TheGiraffe/BBB-Schematics-Resources/Other Formats/beaglebone-black-master/BBB_BOM.csv

QTY | REFERENCE | DESCRIPTION | MANU | PART NUMBER | REV PROD_C
1 |  | 3' USB Cable, 5pin AB to Type A | CableWholesale | 10UM-02103BK | Assembly marked as RevC
 |  |  | LingLongDa | 321010005
 |  |  | Molex | 887328602
1 |  | ESD Bag | 3M | 10035 | 3/24/13
1 |  | BOX
1 |  | BeagleBoneBlack PCB Assy Rev C
1 |  | 3.5" x 2.15" 6 Layer PCB, REV B6 | Various
24 | C1,C2,C4,C7,C8,C9,C10,C11,C12,C13,C14,C15,C39,C40,C55,C62,C77,C95,C96,C118,C122,C126,C133,C153 | CAP CER 10UF 10V Y5V 0805 | TDK | C2012Y5V1A106Z | Soon to be obsoleted.
 |  |  | Murata | GRM21BR71A106KE51L
 |  |  | YAGEO | CC0805ZKY5V6BB106
6 | C89,C90,C91,C104,C106,C134 | CAP CER 1UF 6.3V 10% X5R 0402 | Tayo Yuden | JMK105BJ105KV-F
 |  |  | TDK | C1005X5R0J105K
 |  |  | NIC | NMC0402X5R105K6.3TRPF
 |  |  | Murata | GRM155R60J105KE19D
 |  |  | YAGEO | CC0402KRX5R6BB105
9 | C16,C17,C18,C125,C144,C146,C148,C151,C24 | CAP CER 2.2UF 6.3V 10% X5R 0402 | TDK | C1005X5R0J225K | Soon to be obsoleted.
 |  |  | TDK | C1005X5R0J225K050BC
 |  |  | YAGEO | CC0402MRX5R5BB225
 |  |  | AVX | 04026D225KAT2A
 |  |  | YAGEO | CC0402MRX5R5BB225
2 | C19,C136 | CAP CER 470PF 50V 10% X7R 0402 | Yageo | CC0402KRX7R9BB471
 |  |  | Murata | GRM155R71H471KA01D
99 | C3,C20,C27,C28,C29,C30,C31,C33,C35,C36,C37,C38,C41,C42,C43,C44,C45,C46,C47,C48,C49,C50,C51,C52,C53,C54,C56,C57,C58,C59,C60,C61,C63,C64,C65,C66,C67,C68,C69,C70,C71,C72,C73,C74,C75,C76,C78,C79,C80,C81,C82,C83,C84,C85,C86,C87,C88,C92,C93,C94,C97,C98,C99,C100,C101,C102,C103,C105,C106,C107,C108,C109,C110,C111,C112,C113,C114,C115,C116,C117,C119,C120,C121,C124,C127,C128,C129,C130,C131,C132,C135,C145,C147,C149,C150,C152,C154,C155,C158,C159 | CAP CER 0.1UF 6.3V 10% X5R 0402 | TDK | C1005X5R0J104K | Soon to be obsoleted.
 |  |  | Murata | GRM155R60J104KA01D
 |  |  | NIC | NMC0402X5R104K6.3TRPF
 |  |  | Kemet | C0402C104K9PACTU
 |  |  | TDK | C1005X5R0J104K050BA
 |  |  | YAGEO | CC0402KRX7R7BB104
4 | C21,C22,C25,C26 | CAP CER 18PF 50V C0G 5% 0402 | TDK | C1005C0G1H180J
 |  |  | Murata | GRM1555C1H180JZ01D | Soon to be obsoleted.
 |  |  | NIC | NMC0402NPO180J50TRPF
 |  |  | Murata | GRM1555C1H180JA01D
 |  |  | YAGEO | CC0402JRNPO9BN180
2 | C32,C123 | CAP_CER_0.001UF_16V_X7R_0402 | Yageo | CC0402KRX7R7BB102
1 | C34 | Aluminum Electrolytic Capacitors - SMD 100uF 6.3V 85C | Cornell Dublier | AVE107M06D16T-F
 |  |  | ST | CS1A101M-CRE54
1 | C141 | CAP CER 0.022UF 10V 10% X7R 0402 | Tayo Yuden | LMK105B7223KV-F
 |  |  | YAGEO | CC0402KRX7R9BB223
2 | C142,C143 | CAP CER 30PF 50V 5% NP0 0402 | TDK | C1005C0G1H300J
 |  |  | Murata | GRM1555C1H300JA01D
 |  |  | YAGEO | CC0402JRNPO9BN330
16 | C156,C157,C160,C161,C162,C163,C164,C165,C166,C167,C168,C169,C170,C171,C172,C173 | CAP CER 47PF 50V 5% NPO 0402 | Yaego | CC0402JRNPO9BN470
 |  |  | Tayo Yuden | UMK105CG470JV-F
5 | D1,D2,D3,D4,D5 | LED BLUE CLEAR THIN 0603 SMD | Lite-On | LTST-C191TBKT
 |  |  | Everlight | 19-217/BHC-ZL1M2RY/3T
2 | D6,D7 | DIODE ESD PROT HDMI TSSOP-10 | NXP | IP4283CZ10-TT,118 | Soon to be obsoleted.
 |  |  | TI | TPD4S009DGSR
1 | D8 | DIODE SCHOTTKY 40V 120MA SOD-323 | NXP | RB751V40,115
6 | FB1,FB2,FB3,FB4,FB5,FB7 | Ferrite Bead 150 Ohm 800mA | Laird-Signal Integrity | LI0805H151R-10
3 | S1,S2,S3 | SWITCH TACTILE SPST-NO 0.05A 32V | C&K | KMR231GLFS
2 | Q1,Q2 | TRANS NPN/NPN W/RES 50V SMINI6 | Panasonic | DMC564040R
 |  |  | Diodes, Inc | DDC114YU-7-F
1 | RT1 | POLYSWITCH RXE SERIES 0.10A HOLD | TE Connectivity | RXEF010
3 | L1,L2,L3 | INDUCTOR 2.2UH 20% 1300MA 1008 | Murata | LQM2HPN2R2MG0L
1 | J1 | CONN HEADER 6POS, VERTICAL, .100 STR TIN | FCI | 68000-406HLF
 |  |  | YUXI å® ç | P125-1106A1BS116A1
2 | P8,P9 | NN HEADER FMAL 46PS.1" DL GOLD | MLE | SSHS-123-D-02-GT-LFÙ Ù Ù Ù
 |  |  | SINOTOP æ æ å± | FF-1236
 |  |  | Sullins | PPPC232LFBN-RC
1 | P1 | CONN POWER JACK 2.1MM | CUI | PJ-002A
 |  |  | CUI | PJ-002AH
 |  |  | MTCONN | DC630-20D01
1 | P4 | CONN RCPT USB MINI B R/A SMD | Hirose | UX60SC-MB-5ST(80)
1 | P5 | RJ-45 10/100 W/Magnetics | Link PP | LPJ0011BBNL
1 | P3 | CONN RCPT USB TYPE A R/A PCB | FCI | 87520-0010BLF
 |  |  | Foxconn | UB11123-4H9-4F
1 | P10 | Connector SD/MMC | ALPS | SCHA5B0200 | Soon to be obsoleted, no replacement found. Continues to fill orders.
1 | P6 | HDMI / Displayport / DVI Connectors MICRO HDMI RCPT SMT DIP+ SMT LEG TYPE D | FCI | 10118241-001RLF
6 | R23,R24,R25,R26,R163,R164 | RES 4.75K OHM 1/16W 1% 0402 SMD | Stackpole | RMCF0402FT4K75
 |  |  | KOA | RK73H1ETTP4751F
 |  |  | Vishay | CRCW04024K75FKED
 |  |  | NIC | NRC04F4751TRF
 |  |  | YAGEO | RC0402JR-074K7L
4 | R71,R72,R73,R74 | RES 2.2K-5%-1/16W;0402 SMD | YAGEO | RC0402JR-072K2L
1 | R144 | RES 12.1K OHM 1/16W 1% 0402 SMD | Yageo | RC0402FR-0712K1L
2 | R136,FB8 | RES .10 OHM 1/8W 5% 0805 | CTS | 73L3R10J
 |  |  | YAGEO | RL0805JR-070R1L
9 | R3,R4,R97,R112,R113,R114,R119,R146,R147 | RES 1.50K OHM 1/16W 1% 0402 SMD | Yageo | RC0402FR-071K5L
 |  |  | NIC | NRC04F1501TRF
3 | R12,R130,R132 | RES 470 OHM 1/10W 5% 0402 SMD | Panasonic | ERJ-2GEJ471X
 |  |  | YAGEO | RC0402JR-07470RL
22 | R1,R56,R65,R66,R67,R68, R76,R77,R78,R79,R80,R82,R83,R84,R85,R86, R87,R88, R89, R94,R95,R165 | Resistor 100Kohm 1/16W 1% 0402 | Stackpole | RMCF0402FT100K
 |  |  | Vishay | CRCW0402100KFKED
 |  |  | Yageo | RC0402FR-07100KL
 |  |  | NIC | NRC04F1003TRF
11 | R75,R125,R126,R127,R128,R129,R131,R133,R134,R138,R139 | RES 100 OHM 1/16W 5% 0402 SMD | Yageo | RC0402JR-07100RL
 |  |  | KOA | RK73B1ETTP101J
 |  |  | ROHM | MCR01MZPF1000
 |  |  | STACKPOLE | RMCF0402JT100R
 |  |  | NIC | NRC04J101TRF
1 | R143 | RES 10.0 OHM 1/16W 1% 0402 SMD | Yageo | RC0402FR-0710RL
 |  |  | KOA | RK73H1ETTP10R0F
 |  |  | STACKPOLE | RMCF0402FT10R0
 |  |  | NIC | NRC04F10R0TRF
22 | R5,R6,R7,R8,R19,R20,R27,R29,R30,R49,R50,R51,R137,R142,R149,R159,R160,R161,R162,R46,R47,R48.C127 | Resistor Zero ohm Jumper 0402 | Yageo | RC0402JR-070RL
 |  |  | VISHAY TECHNOLOGY | CRCW04020000Z0ED
 |  |  | STACKPOLE | RMCF0402ZT0R00
 |  |  | ROHM | MCR01MZPJ000
 |  |  | KOA | RK73Z1ETTP
 |  |  | NIC | NRC040TRF
1 | R45 | Resistor 22ohm 1/16W 1% 0402 | Yageo | RC0402FR-0722RL
 |  |  | KOA | RK73B1ETTP220J
 |  |  | Stackpole | RMCF0402JT33R0
 |  |  | Vishay | CRCW040222R0JNED
 |  |  | NIC | NRC04J220TRF
34 | R14,R52,R53,R54,R96,R98,R100,R101,R102,R103,R104,R105,R106,R107,R108,R109,R110,R111,R115,R116,R117,R118,R135,R145,R148,R150,R151,R152,R153,R154,R155,R156,R157,R158 | Resistor 10Kohm 1/16W 5% 0402 | Rohm | MCR01MZPJ103
 |  |  | KOA | RK73B1ETTP103J
 |  |  | ROHM | MCR01MRTJ103
 |  |  | Stackpole | RMCF0402JT10K0
 |  |  | Vishay | CRCW040210K0JNED
 |  |  | YAGEO | RC0402FR-0710KL
1 | R17 | Resistor 1Mohm 1/16W 1% 0402 | Stackpole | RMCF0402FT1M00
 |  |  | Vishay | CRCW04021M00FKED
 |  |  | Yageo | RC0402FR-071ML
 |  |  | NIC | NRC04F1004TRF
5 | R22,R120,R121,R122,R123 | RES 49.9 OHM 1/16W 1% 0402 SMD | Yageo | RC0402FR-0749R9L
 |  |  | KOA | RK73H1ETTP49R9F
 |  |  | NIC | NRC04F49R9TRF
1 | R11 | RES TF 1/16W 280K OHM 1% 0402 | Stackpole | RMCF0402FT280K
 |  |  | Vishay | CRCW0402280KFKED
 |  |  | NIC | NRC04F2803TRF
 |  |  | YAGEO | RC0402FR-07280KL
1 | R99 | RES 240 OHM 1/16W 1% 0402 SMD | Yageo | RC0402FR-07240RL
 |  |  | Stackpole | RMCF0402FT240R
 |  |  | ROHM | MCR01MZPF2400
 |  |  | Vishay | CRCW0402240RFKED
 |  |  | NIC | NRC04F2400TRF
1 | R10 | RES 470K OHM 1/16W 1% 0402 SMD | Yageo | RC0402FR-07470KL
 |  |  | Stackpole | RMCF0402FT470K
 |  |  | Vishay | CRCW0402470KFKED
 |  |  | NIC | NRC04F4703TRF
1 | R166 | RES 27K OHM 1/16W 1% 0402 SMD | Yageo | RC0402FR-0727KL
 |  |  | NIC | NRC04F2702TRF
4 | R18,R21,R28,R167 | RES 33 OHM 1/16W 5% 0402 SMD | Yageo | RC0402JR-0733RL
 |  |  | KOA | RK73B1ETTP330J
 |  |  | Stackpole | RMCF0402JT33R0
 |  |  | Vishay | CRCW040233R0JNED
 |  |  | NIC | NRC04J330TRF
1 | U2 | Integrated Power Management Unit | TI | TPS65217CRSLR
1 | U5 | AM3358B, SubArctic Cortex A8 Processor 15x15,1GHz, 2.1 | TI | AM3358BZCZ100
2 | U9,U10 | IC 4CH ESD SOLUTION W/CLAMP 6SON | TI | TPD4S012DRYR
1 | U4 | IC LDO VOLT REG 500MA 8-SOIC | TI | TL5209DR
1 | U8 | IC 1.5A PWR DIST SWITCH 8-SOIC | TI | TPS2051BDGNR
1 | U6 | IC SGL POS EDG TRIG D F-F SM8 | TI | SN74LVC1G74DCTR
1 | U15 | IC BUFF/DVR TRI-ST DL 8VSSOP | TI | SN74LVC2G241DCUR
1 | U3 | IC INVERTER SINGLE 1INPUT SC705 | TI | SN74LVC1G06DCKR
1 | U12 | DDR3 Memory 4Gb,256Mx16 | Micron | MT41K256M16HA-125:E
 |  |  | Micron | MT41K256M16TW-107:P
 |  |  | Kingston | D2516EC4BXGGB
 |  |  | Kingston | D2516EC4BXGGB-U
1 | U13 | IC MEMORY, 4GB eMMC | Micron | MTFC4GLDEA 0M WT
 |  |  | Micron | MTFC4GMCDM-1M WT
 |  |  | Micron | MTFC4GACAJCN-1M WT
 |  |  | Kingston | EMMC04G-S100-A08U
 |  |  | Kingston | KE4CN2H5A-A58
 |  |  | Kingston | EMMC04G-M627-X02U
1 | U7 | IC EEPROM 32KBIT 400KHZ SOT23-5 | MicroChip | 24LC32AT-I/OT
1 | U14 | ETHERNET PHY | SMSC | LAN8710A-EZC-TR
 |  |  | Microchip | LAN8710A-EZC-TR
1 | U11 | IC HDMI INTERFACE HVQFN64 | NXP | TDA19988BHN/C1,557
1 | U16 | IC BUFF/DVR NON-INVERT SC705 | TI | SN74LVC1G07DCKR
1 | Y1 | CRYSTAL 32.768KHZ 12.5PF SMD | Citizen | CM200C-32.768KAZF-UT
 |  |  | Abracon | ABS25-32.768KHZ-T
1 | Y3 | CRYSTAL 25.000 MHZ 18PF SMD | TXC | 7A-25.000MAAJ-T
 |  |  | TXC | 7A25000007
 |  |  | CTS | 445C33D25M00000
 |  |  | ILS | ILCX03-25.000000M-TBA
 |  |  | INTERQUIP | 5XBB25000202TF40Q3
1 | Y2 | CRYSTAL 24.000 MHZ 18PF SMD | TXC | 7A-24.000MAAJ-T
 |  |  | TXC | 7A24000014
 |  |  | CTS | 445C33D24M00000
 |  |  | ILS | ILCX03-24.000000M-TBA
 |  |  | INTERQUIP | 5XBB24000202TF50Q3
1 | Y4 | Oscillator, 24.576MHZ, 3.3V | Abracom | ASDMB-24.576MHZ-LC-T
 |  |  | ECS | ECS-2033-24.576-B
 |  |  | ILSI | ISM95-3161BH-24.576
 |  |  | TXC | 8W24500007
 |  |  | INTERQUIP | 1651-24575-BTBQYA
 | DO NOT INSTALL COMPONENTS BELOW.
 | C137,C138,C139,C140,P2,R55,R57,R58,R59,R60,R61,R62,R63,R64,R69,R70,R81,R90,R91,R92,R93,R124,R140,R141,R9
 | THESE REFERENCE DESIGNATORS ARE NOT USED: P7,FB6
