TheGiraffe/BBB-Schematics-Resources/Other Formats/beaglebone-black-master/MFG/BeagleBone_Black_RevB6_ASSY_XY.xlsx

Sheet: symbol origins
UUNITS = MILS
U16 | 1250 | 338 | 180 |  | DCK5_2P15X1P4
R12 | 150 | 650 | 0 | m | 402
R71 | 250 | 1750 | 180 |  | 402
R72 | 250 | 1862.5 | 180 |  | 402
R73 | 250 | 1825 | 180 |  | 402
R74 | 250 | 1787.5 | 180 |  | 402
R45 | 1975 | 1730 | 90 |  | 402
R46 | 2025 | 1730 | 90 |  | 402
R47 | 2025 | 1590 | 90 |  | 402
R48 | 1975 | 1590 | 90 |  | 402
FB8 | 2520 | 440 | 180 | m | SM-7351-IND-0805
P3 | 2887.5 | 525 | 90 |  | USB_A_SH
P5 | 575 | 1350 | 270 |  | RJ45-7499010211A
P6 | 3332.68 | 990 | 90 | m | CONN19_HDMI
R119 | 1200 | 1325 | 180 |  | 402
R146 | 3025 | 1062.5 | 180 | m | 402
R3 | 1025 | 862.5 | 270 |  | 402
R4 | 1062.5 | 862.5 | 270 |  | 402
R147 | 3025 | 1112.5 | 180 | m | 402
R75 | 2900 | 1850 | 270 |  | 402
R99 | 2700 | 864.75 | 0 | m | SM-7351-RES-0402
U5 | 1800 | 1150 | 180 |  | AM33XX_15X15
TP9 | 920 | 865 | 0 |  | TP60C33D
TP5 | 580 | 420 | 0 |  | TP60C33D
TP6 | 580 | 320 | 0 |  | TP60C33D
TP7 | 680 | 420 | 0 |  | TP60C33D
TP8 | 680 | 320 | 0 |  | TP60C33D
P4 | 240 | 1737.5 | 180 | m | USB5MINI_4SHIELDED_SMD-5
R167 | 1612.5 | 1650 | 90 | m | 402
R18 | 1650 | 450 | 90 | m | 402
R21 | 1900 | 450 | 90 | m | 402
R28 | 1350 | 1095 | 180 |  | 402
C156 | 2175 | 1730 | 90 |  | 402
C157 | 2125 | 1590 | 90 |  | 402
C160 | 2175 | 1590 | 270 |  | 402
C161 | 2025 | 1590 | 270 | m | 402
C162 | 2075 | 1590 | 270 | m | 402
C163 | 2225 | 1590 | 90 |  | 402
C164 | 1975 | 1590 | 270 | m | 402
C165 | 2175 | 1850 | 270 |  | 402
C166 | 2075 | 1590 | 90 |  | 402
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
R149 | 2625 | 1725 | 90 | m | 402
R19 | 1637.5 | 775 | 90 | m | 402
R20 | 1675 | 775 | 270 | m | 402
R27 | 1756.25 | 762.5 | 180 |  | 402
TP4 | 150 | 750 | 0 |  | TP1-8040
TP1 | 2325 | 425 | 0 |  | TP1-8040
U9 | 3123.9 | 725 | 270 | m | U_6_DRY
U10 | 512.5 | 1650 | 270 |  | U_6_DRY

Sheet: body centers
UUNITS = MILS
U16 | 1250 | 338 | 180 |  | DCK5_2P15X1P4
R12 | 150 | 650 | 0 | m | 402
R71 | 250 | 1750 | 180 |  | 402
R72 | 250 | 1862.5 | 180 |  | 402
R73 | 250 | 1825 | 180 |  | 402
R74 | 250 | 1787.5 | 180 |  | 402
R45 | 1975 | 1730 | 90 |  | 402
R46 | 2025 | 1730 | 90 |  | 402
R47 | 2025 | 1590 | 90 |  | 402
R48 | 1975 | 1590 | 90 |  | 402
FB8 | 2520 | 440 | 180 | m | SM-7351-IND-0805
P3 | 3123.2 | 662.1 | 90 |  | USB_A_SH
P5 | 322.5 | 1175 | 270 |  | RJ45-7499010211A
P6 | 3273.62 | 990 | 90 | m | CONN19_HDMI
R119 | 1200 | 1325 | 180 |  | 402
R146 | 3025 | 1062.5 | 180 | m | 402
R3 | 1025 | 862.5 | 270 |  | 402
R4 | 1062.5 | 862.5 | 270 |  | 402
R147 | 3025 | 1112.5 | 180 | m | 402
R75 | 2900 | 1850 | 270 |  | 402
R99 | 2700 | 864.75 | 0 | m | SM-7351-RES-0402
U5 | 1800 | 1150 | 180 |  | AM33XX_15X15
TP9 | 920 | 865 | 0 |  | TP60C33D
TP5 | 580 | 420 | 0 |  | TP60C33D
TP6 | 580 | 320 | 0 |  | TP60C33D
TP7 | 680 | 420 | 0 |  | TP60C33D
TP8 | 680 | 320 | 0 |  | TP60C33D
P4 | 121.89 | 1737.5 | 180 | m | USB5MINI_4SHIELDED_SMD-5
R167 | 1612.5 | 1650 | 90 | m | 402
R18 | 1650 | 450 | 90 | m | 402
R21 | 1900 | 450 | 90 | m | 402
R28 | 1350 | 1095 | 180 |  | 402
C156 | 2175 | 1730 | 90 |  | 402
C157 | 2125 | 1590 | 90 |  | 402
C160 | 2175 | 1590 | 270 |  | 402
C161 | 2025 | 1590 | 270 | m | 402
C162 | 2075 | 1590 | 270 | m | 402
C163 | 2225 | 1590 | 90 |  | 402
C164 | 1975 | 1590 | 270 | m | 402
C165 | 2175 | 1850 | 270 |  | 402
C166 | 2075 | 1590 | 90 |  | 402
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
R149 | 2625 | 1725 | 90 | m | 402
R19 | 1637.5 | 775 | 90 | m | 402
R20 | 1675 | 775 | 270 | m | 402
R27 | 1756.25 | 762.5 | 180 |  | 402
TP4 | 150 | 750 | 0 |  | TP1-8040
TP1 | 2325 | 425 | 0 |  | TP1-8040
U9 | 3123.9 | 725 | 270 | m | U_6_DRY
U10 | 512.5 | 1650 | 270 |  | U_6_DRY

Sheet: pin 1
UUNITS = MILS
U16 | 1275.59 | 381.31 | 180 |  | DCK5_2P15X1P4
R12 | 170 | 650 | 0 | m | 402
R71 | 270 | 1750 | 180 |  | 402
R72 | 270 | 1862.5 | 180 |  | 402
R73 | 270 | 1825 | 180 |  | 402
R74 | 270 | 1787.5 | 180 |  | 402
R45 | 1975 | 1710 | 90 |  | 402
R46 | 2025 | 1710 | 90 |  | 402
R47 | 2025 | 1570 | 90 |  | 402
R48 | 1975 | 1570 | 90 |  | 402
FB8 | 2482.6 | 440 | 180 | m | SM-7351-IND-0805
P3 | 2887.5 | 525 | 90 |  | USB_A_SH
P5 | 575 | 1350 | 270 |  | RJ45-7499010211A
P6 | 3145.08 | 919.13 | 90 | m | CONN19_HDMI
R119 | 1220 | 1325 | 180 |  | 402
R146 | 3005 | 1062.5 | 180 | m | 402
R3 | 1025 | 882.5 | 270 |  | 402
R4 | 1062.5 | 882.5 | 270 |  | 402
R147 | 3005 | 1112.5 | 180 | m | 402
R75 | 2900 | 1870 | 270 |  | 402
R99 | 2720 | 864.75 | 0 | m | SM-7351-RES-0402
U5 | 1800 | 1150 | 180 |  | AM33XX_15X15
TP9 | 920 | 865 | 0 |  | TP60C33D
TP5 | 580 | 420 | 0 |  | TP60C33D
TP6 | 580 | 320 | 0 |  | TP60C33D
TP7 | 680 | 420 | 0 |  | TP60C33D
TP8 | 680 | 320 | 0 |  | TP60C33D
P4 | 240 | 1674.51 | 180 | m | USB5MINI_4SHIELDED_SMD-5
R167 | 1612.5 | 1670 | 90 | m | 402
R18 | 1650 | 470 | 90 | m | 402
R21 | 1900 | 470 | 90 | m | 402
R28 | 1370 | 1095 | 180 |  | 402
C156 | 2175 | 1710 | 90 |  | 402
C157 | 2125 | 1570 | 90 |  | 402
C160 | 2175 | 1610 | 270 |  | 402
C161 | 2025 | 1570 | 270 | m | 402
C162 | 2075 | 1570 | 270 | m | 402
C163 | 2225 | 1570 | 90 |  | 402
C164 | 1975 | 1570 | 270 | m | 402
C165 | 2175 | 1870 | 270 |  | 402
C166 | 2075 | 1570 | 90 |  | 402
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
R149 | 2625 | 1745 | 90 | m | 402
R19 | 1637.5 | 795 | 90 | m | 402
R20 | 1675 | 755 | 270 | m | 402
R27 | 1776.25 | 762.5 | 180 |  | 402
TP4 | 150 | 750 | 0 |  | TP1-8040
TP1 | 2325 | 425 | 0 |  | TP1-8040
U9 | 3106.62 | 705.32 | 270 | m | U_6_DRY
U10 | 495.22 | 1669.68 | 270 |  | U_6_DRY
