TheGiraffe/BBB-Schematics-Resources/Other Formats/BeagleBoneBlack/BeagleBoneBlack (Schematic).pdf

cable is not plugged in.

## 8. Added Modification to add 100K ohm resistor to ground to prvent crosstalk when serial

connector. Required to pass FCC/CE testing due to noise emissions on that pin.

## 6. Added Ferrite beads in series with LED power and 5V power rail of the USB host

system.

## 7. Added power button to enable sleep, wakeup, power down and power up features on the

5. Added access point for the battery function of the TPS65217C. | 2/28/2013 | GC
4. Changed a few footprints after PCB update for above changes.

A5A

3. Changed schematic revision to A5A.
2. Added 47pf capacitors C156-C173 to LCD data lines to ground.
1. Deleted R29-R44 from the LCD lines.

GC 1/2/2013
Parts while marked AM3359 were actually AM3352. This revision uses the correct parts.
A5 | On the initial production release the processors were incorrect as supplied by TI.
A4A | Initial production Release. | 11/19/2012 | GC
REV | Description | DATE | BY

NOTE: PCB Revision for this board is Rev B4.

11 | EXP CONN, uSD

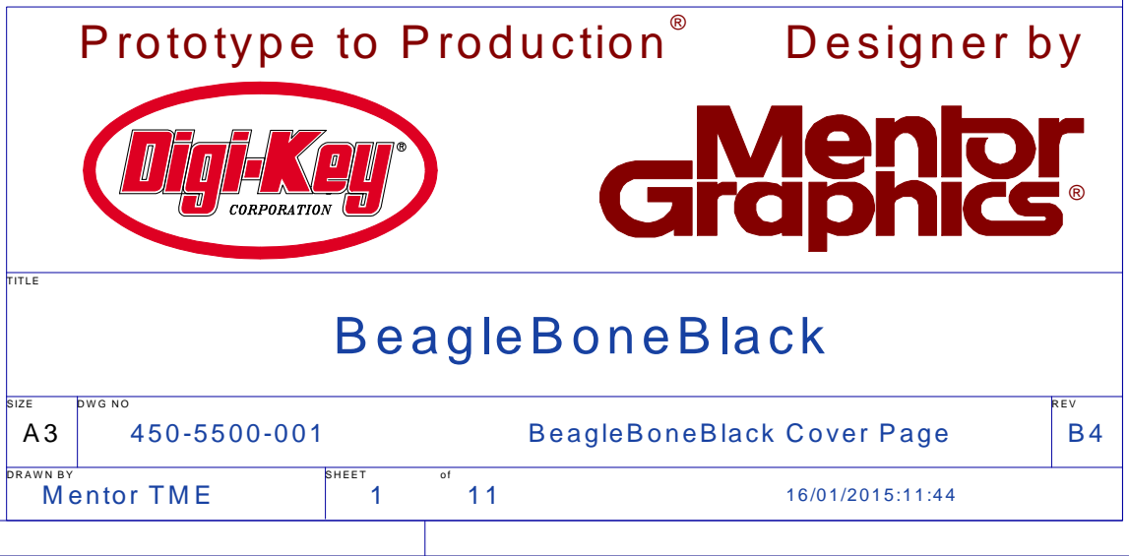
[picture p15: figure]
REV; TITLE; SIZE; DWG NO; SHEET; DRAWN BY; Designer by; CORPORATION; Prototype to Production; Cover Page; BeagleBoneBlack; Mentor TME

NECESSARY SERVICING, REPAIR OR CORRECTION.

# THE DESIGN PROVE DEFECTIVE, YOU ASSUME THE COST OF ALL

# QUALITY AND PERFORMANCE OF THE DESIGN IS WITH YOU. SHOULD

# FOR A PARTICULAR PURPOSE. THE ENTIRE RISK AS TO THE

# TO, THE IMPLIED WARRANTIES OF MERCHANTABILITY AND FITNESS

# EITHER EXPRESSED OR IMPLIED, INCLUDING, BUT NOT LIMITED

PROVIDE THE DESIGN “AS IS” WITHOUT WARRANTY OF ANY KIND,

# IN WRITING THE COPYRIGHT HOLDERS AND/OR OTHER PARTIES

# PERMITTED BY APPLICABLE LAW. EXCEPT WHEN OTHERWISE STATED

# THERE IS NO WARRANTY FOR THIS DESIGN , TO THE EXTENT

via resources at BeagleBoard.org/discuss.

# a reference design. Only “community” support is allowed

# This schematic is *NOT SUPPORTED* and DOES NOT constitute

6

# COVER PAGE

5

# POWER MANAGEMENT

4

# PROCESSOR 1 OF 3, JTAG HEADER

# PROCESSOR 3 OF 3

PAGE NO. | SCHEMATIC PAGE

# LED, CONFIGURATION AND BUTTON

7

# PROCESSOR 2 OF 3, UAB PORTS

# DDR3 MEMORY

10

# 10/100 ETHERNET

# HDMI FRAMER

2

3

9

# eMMC FLASH

1

8

1) Updated the PCB to incorporate the modification that was being done on Rev A5A. There is NO DIFFERENCE AT ALL in functionality between REV A5A and REV A5B.

A5B

2) Made the LEDs dimmer for those that could not sleep due to the brightness of the LEDs.

A5C

## Production had some fallout of boards when running the HDMI tests in the previous

production run. Resistor values were tweaked to improve the test results.

No changes in features or operation of the board.
1) Changed R46,R47,R48 to a 0 ohm.
2) Changed R45 to a 22 Ohm.

## 3) Converted to DxDesigner/PADS 9.5

5/21/2013

7/11/2013

GC

GL

be populated.

# cape or wires. Pins will not

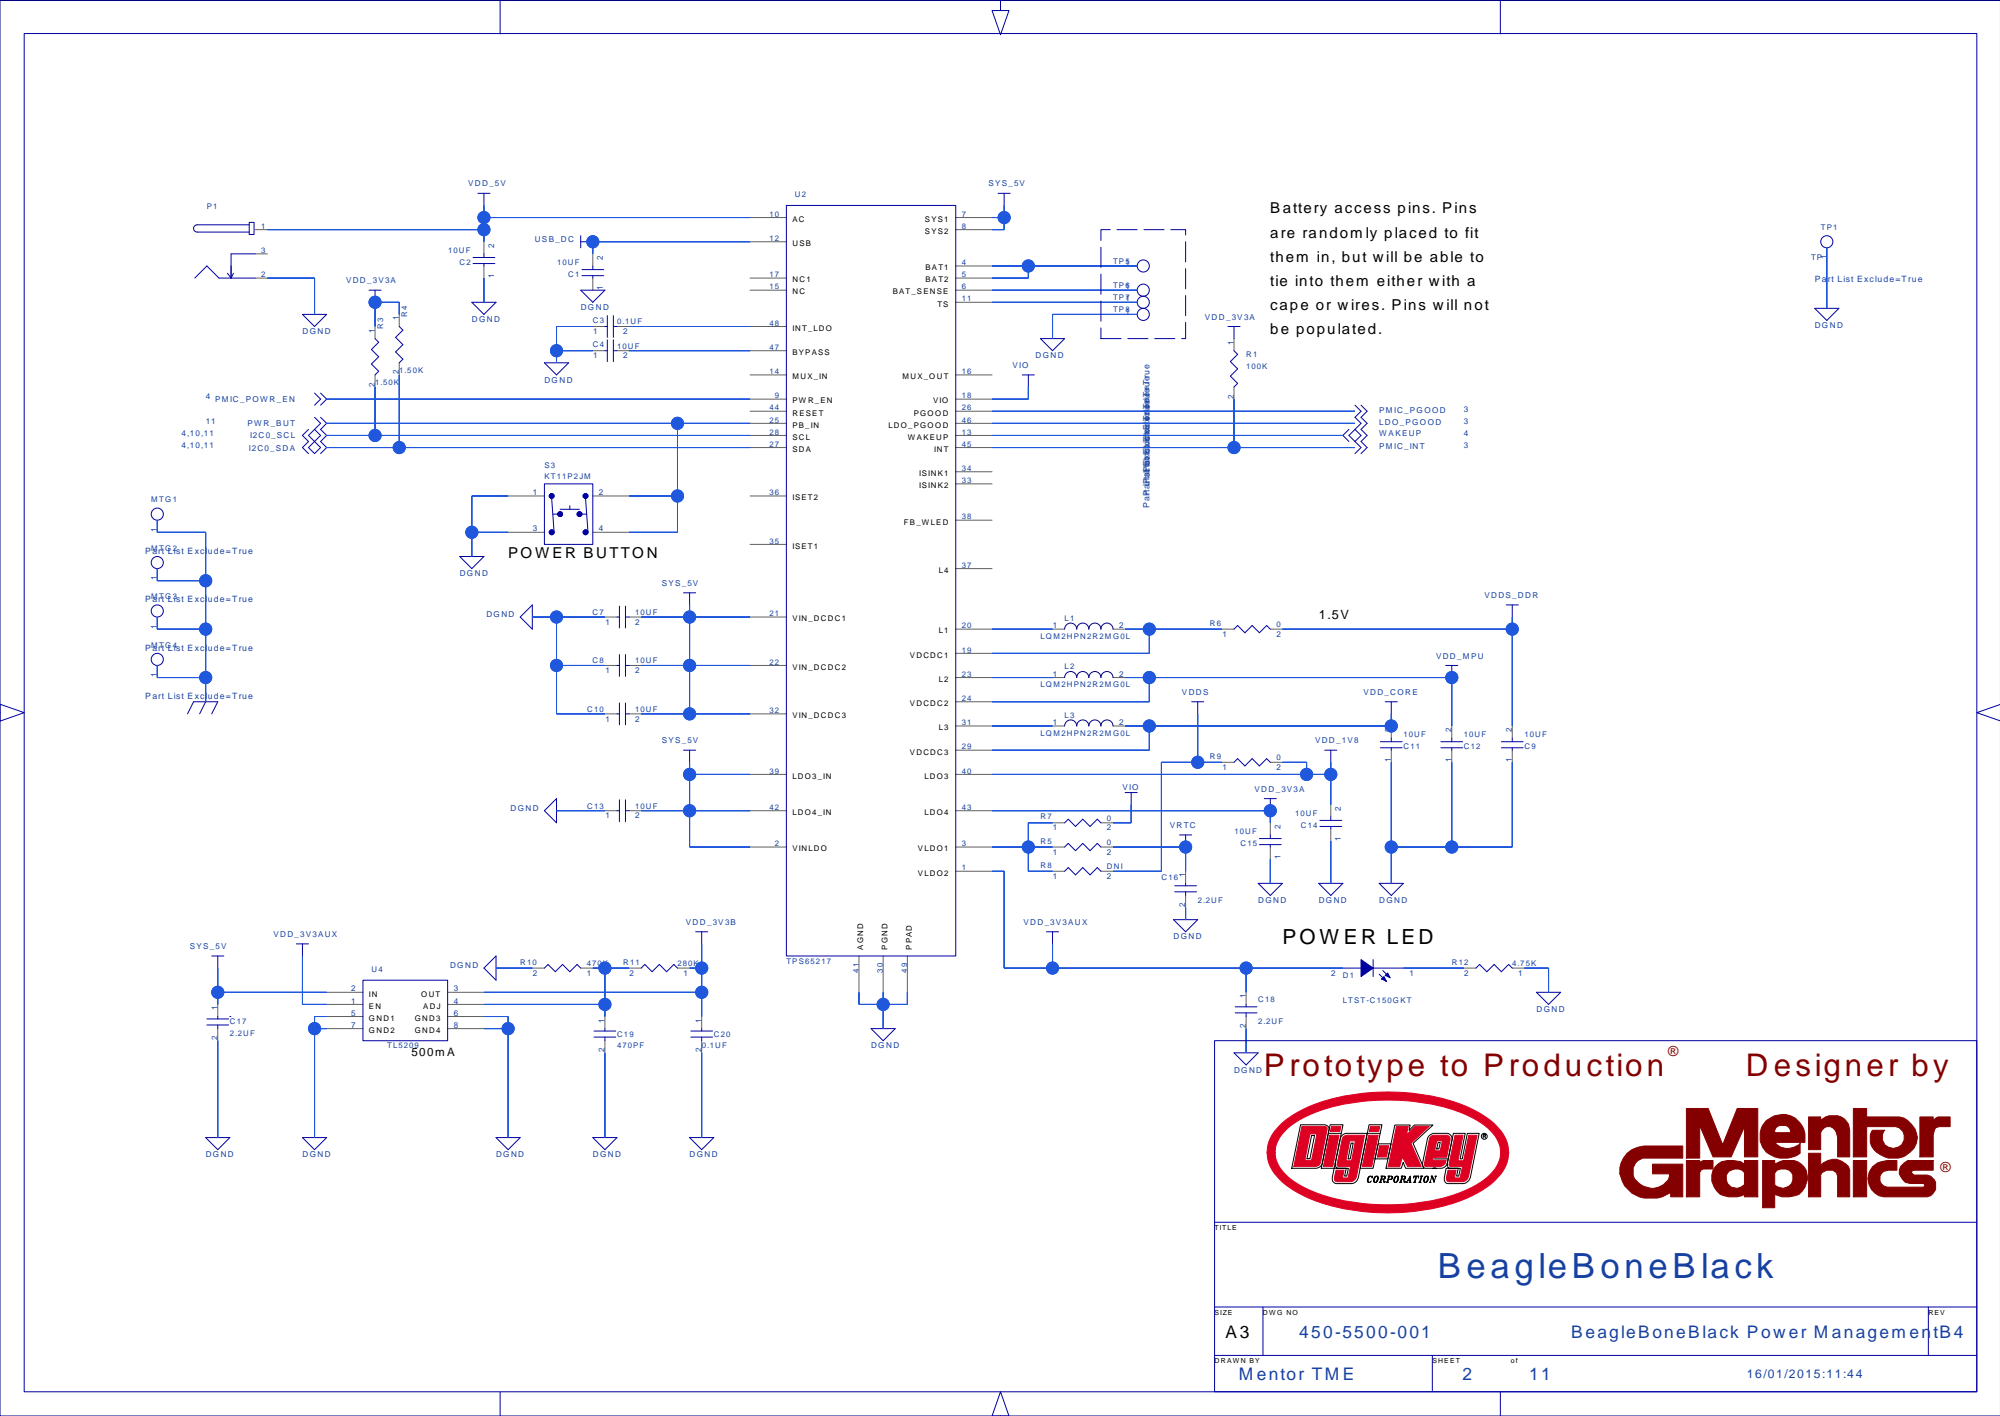
[picture p16: page 2]

Battery access pins. Pins
are randomly placed to fit
them in, but will be able to
tie into them either with a

Part List Exclude=True

# SubArctic AM335x

3.3V

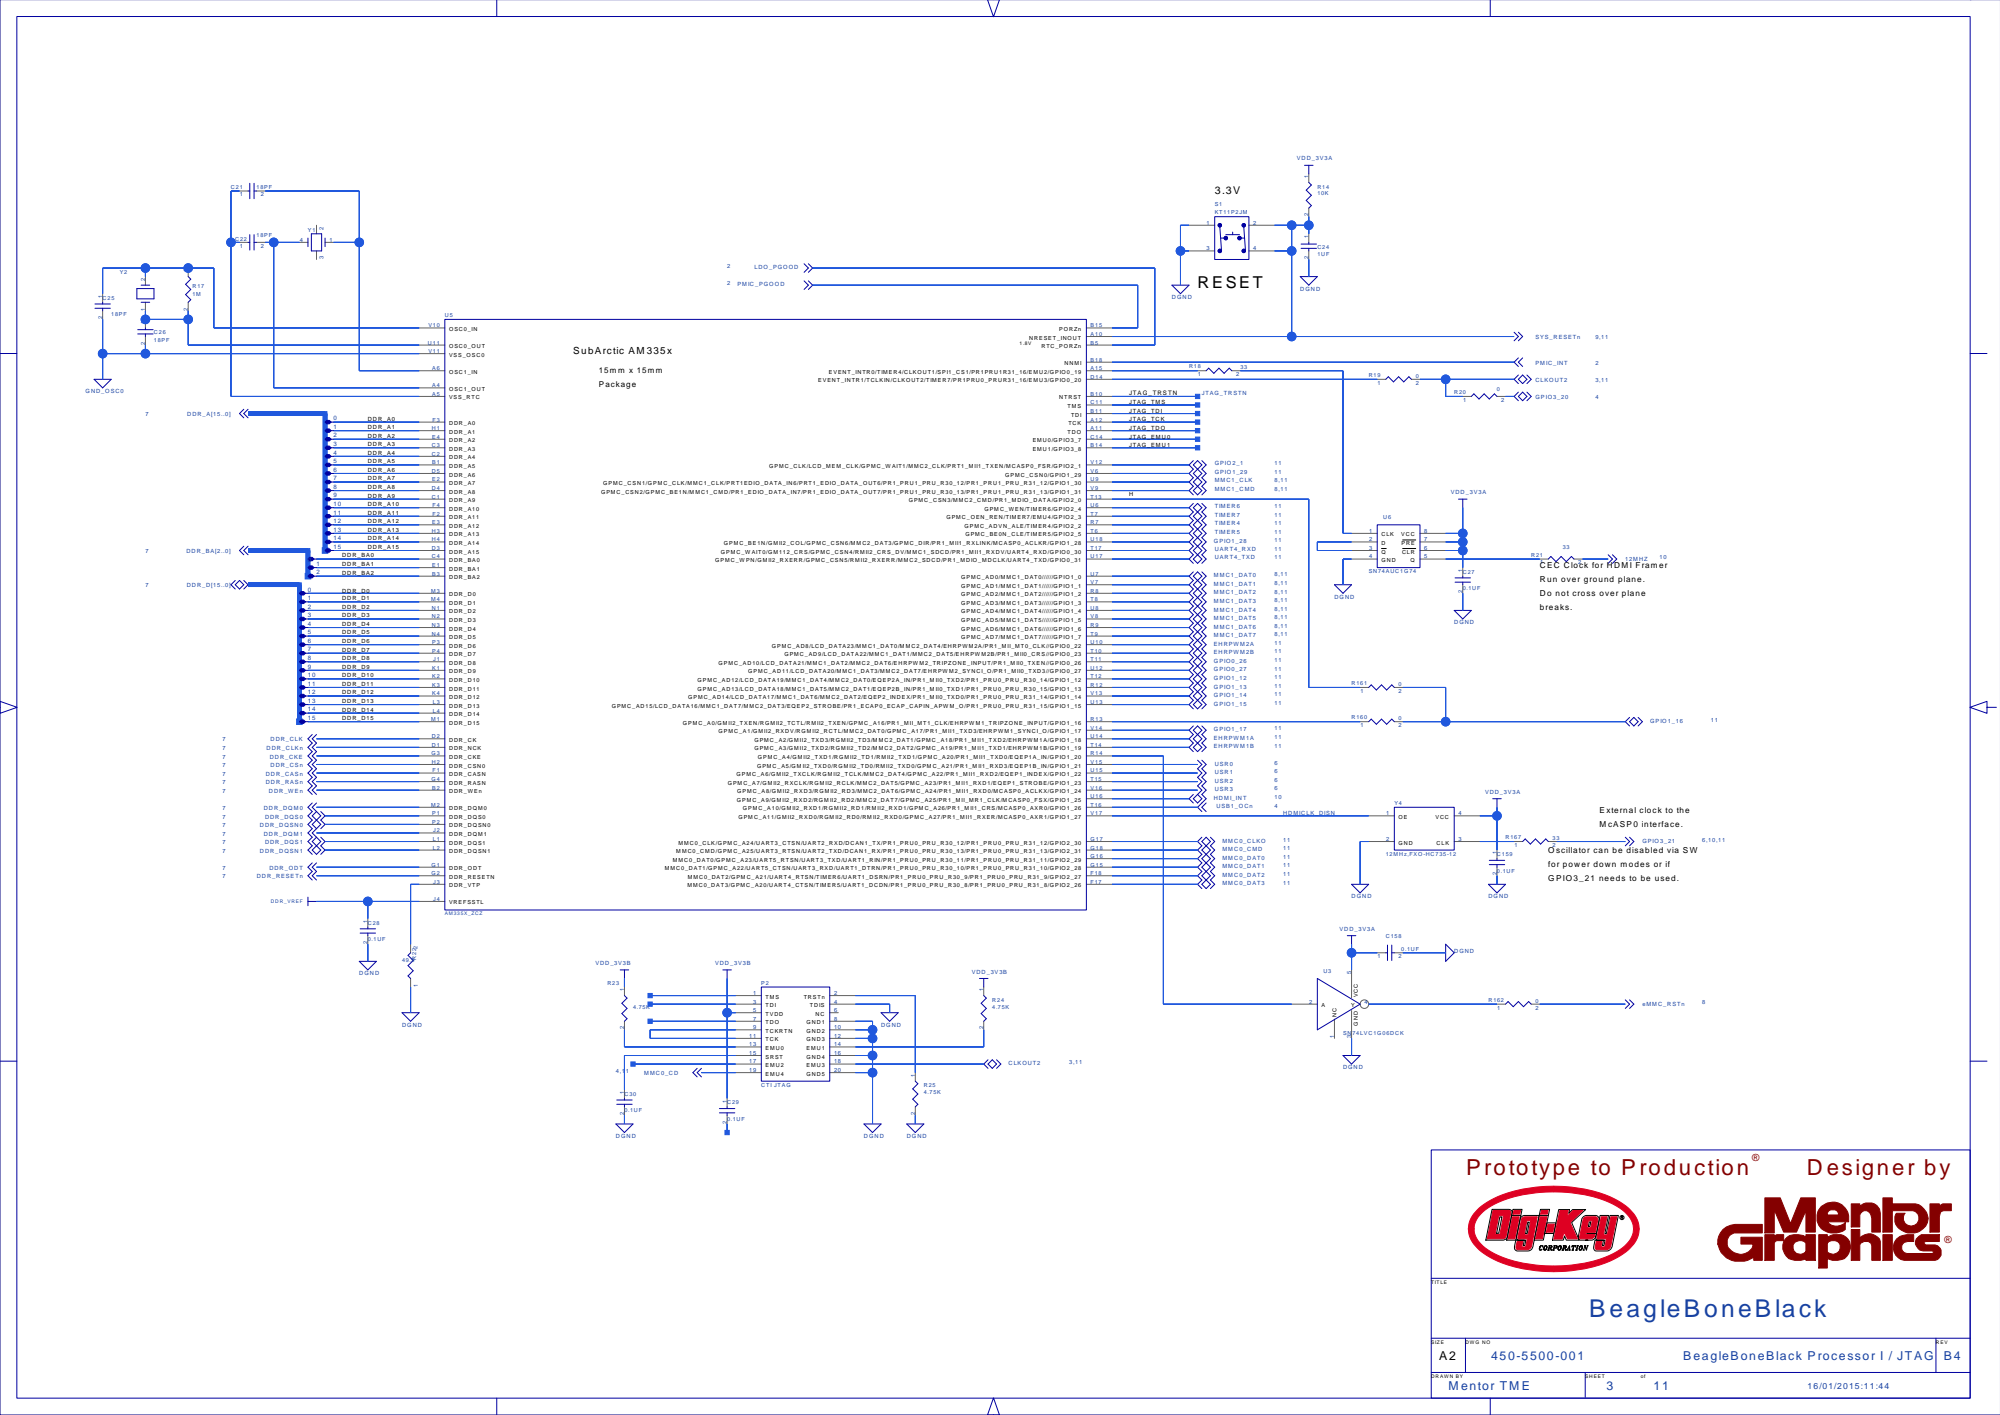
[picture p17: page 3]

CEC Clock for HDMI Framer
Run over ground plane.
Do not cross over plane
breaks.

External clock to the
McASP0 interface.

Oscillator can be disabled via SW
for power down modes or if
GPIO3_21 needs to be used.

# SubArctic AM335X

## 15mm x 15mm

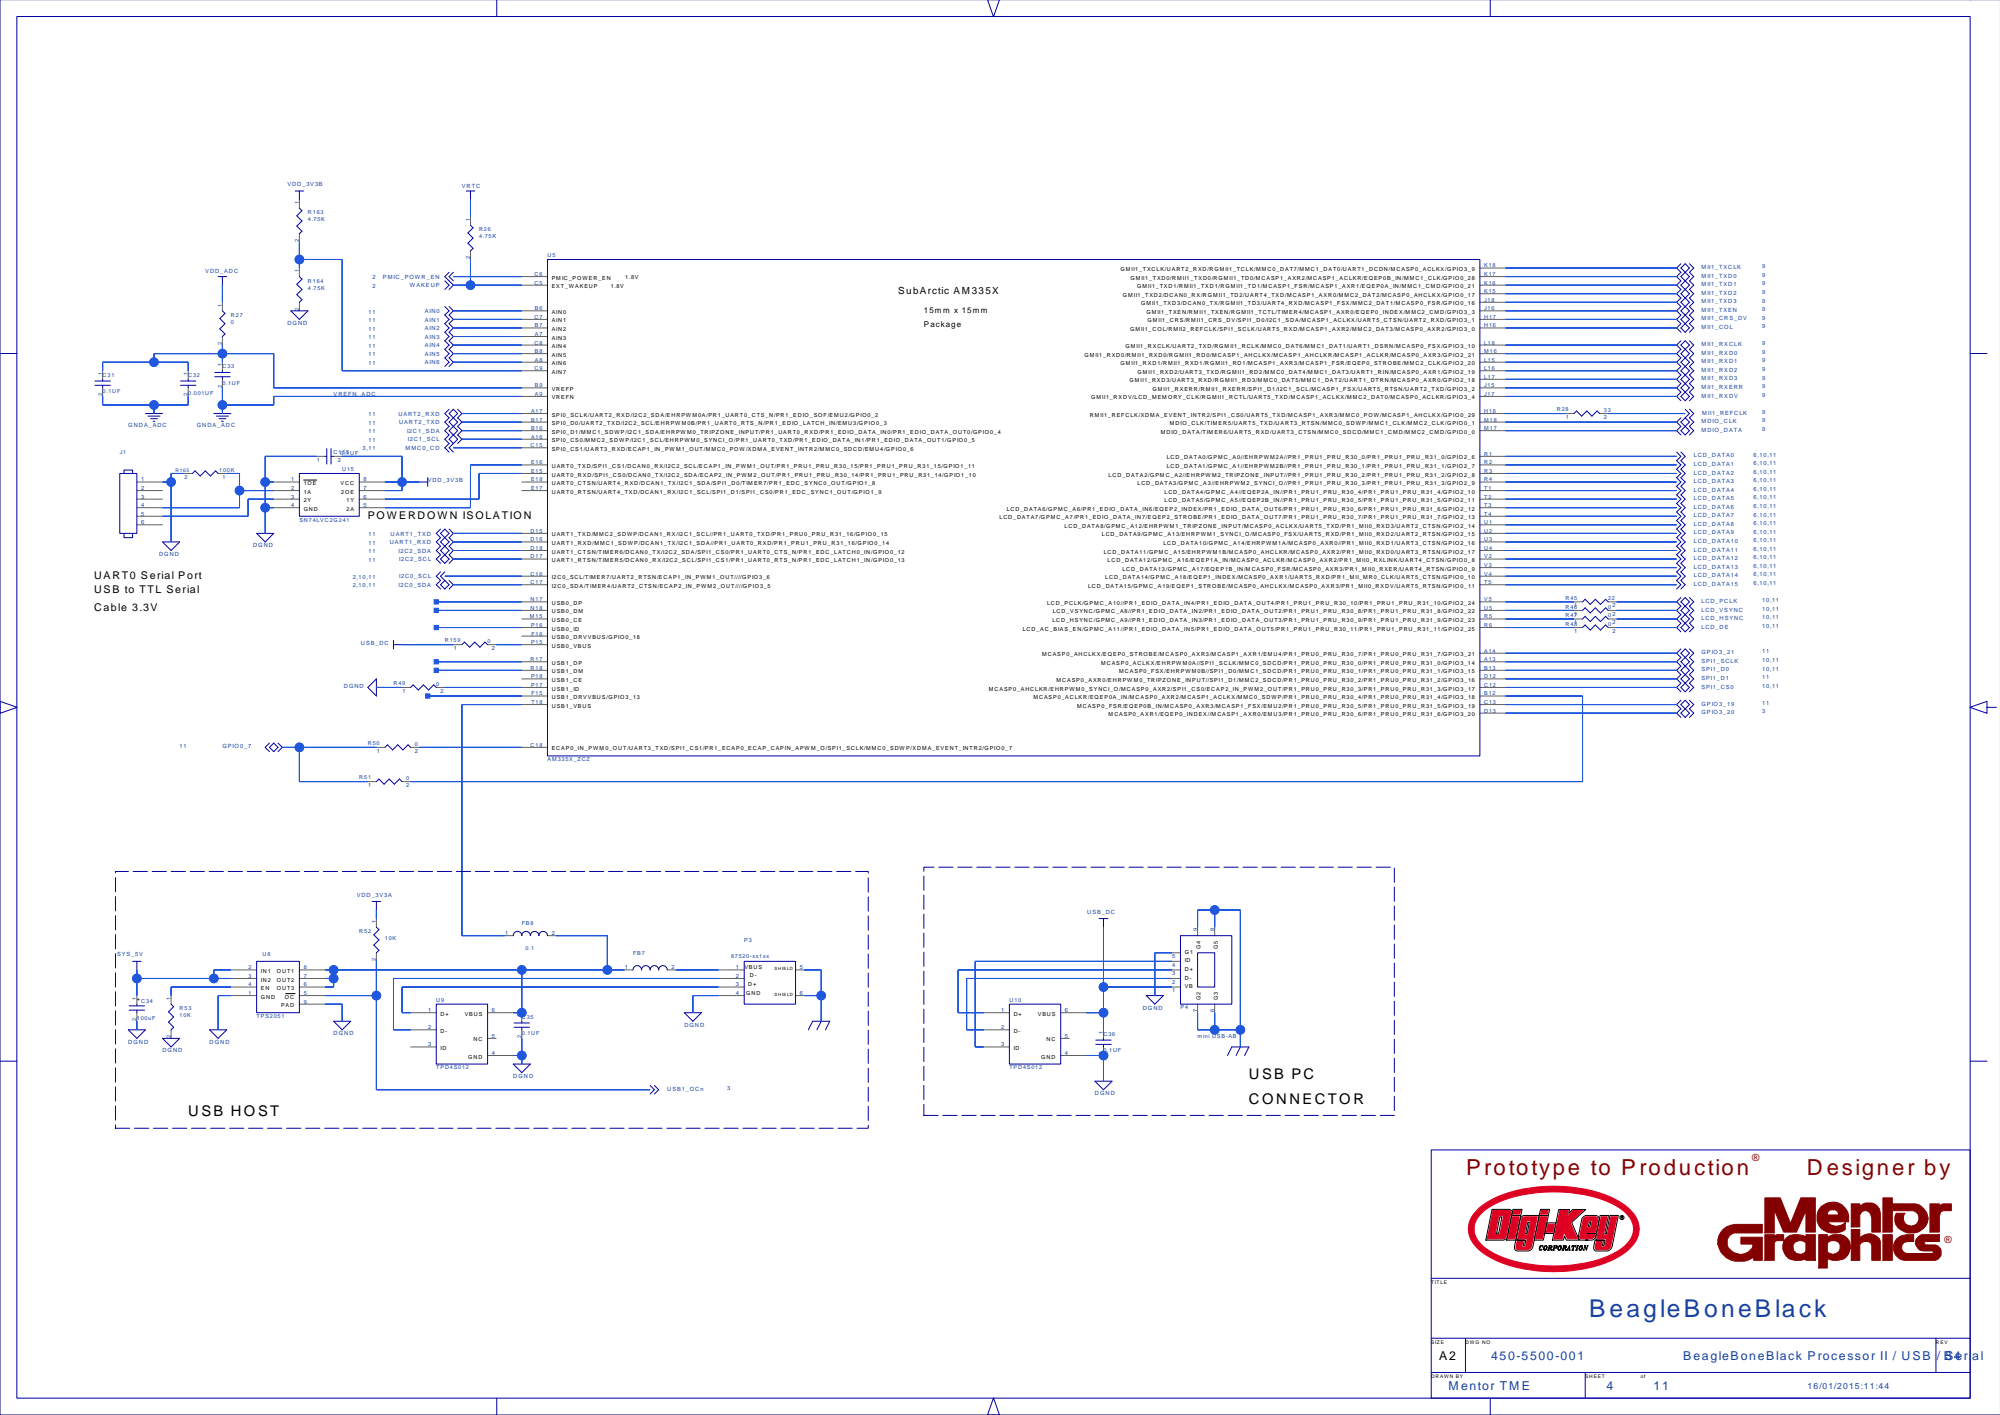
[picture p18: page 4]

UART0 Serial Port
USB to TTL Serial
Cable 3.3V

Processor II / USB / Serial

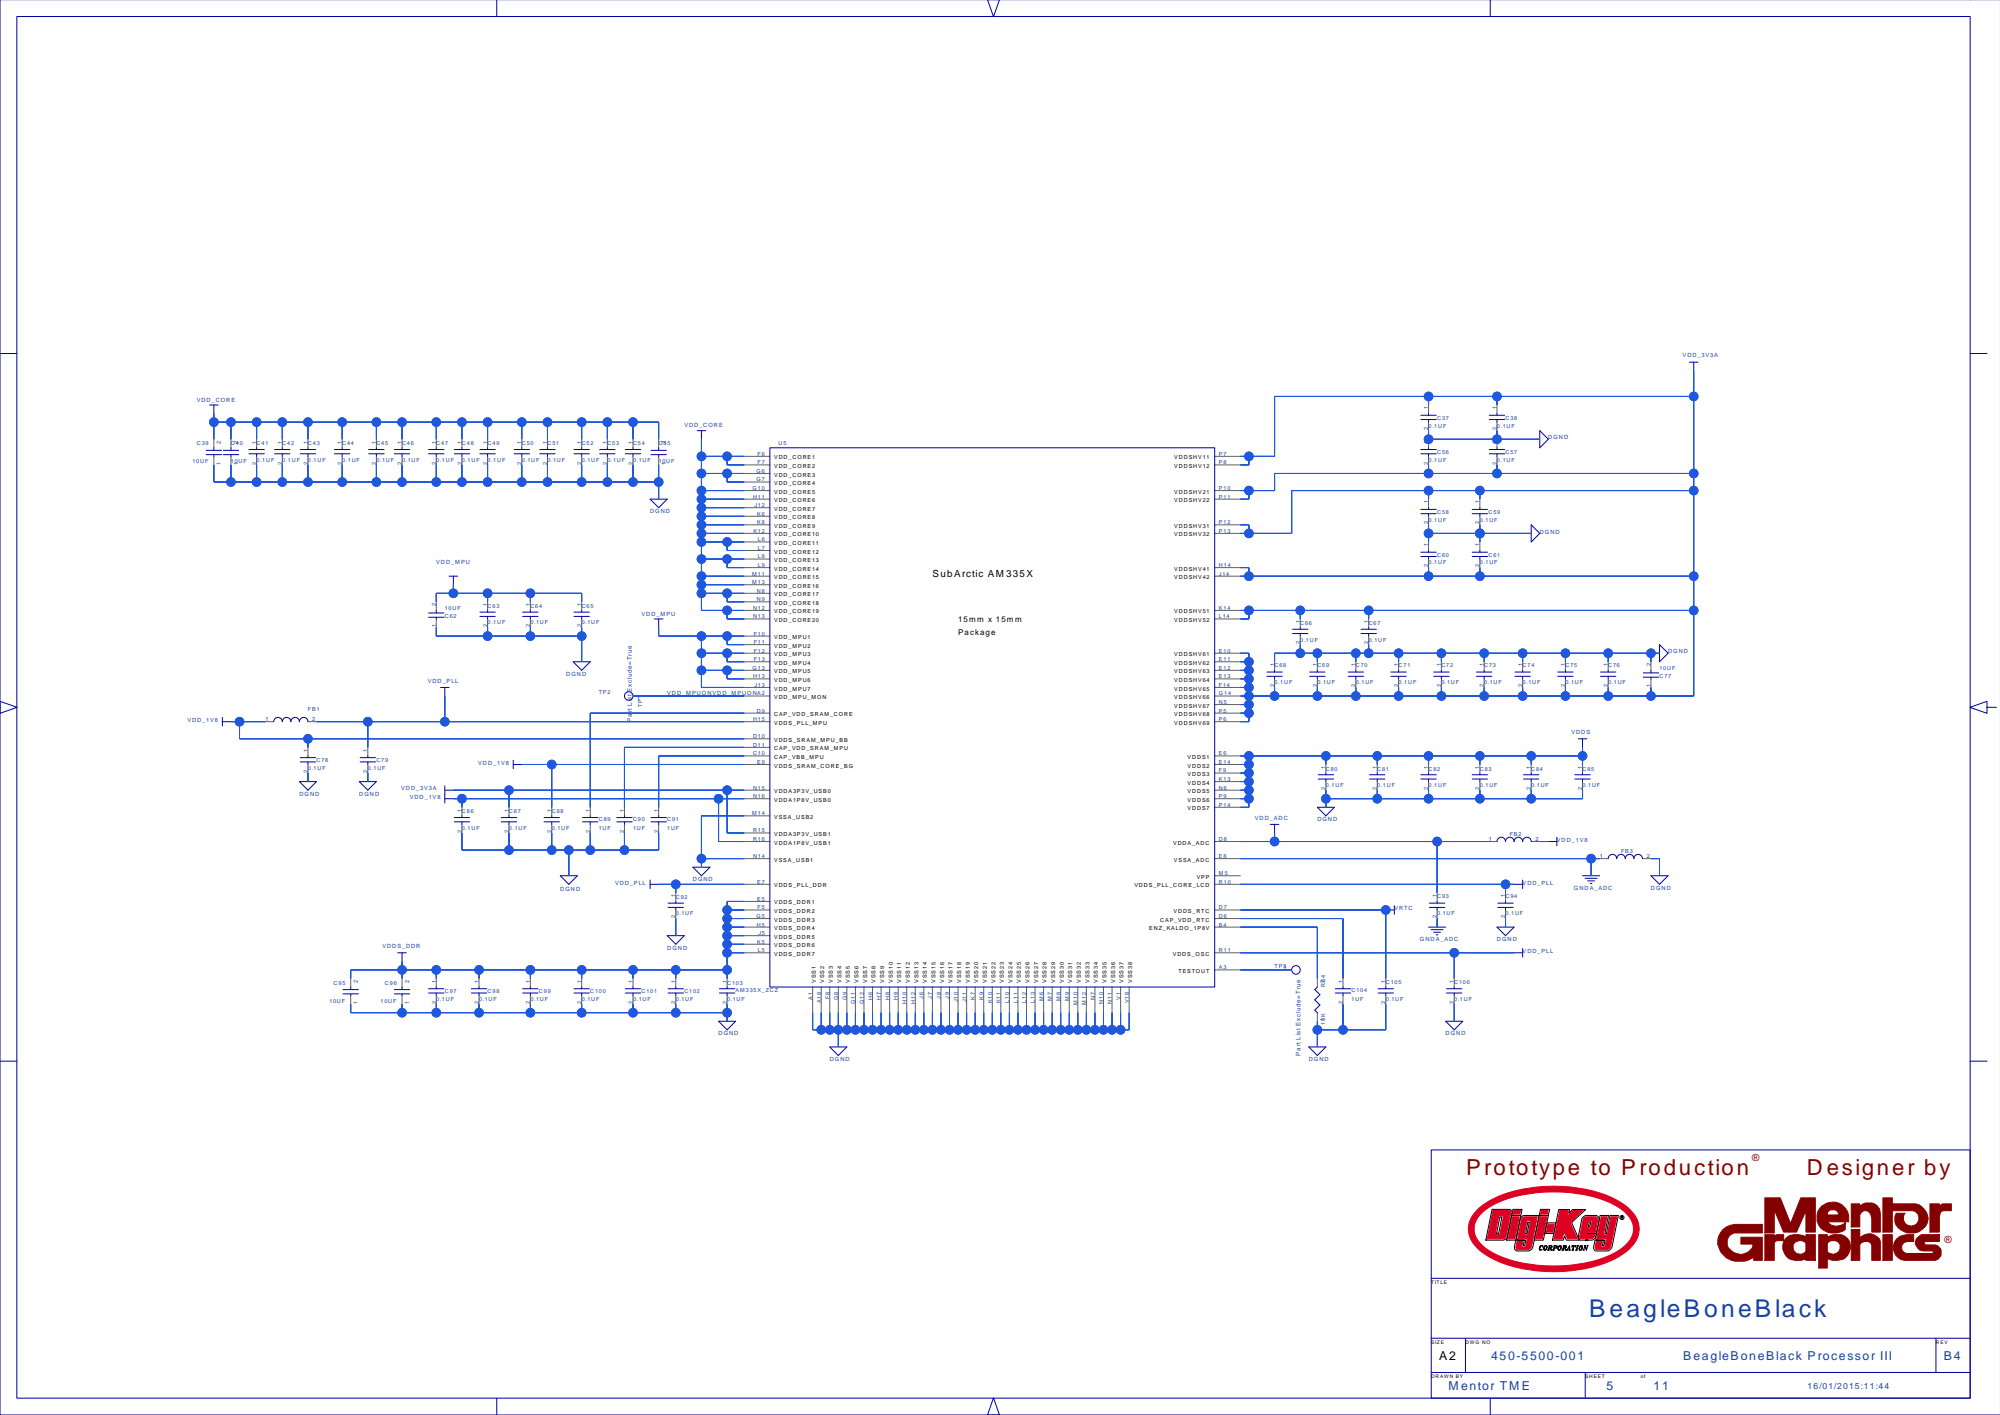
[picture p19: page 5]

Part List Exclude=True

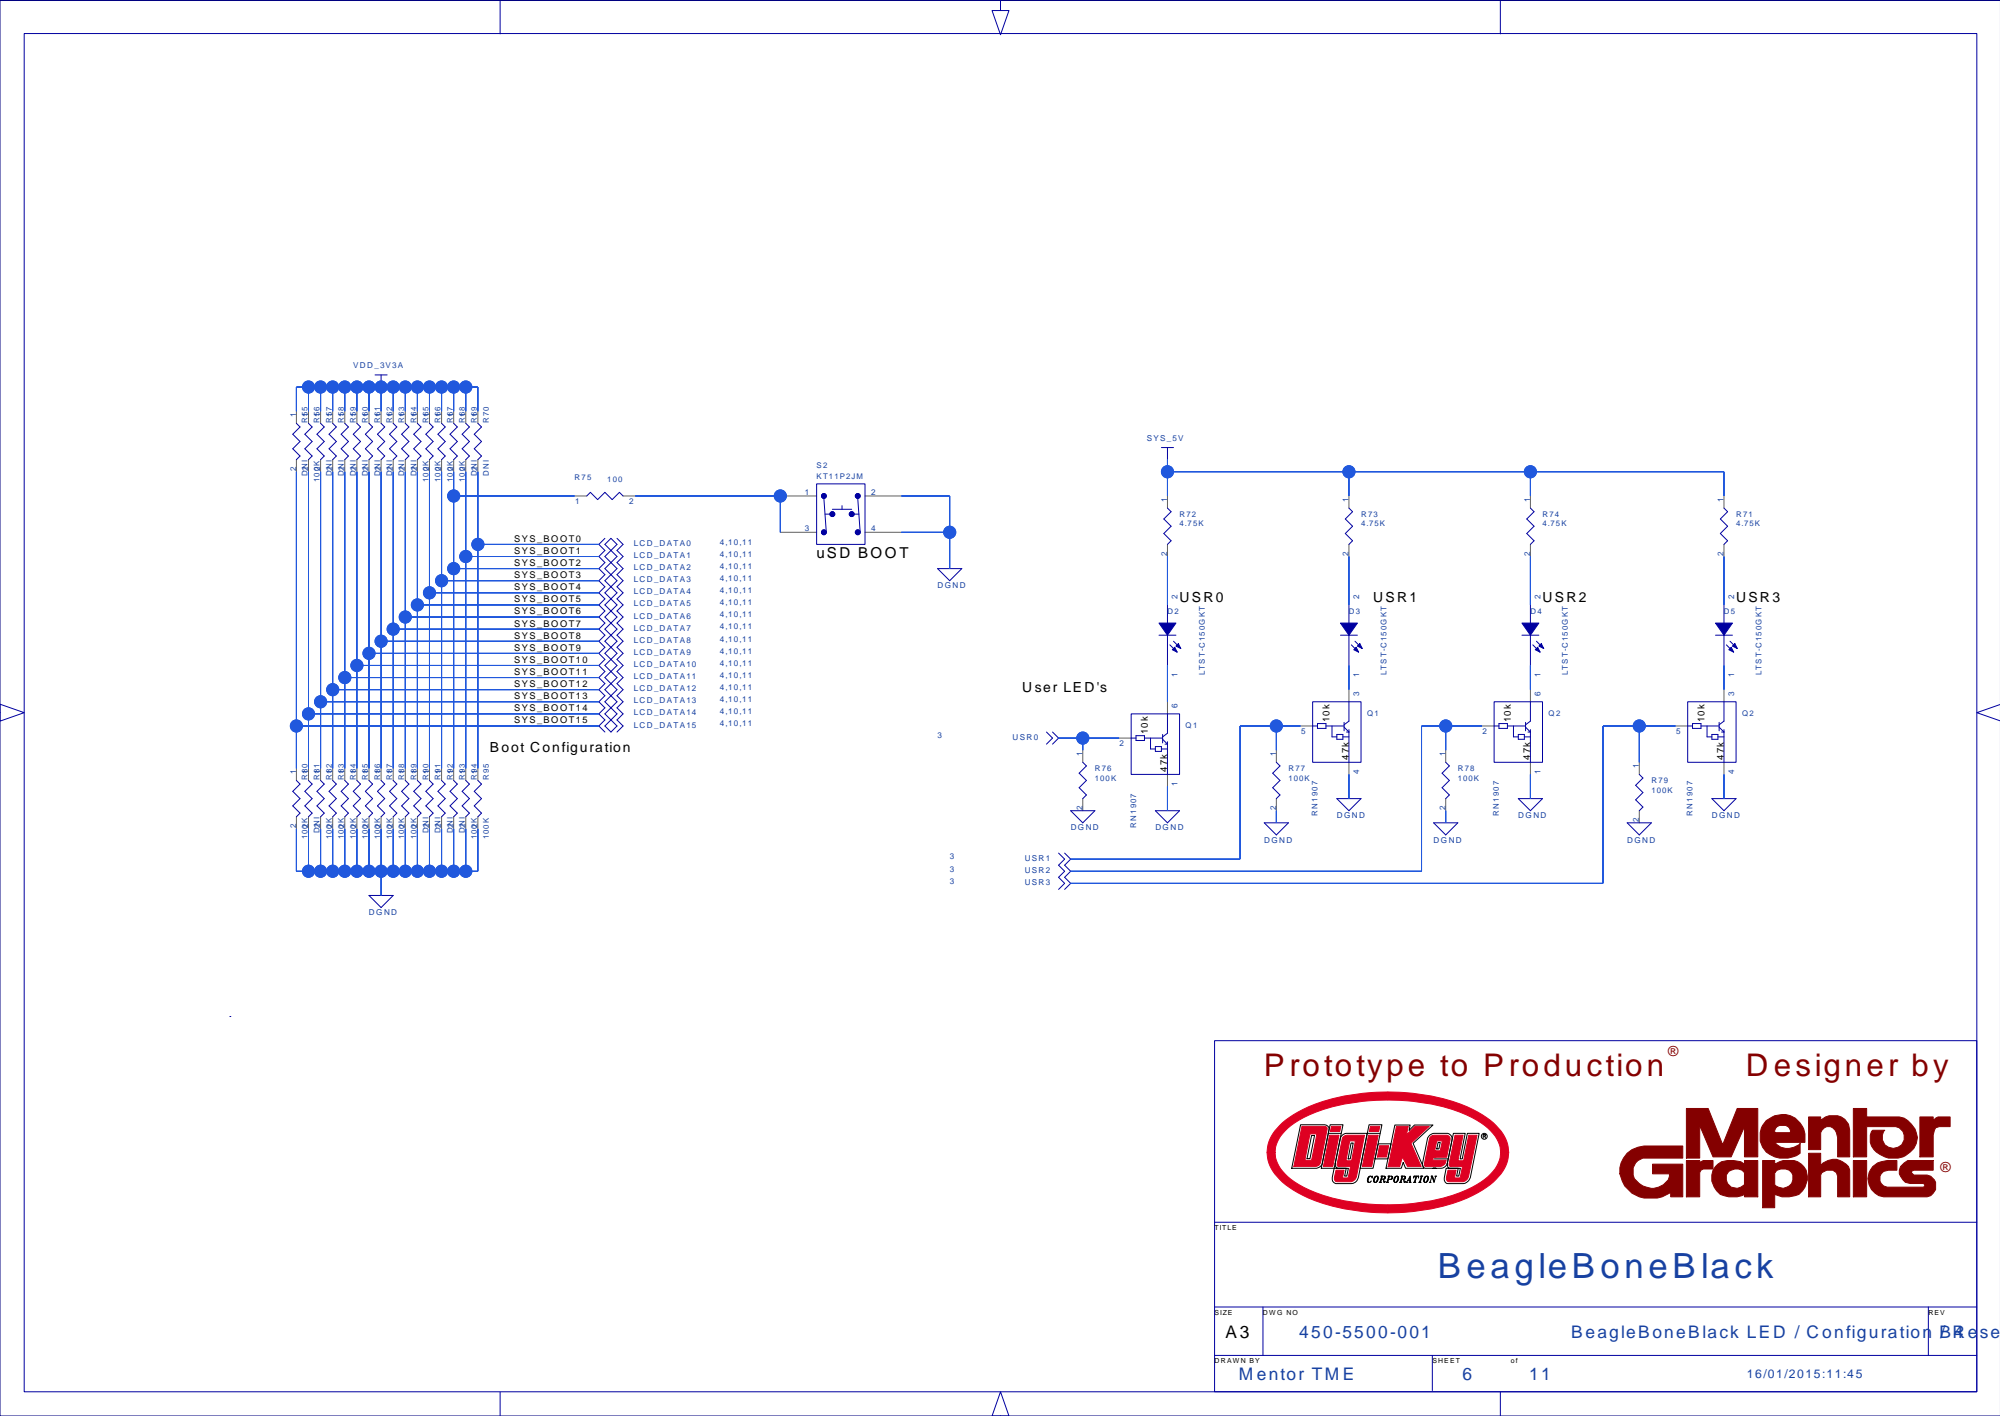
[picture p20: page 6]

# DDR3L SDRAM

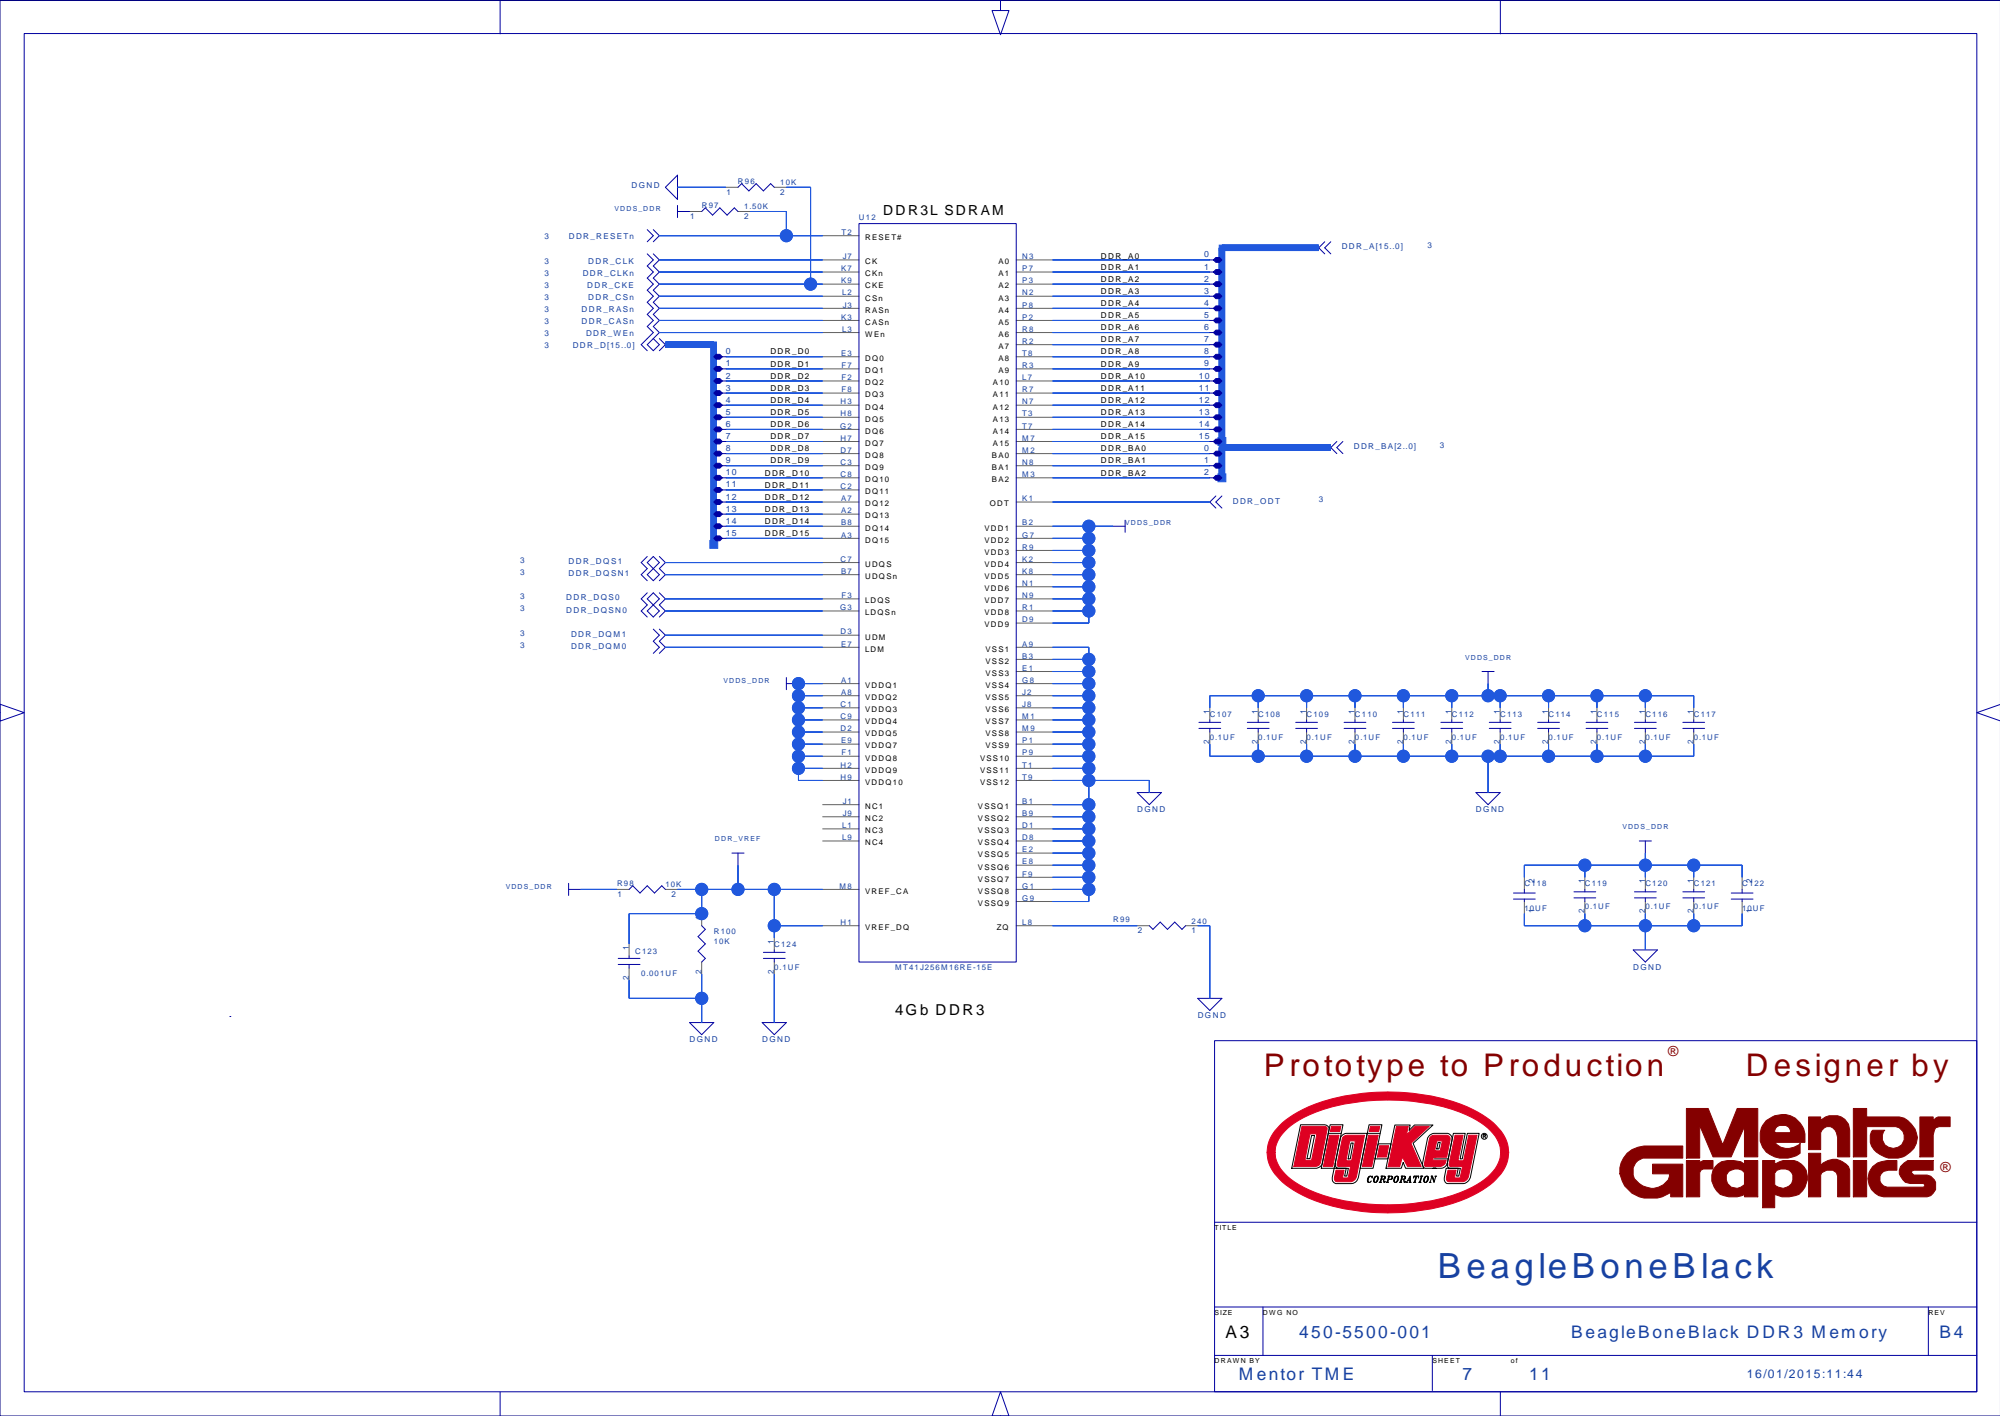
[picture p21: page 7]

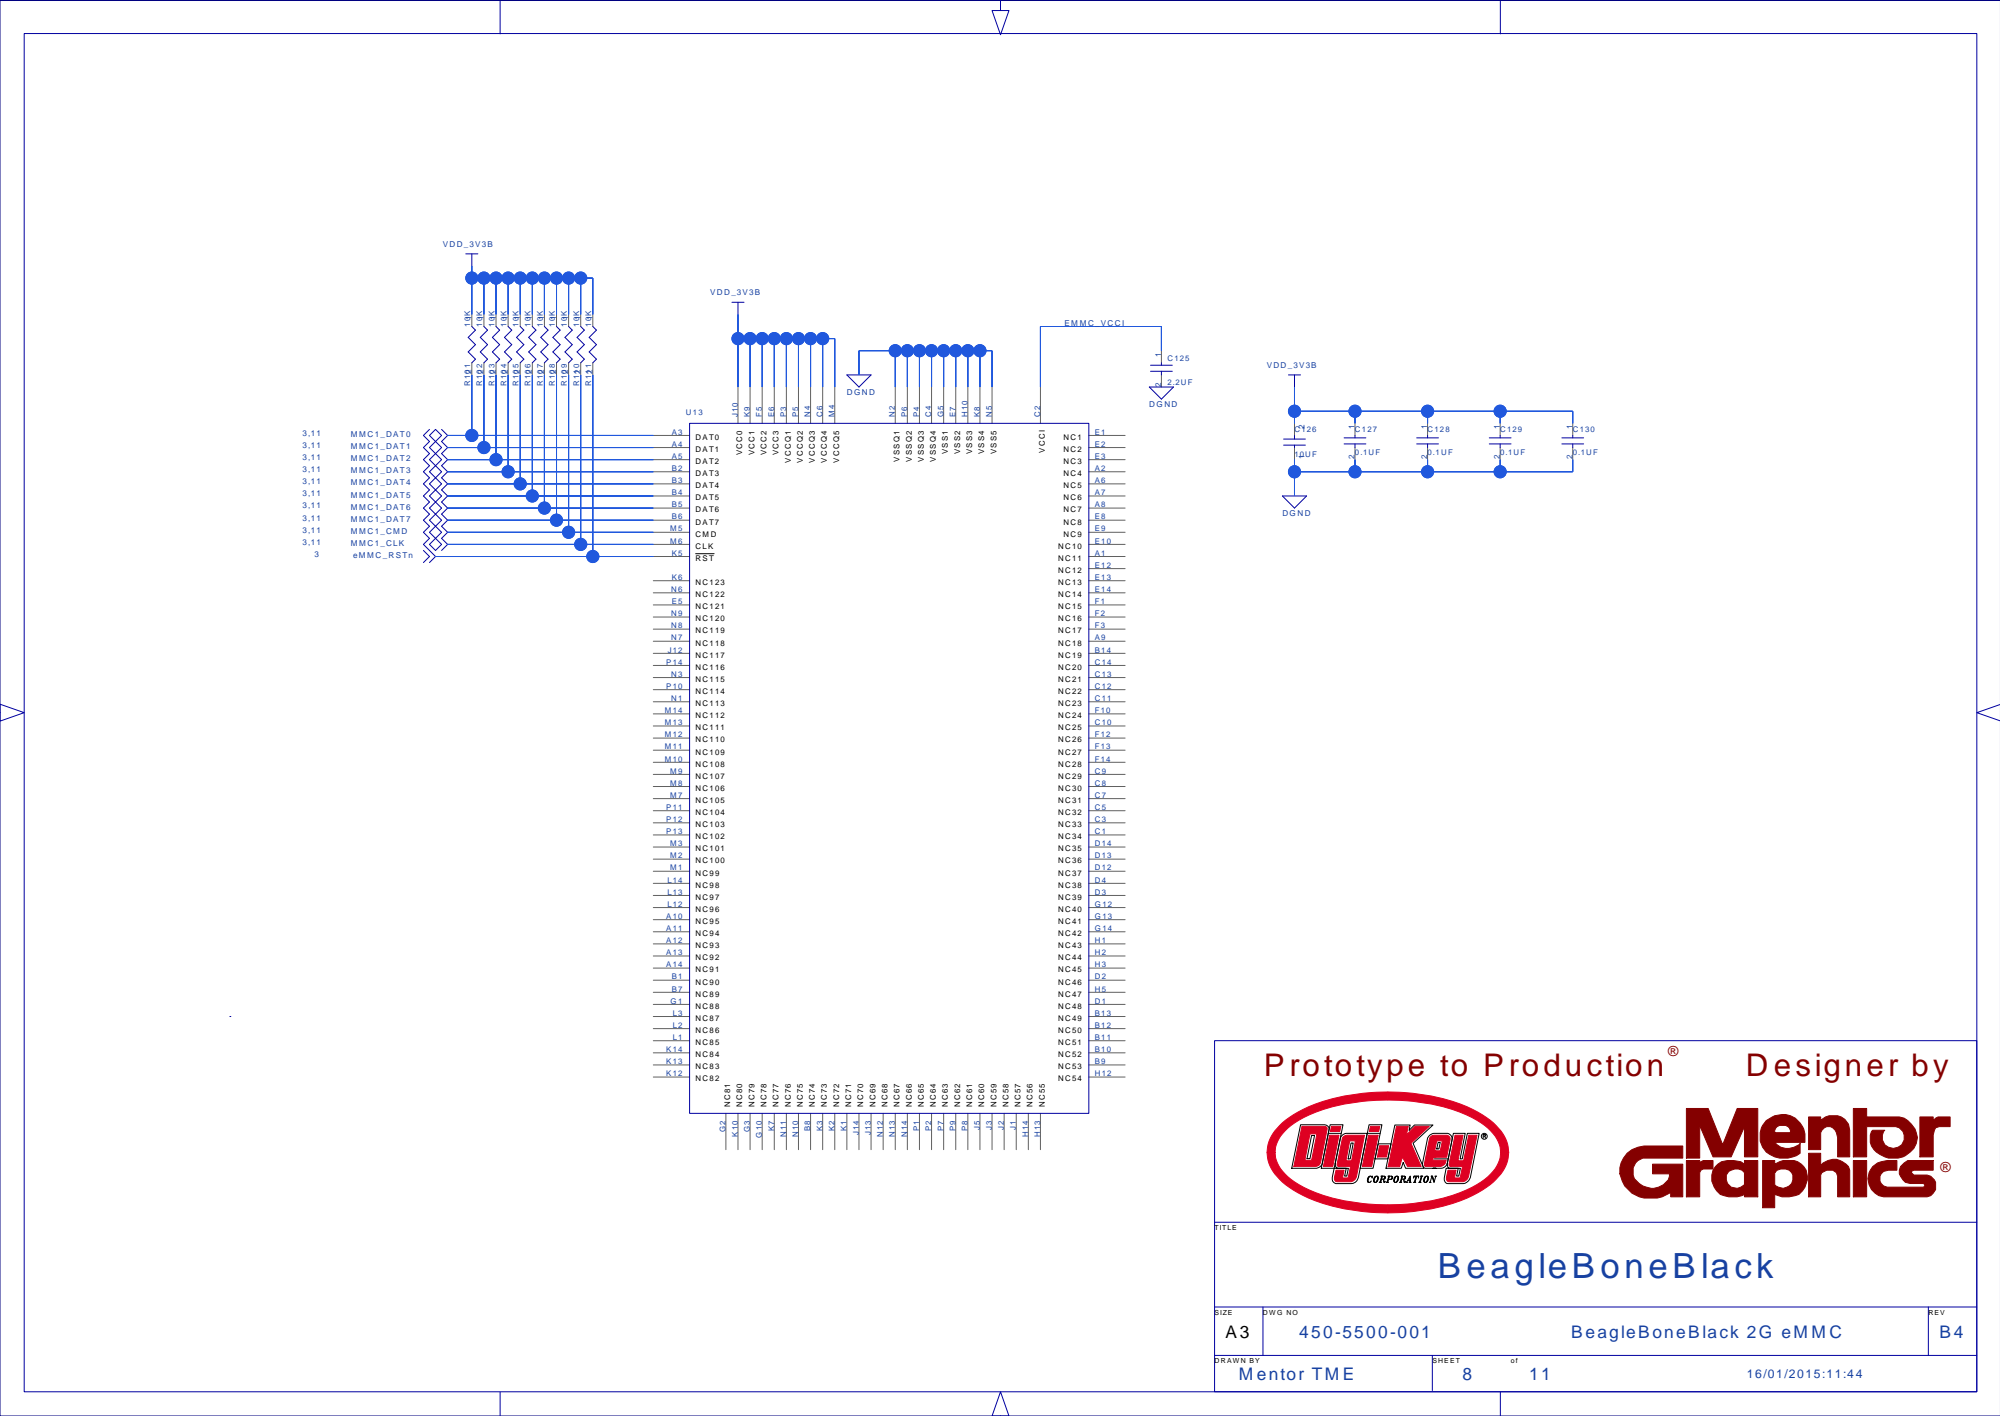
[picture p22: page 8]

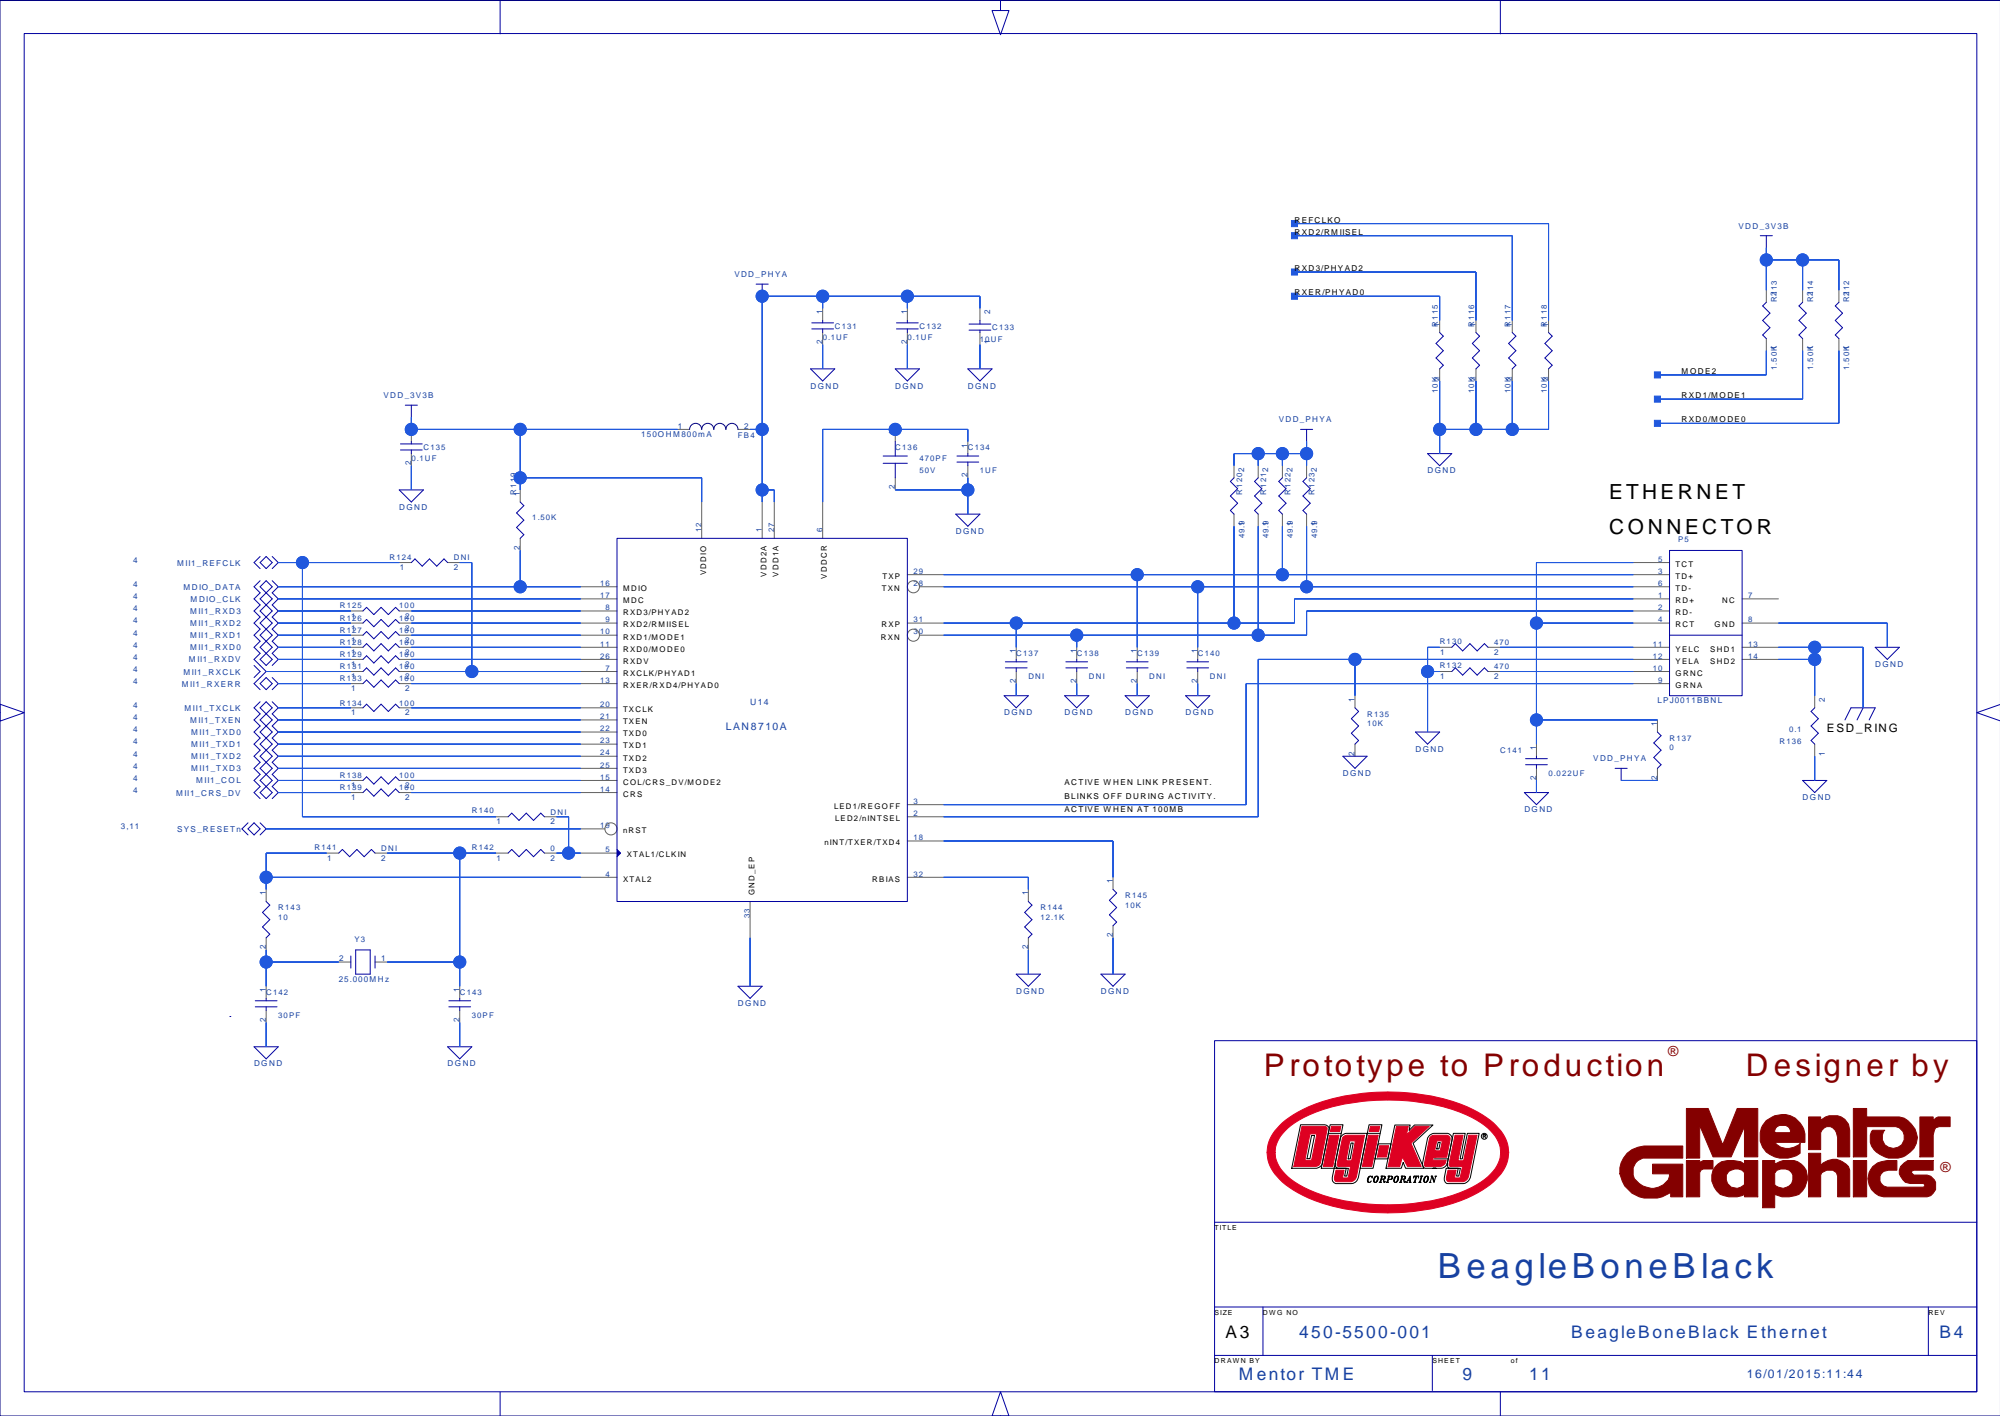
[picture p23: page 9]

ACTIVE WHEN LINK PRESENT.
BLINKS OFF DURING ACTIVITY.
ACTIVE WHEN AT 100MB

t

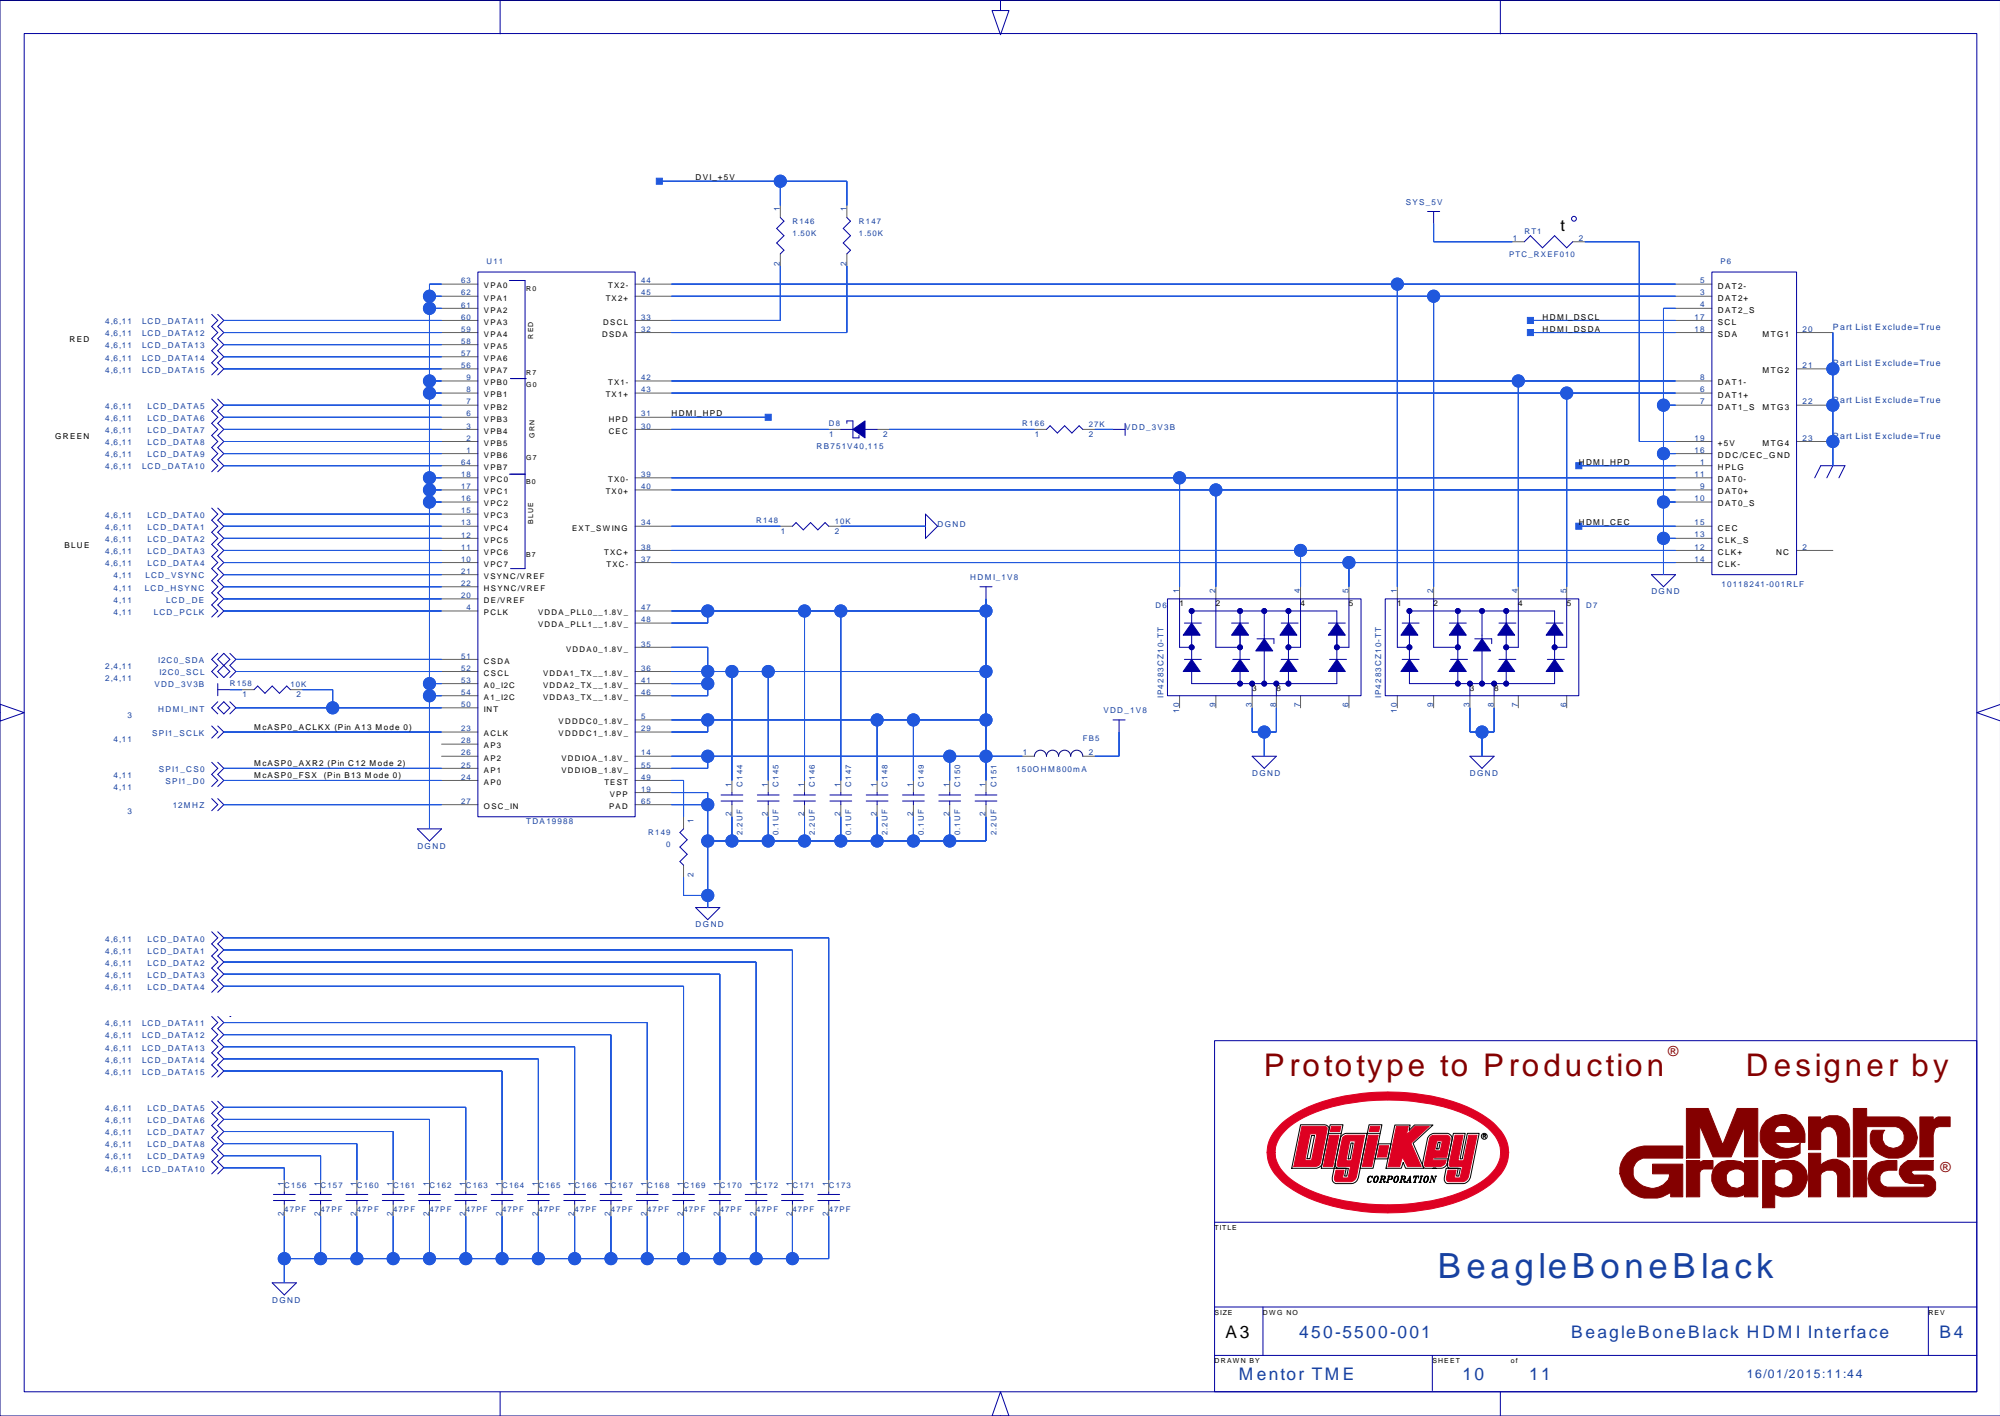
[picture p24: page 10]

Part List Exclude=True

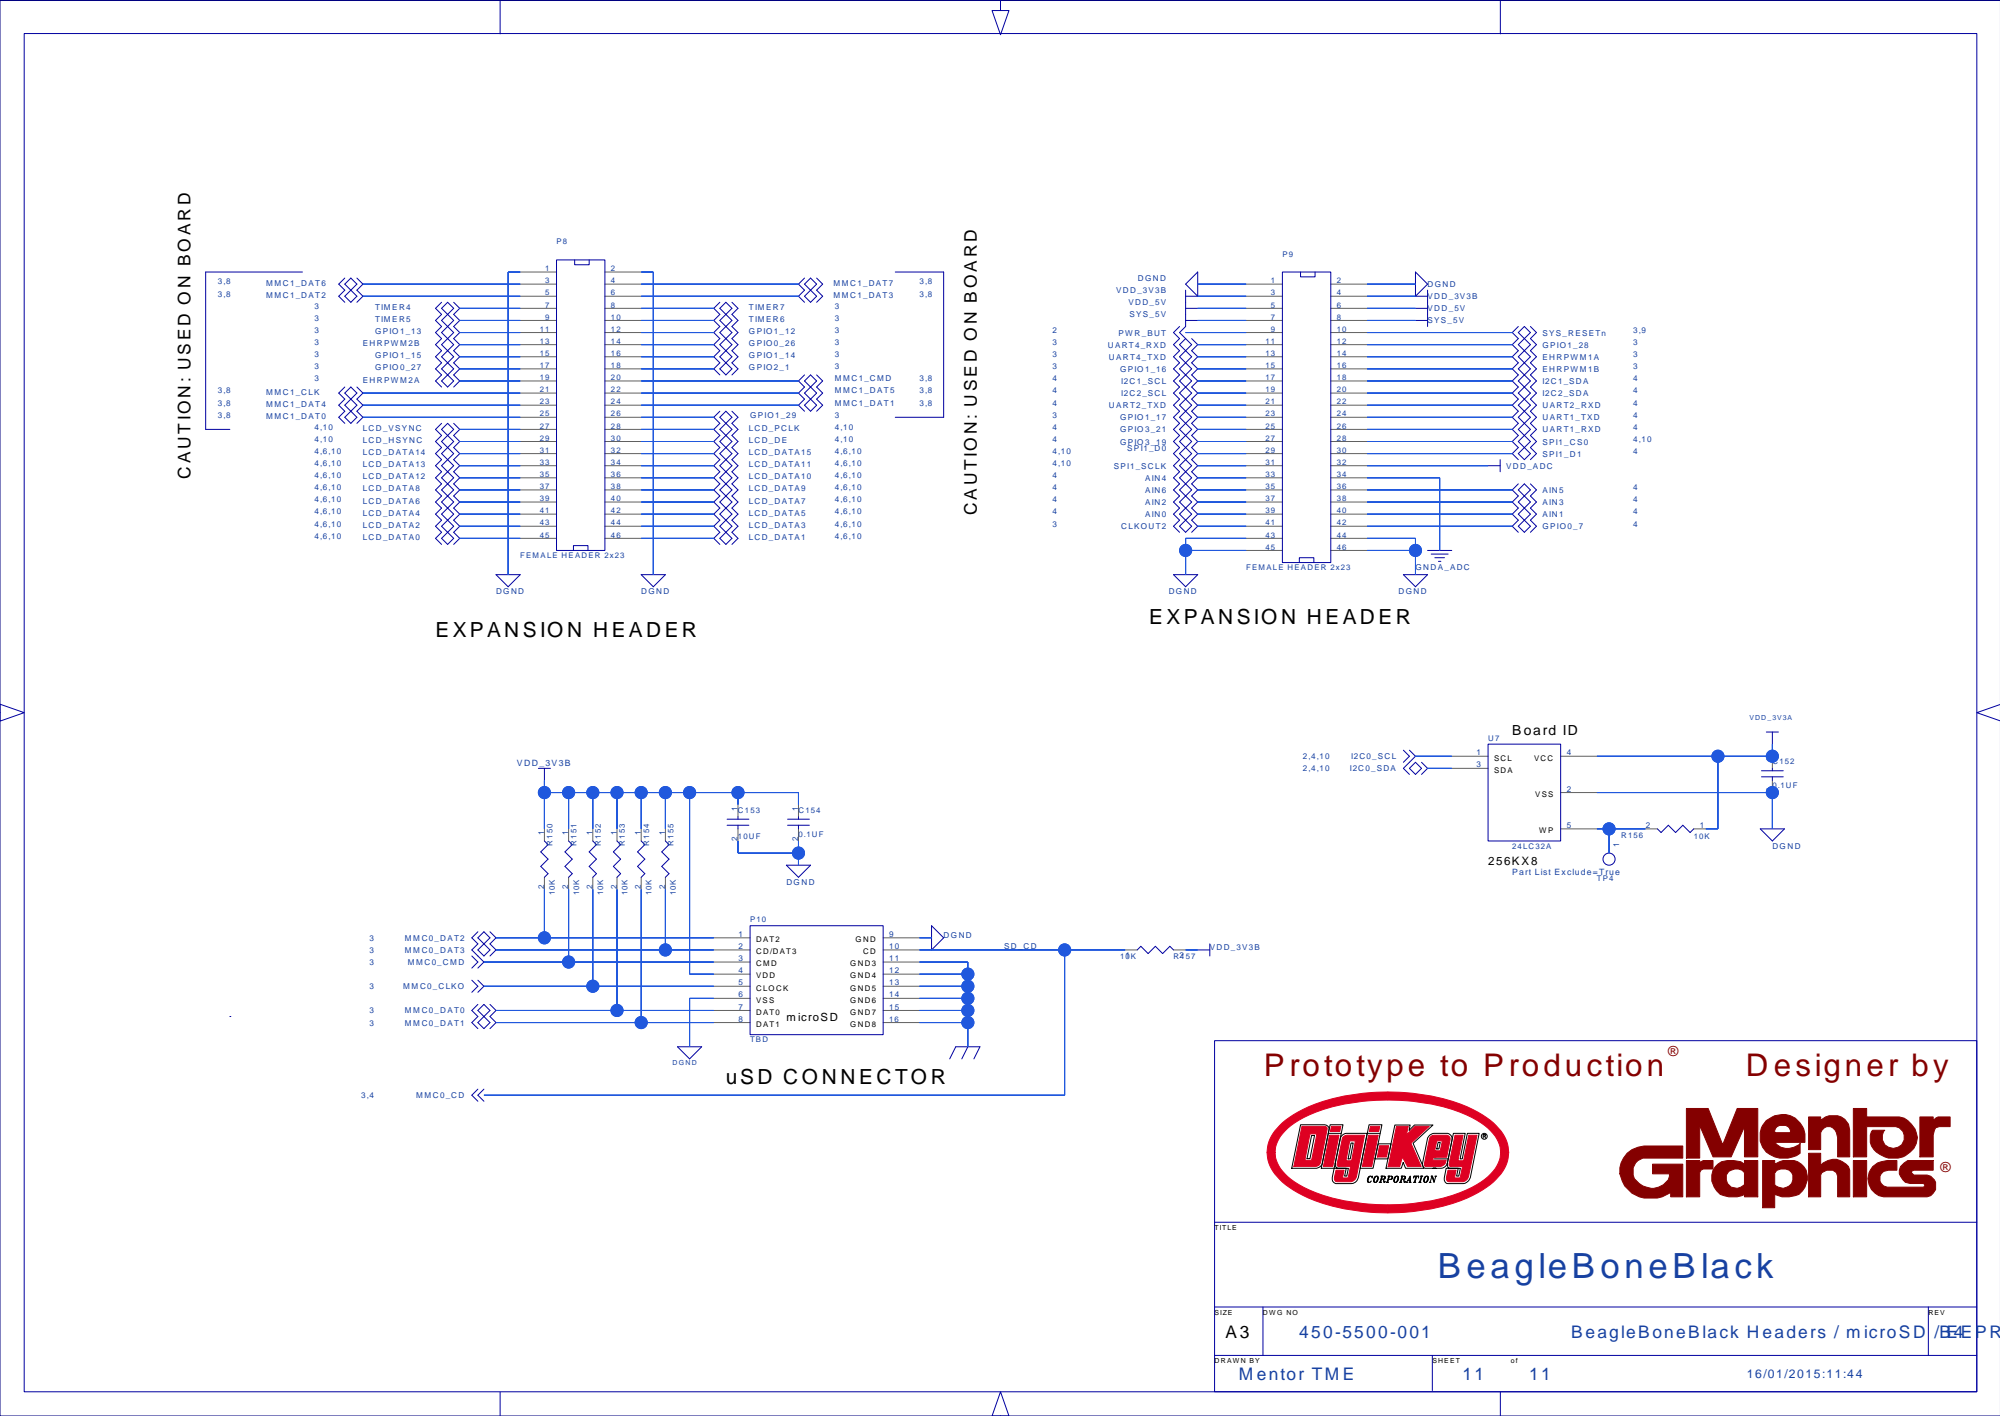
[picture p25: page 11]

CAUTION: USED ON BOARD
