TheGiraffe/BBB-Schematics-Resources/BBB_SCH.pdf

5

4

3

2

1

D | D
C | C
B | B
A | A

8

1

# eMMC FLASH

9

3

2

# HDMI FRAMER

# 10/100 ETHERNET

10

# DDR3 MEMORY

# PROCESSOR 2 OF 3, UAB PORTS

7

# LED, CONFIGURATION AND BUTTON

PAGE NO. | SCHEMATIC PAGE

# PROCESSOR 3 OF 3

# PROCESSOR 1 OF 3, JTAG HEADER

4

# POWER MANAGEMENT

5

# COVER PAGE

6

# This schematic is *NOT SUPPORTED* and DOES NOT constitute a reference design. Only “community” support is allowed

via resources at BeagleBoard.org/discuss.

# THERE IS NO WARRANTY FOR THIS DESIGN , TO THE EXTENT PERMITTED BY APPLICABLE LAW. EXCEPT WHEN OTHERWISE STATED IN WRITING THE COPYRIGHT HOLDERS AND/OR OTHER PARTIES

PROVIDE THE DESIGN “AS IS” WITHOUT WARRANTY OF ANY KIND,

# EITHER EXPRESSED OR IMPLIED, INCLUDING, BUT NOT LIMITED TO, THE IMPLIED WARRANTIES OF MERCHANTABILITY AND FITNESS FOR A PARTICULAR PURPOSE. THE ENTIRE RISK AS TO THE QUALITY AND PERFORMANCE OF THE DESIGN IS WITH YOU. SHOULD THE DESIGN PROVE DEFECTIVE, YOU ASSUME THE COST OF ALL

NECESSARY SERVICING, REPAIR OR CORRECTION.

11 | EXP CONN, uSD

# NOTE: PCB Revision for this board is Rev B6

REV | Description | DATE | BY
A4A | Initial production Release. | 11/19/2012 | GC
A5 | On the initial production release the processors were to be found incorrect as supplied by TI. Parts while marked AM3359 were actually AM3352. This revision uses the correct parts. | 1/2/2013 | GC
1. Deleted R29-R44 from the LCD lines.
2. Added 47pf capacitors C156-C173 to LCD data lines to ground.
3. Changed schematic revision to A5A.

A5A

4. Changed a few footprints after PCB update for above changes.
5. Added access point for the battery function of the TPS65217C. | 2/8/2013 | GC

# 7. Added power button to enable sleep, wakeup, power down and power up features on the

system.

# 6. Added Ferrite beads in series with LED power and 5V power rail of the USB host

connector. Required to pass FCC/CE testing due to noise emissions on that pin.

A5B 1. Added 100K pulldown on J1 pin 4 to prevent crosstalk when serial cable is not connected into PCB layout.

2. Changed the LED resistors to 4.75K to lower the brightness.

5/21/2013

# 8. Added Modification to add 100K ohm resistor to ground to prvent crosstalk when serial

cable is not plugged in.

GC

A5C
6/12/2013 GC
1. Changed R46, R47,R48 to 0 ohms.
2. Changed R45 to 22 Ohms.
Change was made due to production failures on some boards due to differences in impedances.

A6

# 1. Moved the enable for the VDD_3V3B regulator to VDD_3V3A rail. Change was made to

reduce the delay between the ramp up of the 3.3V rails.
7/25/2013 GC 2. Added a AND gate to the SYS_RESETn circuitry. There is a small chance that on power up the nRESETOUT signal on the processor may go high, causing the SYS_RESETn signal to go

HI before it should. This change reenforces the reset with the PORZn reset signal.
3. Added optional zero ohm resistor to tie GND_OSC0 to system ground.

A6A

12/13/2013 GC

1. Added optional zero ohm resistor to tie GND_OSC1 to system ground.
2. Changed C106 to a 1uF capacitor.
3. Changed C24 to a 2.2uF capacitor.
B | 1.Changed the processor to the AM3358BZCZ100. | 1/20/2014 | GC
4. Made R8 installed and R9 not installed.
C | 1.Increased the eMMC from 2GB to 4GB. | 3/21/2014 | GC

# Title

Size Size Size B B B | Document Number Document Number Document Number 450-5500-001 450-5500-001 450-5500-001 | Rev Rev Rev C C C
Date: Date: Date: Friday, March 21, 2014 Friday, March 21, 2014 Friday, March 21, 2014 | Sheet Sheet Sheet 1 1 1 of of of 11 11 11

# BeagleBone Black Cover Page

# Title

# BeagleBone Black Cover Page

# Title

# BeagleBone Black Cover Page

# Battery access pins. Pins are randomly placed to fit

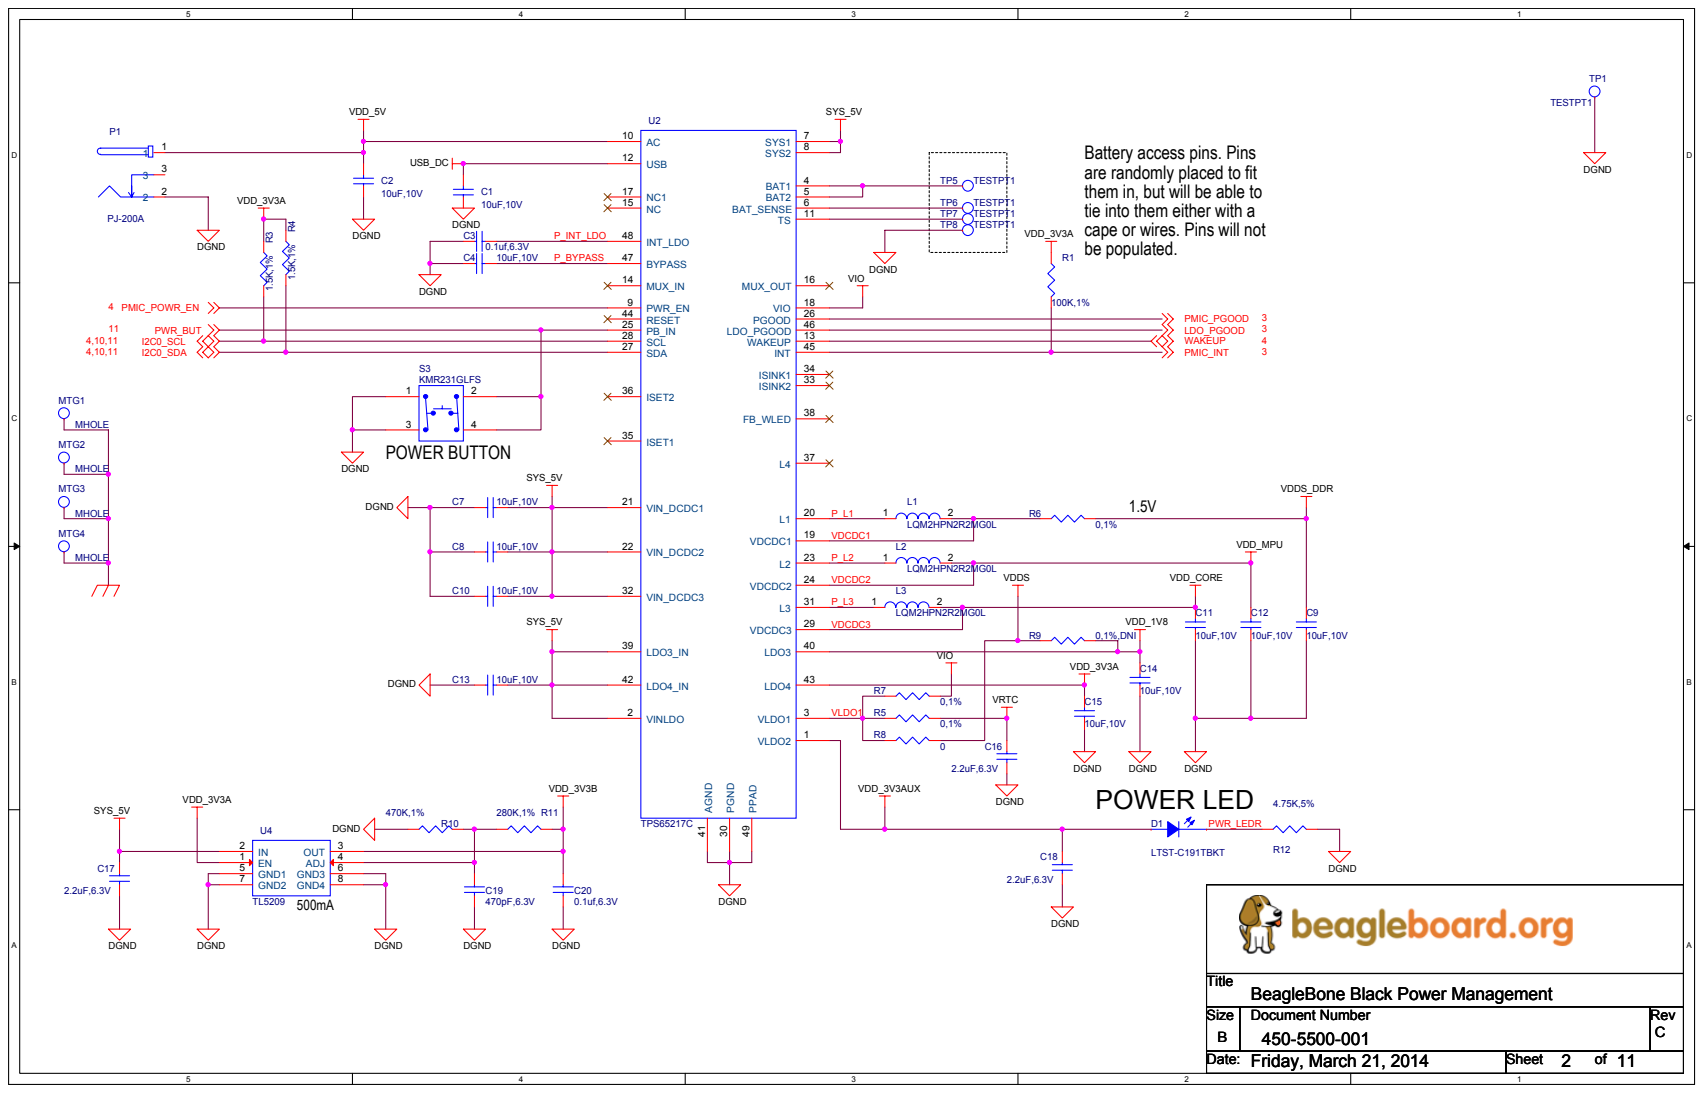
[picture p26: page 2]

them in, but will be able to
tie into them either with a
cape or wires. Pins will not
be populated.

Title
BeagleBone Black Power Management

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

Date: Date: Date: Friday, March 21, 2014 Friday, March 21, 2014 Friday, March 21, 2014 | Sheet Sheet Sheet 2 2 2 of of of 11 11 11

# RESET

3.3V

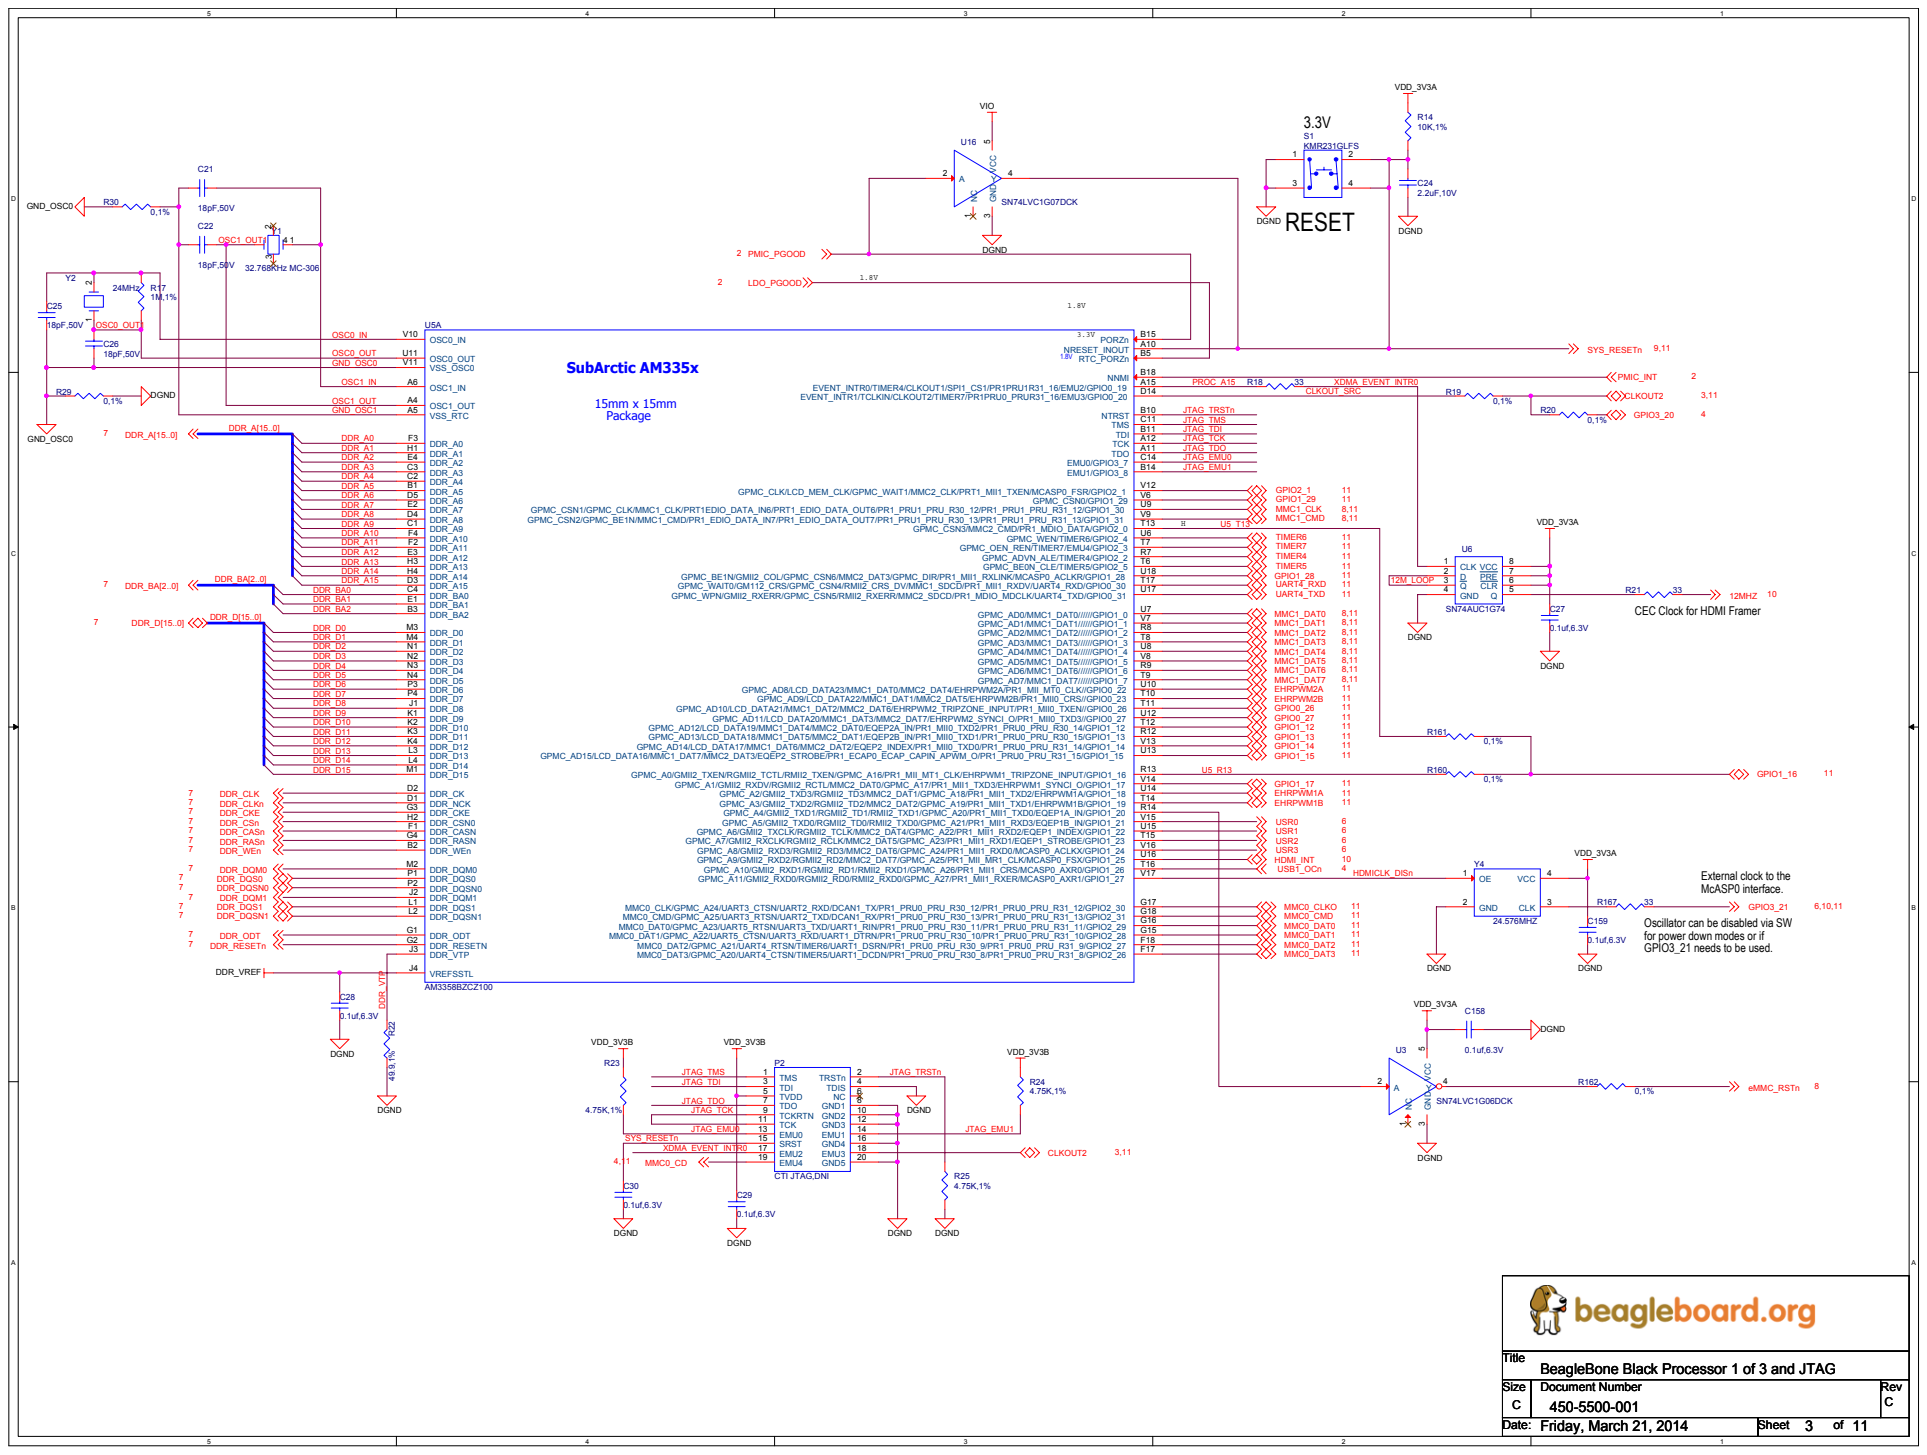
[picture p27: page 3]

CEC Clock for HDMI Framer

External clock to the
McASP0 interface.

Oscillator can be disabled via SW
for power down modes or if
GPIO3_21 needs to be used.

Title
BeagleBone Black Processor 1 of 3 and JTAG

Size Size Size C C C | Document Number Document Number Document Number 450-5500-001 450-5500-001 450-5500-001 | Rev Rev Rev C C C

Date: Date: Date: Friday, March 21, 2014 Friday, March 21, 2014 Friday, March 21, 2014 | Sheet Sheet Sheet 3 3 3 of of of 11 11 11

# SubArctic AM335X

## 15mm x 15mm

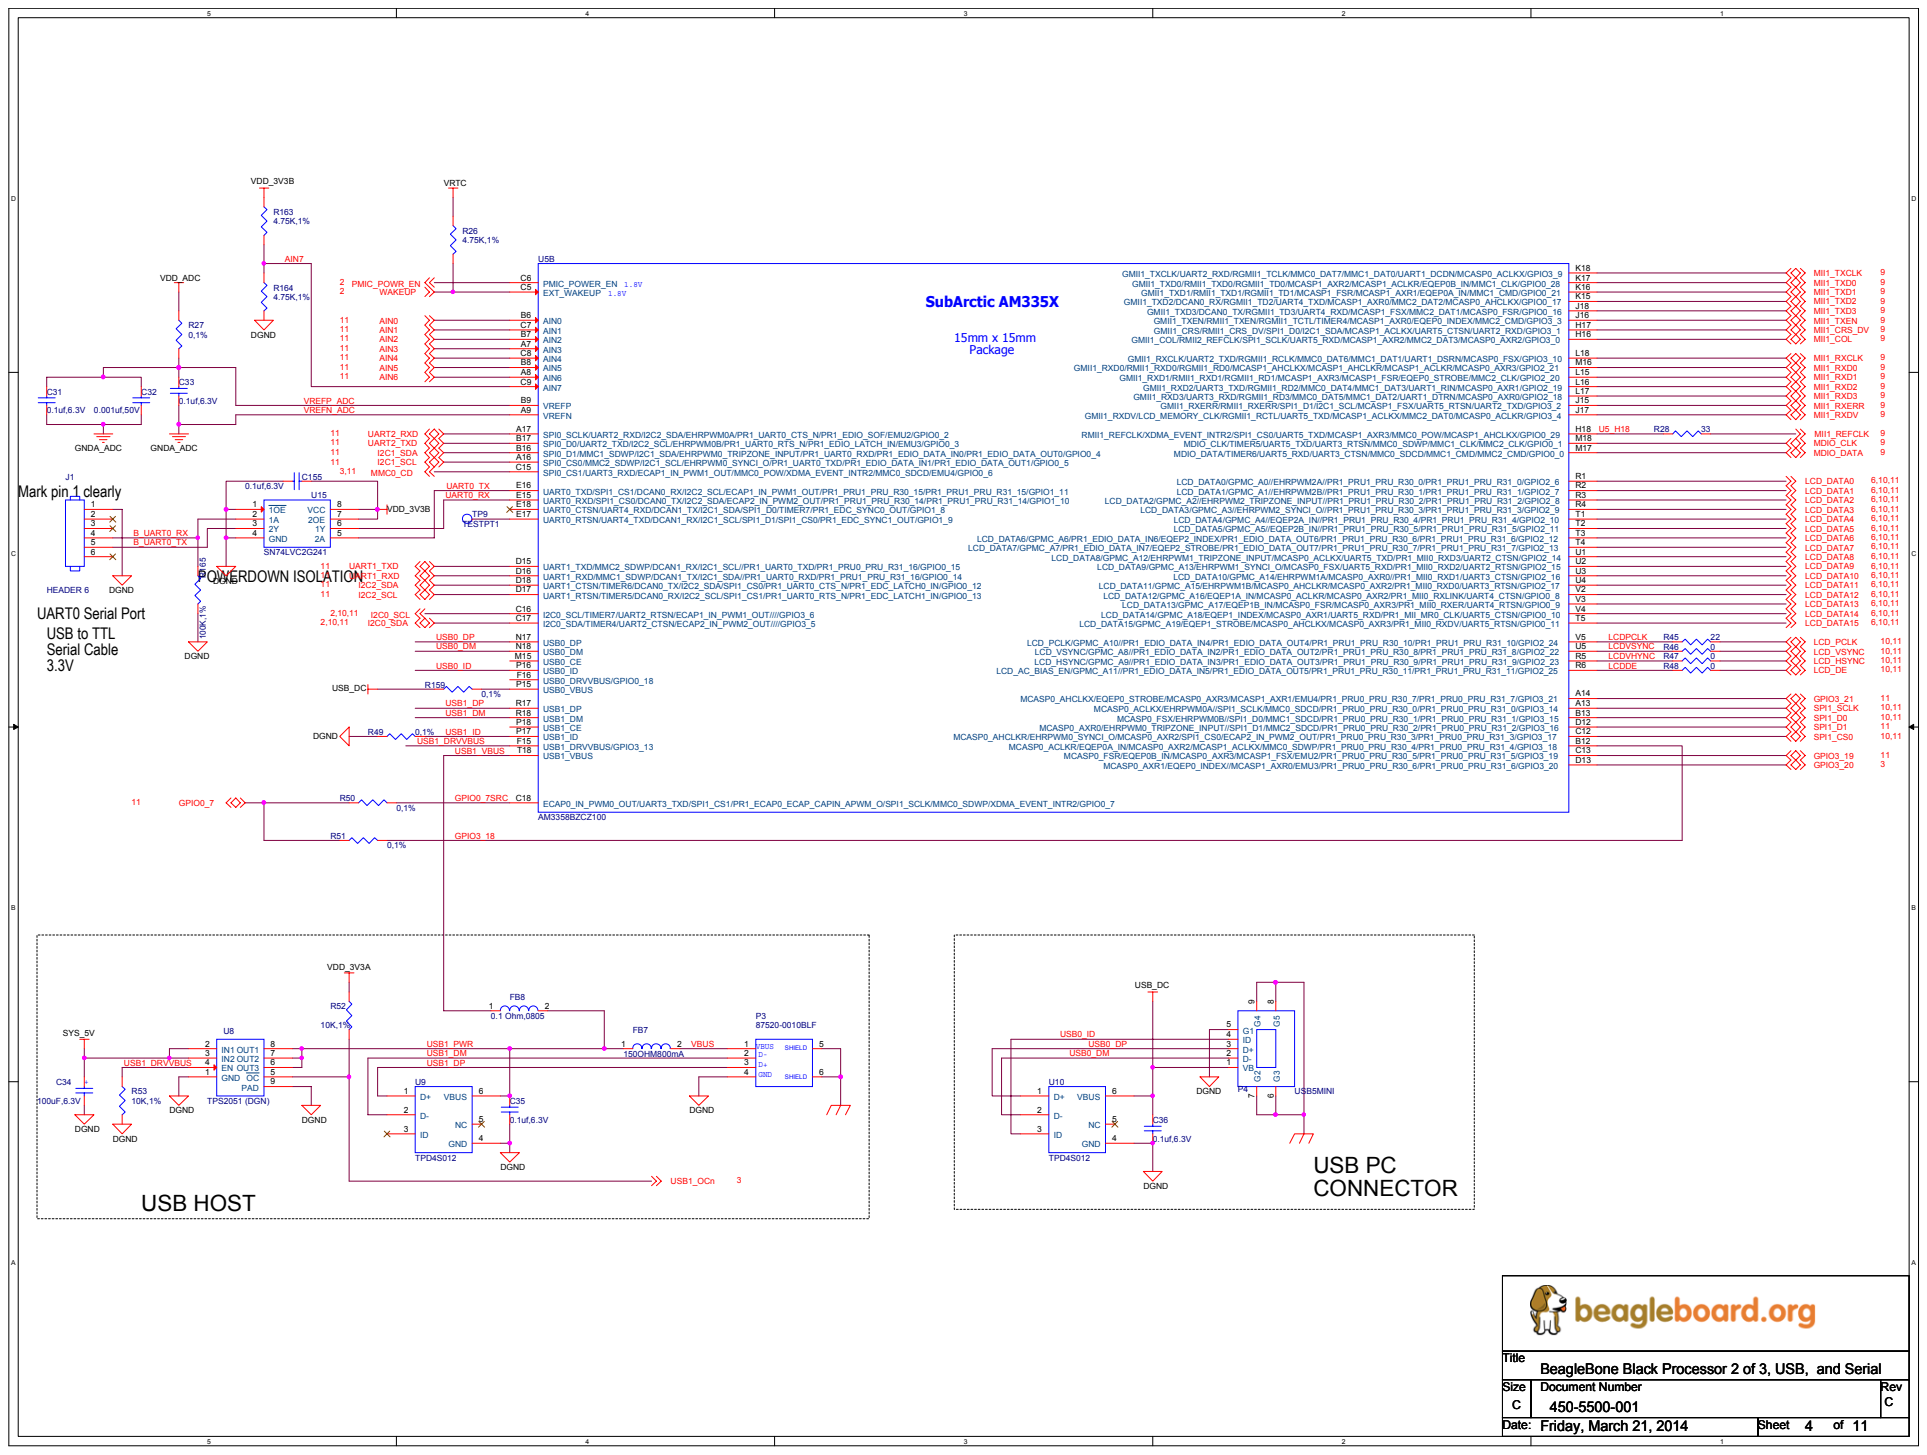
[picture p28: page 4]

Title
BeagleBone Black Processor 2 of 3, USB, and Serial

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

Date: Date: Date: Friday, March 21, 2014 Friday, March 21, 2014 Friday, March 21, 2014 | Sheet Sheet Sheet 4 4 4 of of of 11 11 11

# SubArctic AM335X

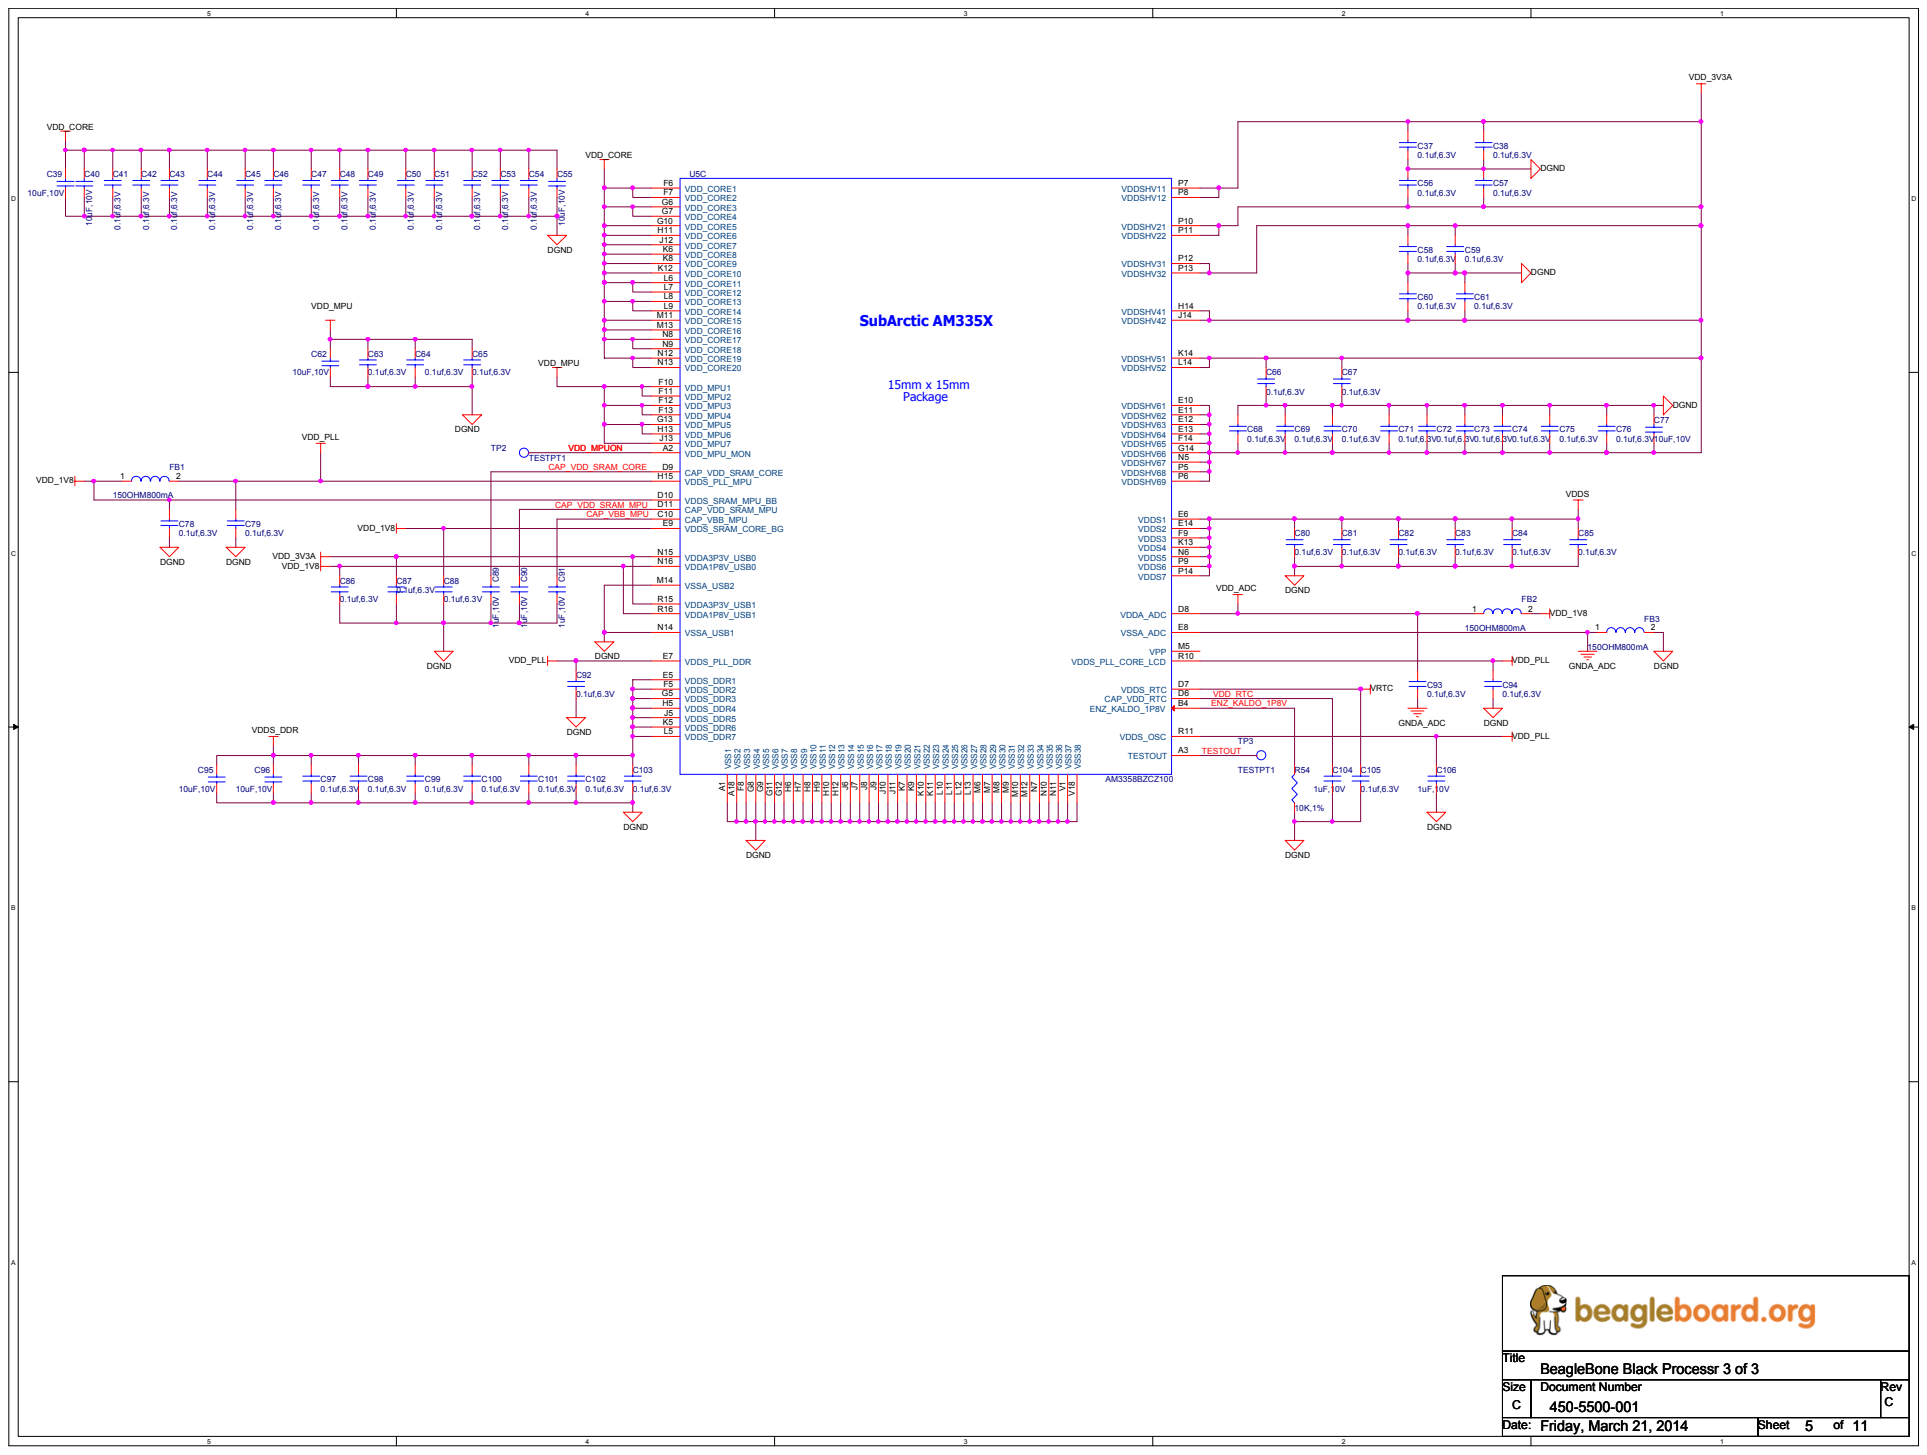
[picture p29: page 5]

Title
BeagleBone Black Processr 3 of 3

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

Date: Date: Date: Friday, March 21, 2014 Friday, March 21, 2014 Friday, March 21, 2014 | Sheet Sheet Sheet 5 5 5 of of of 11 11 11

## SYS_BOOT8 SYS_BOOT9 SYS_BOOT10 SYS_BOOT11 SYS_BOOT12 SYS_BOOT13 SYS_BOOT14 SYS_BOOT15

## SYS_BOOT4

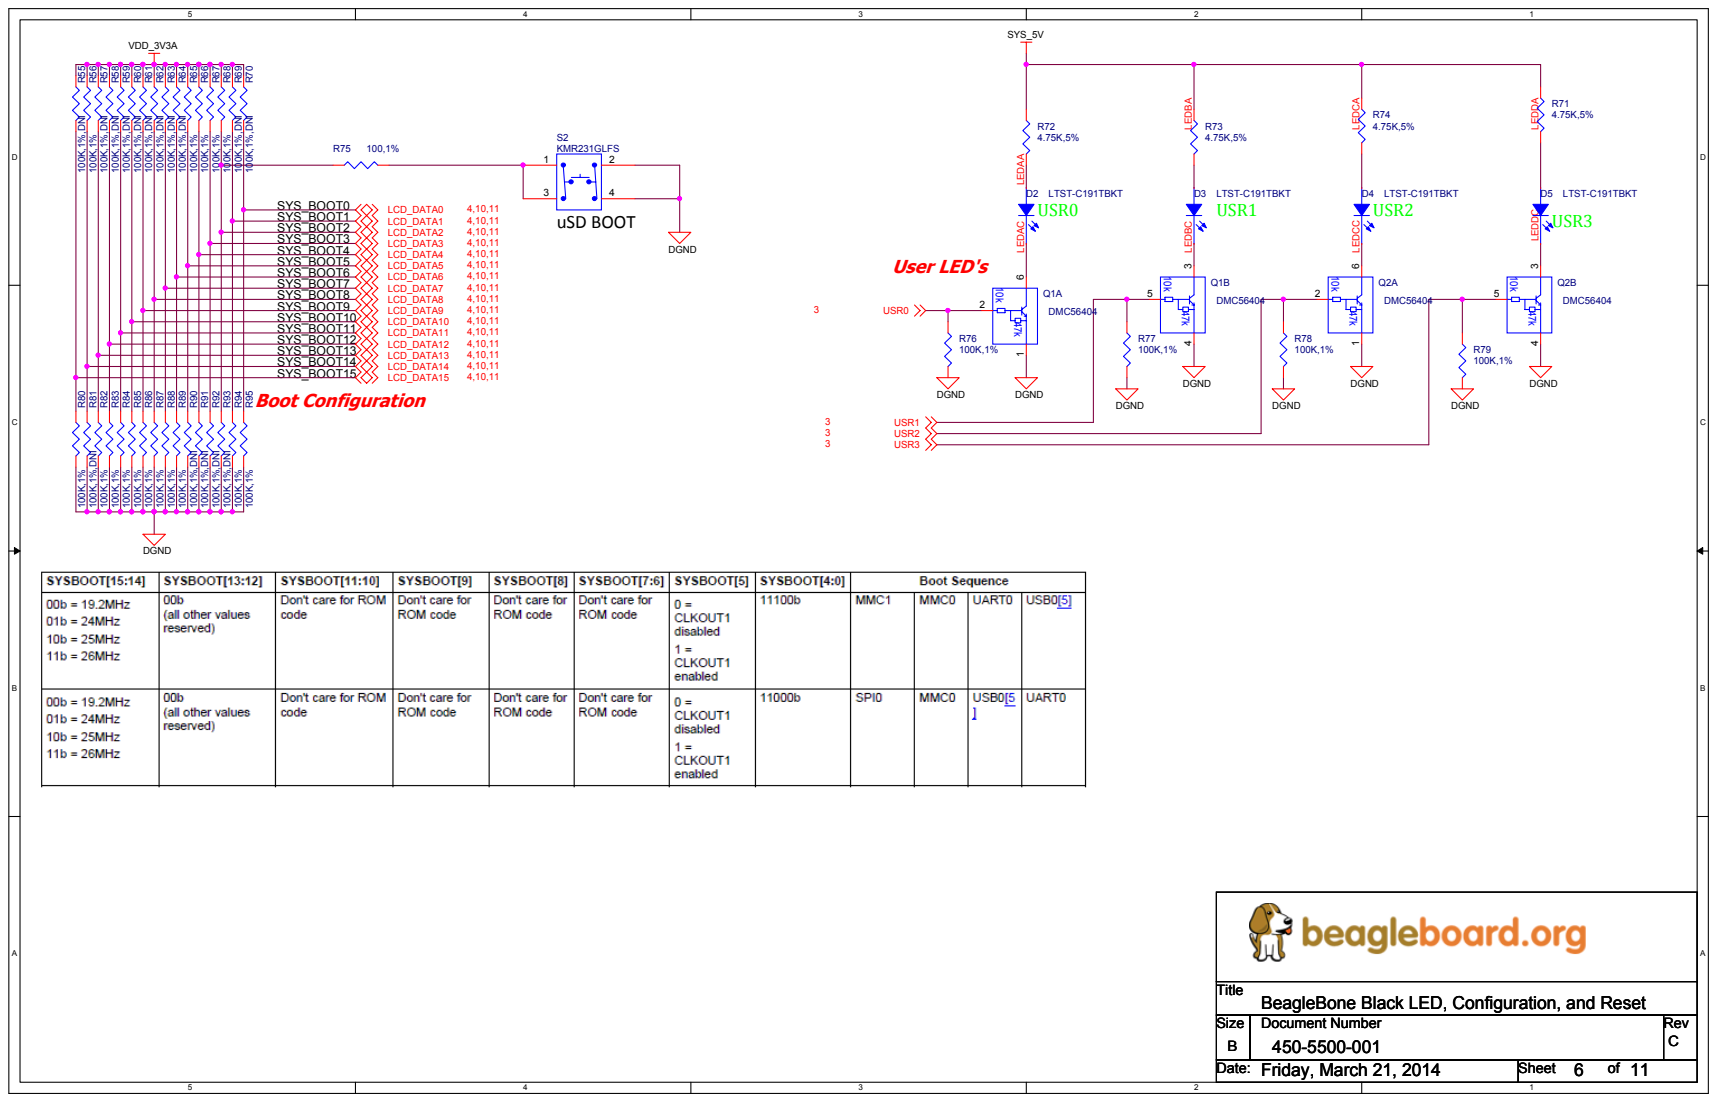
[picture p30: page 6]

Title
BeagleBone Black LED, Configuration, and Reset

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

Date: Date: Date: Friday, March 21, 2014 Friday, March 21, 2014 Friday, March 21, 2014 | Sheet Sheet Sheet 6 6 6 of of of 11 11 11

# DDR3L SDRAM

### DDR_D11

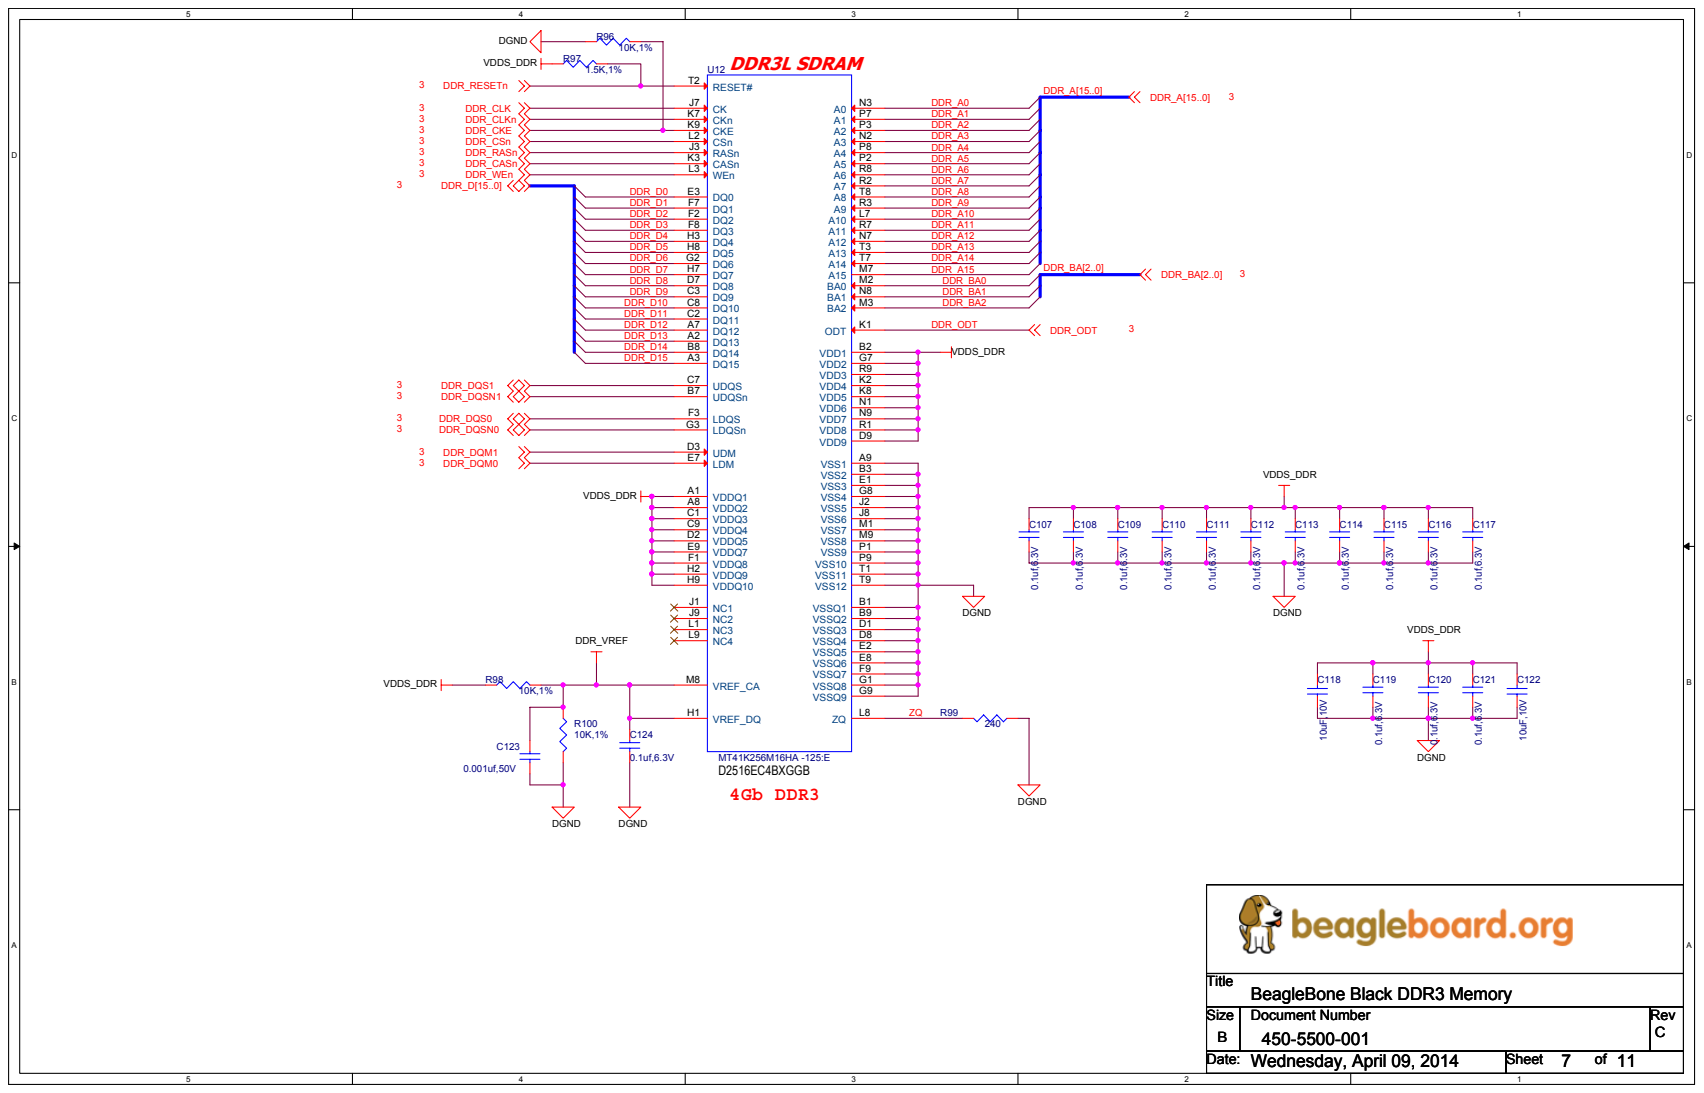
[picture p31: page 7]
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

Date: Date: Date: Wednesday, April 09, 2014 Wednesday, April 09, 2014 Wednesday, April 09, 2014 | Sheet Sheet Sheet 7 7 7 of of of 11 11 11

### eMMC_VCCI

### DGND

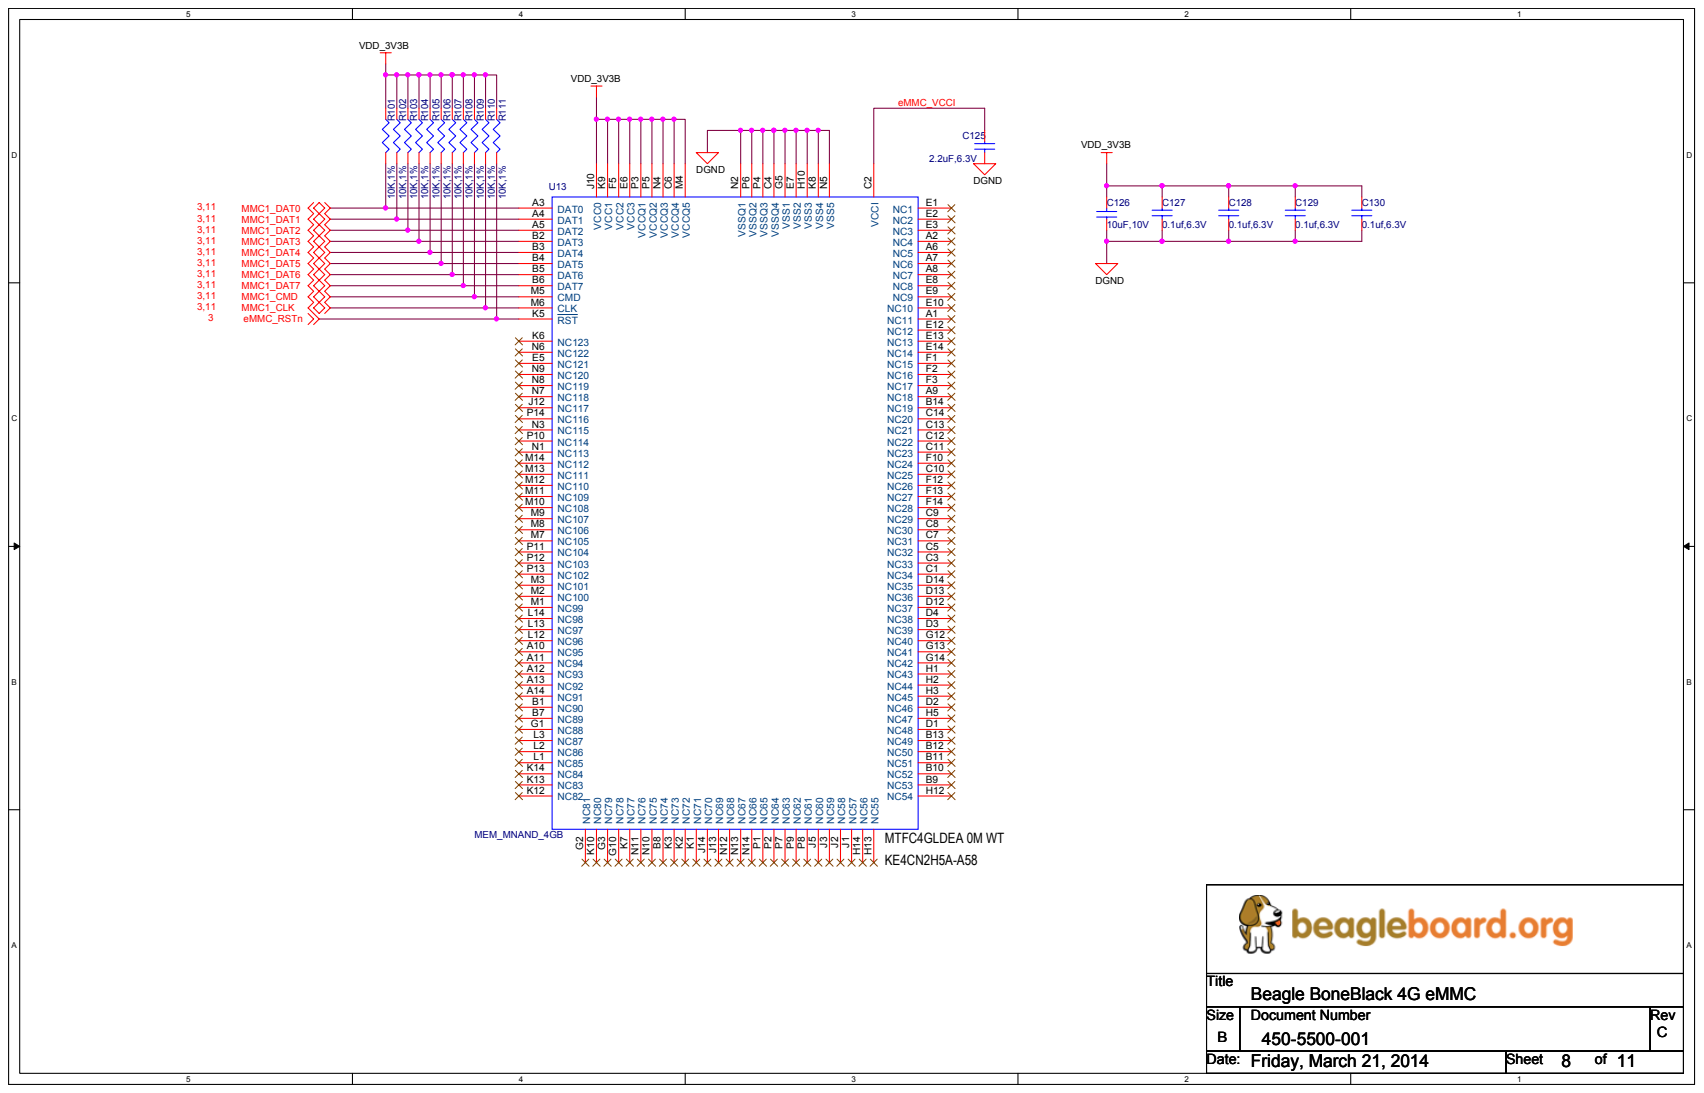
[picture p32: page 8]
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

Date: Date: Date: Friday, March 21, 2014 Friday, March 21, 2014 Friday, March 21, 2014 | Sheet Sheet Sheet 8 8 8 of of of 11 11 11

# ETHERNET

### PHY_VDDCR

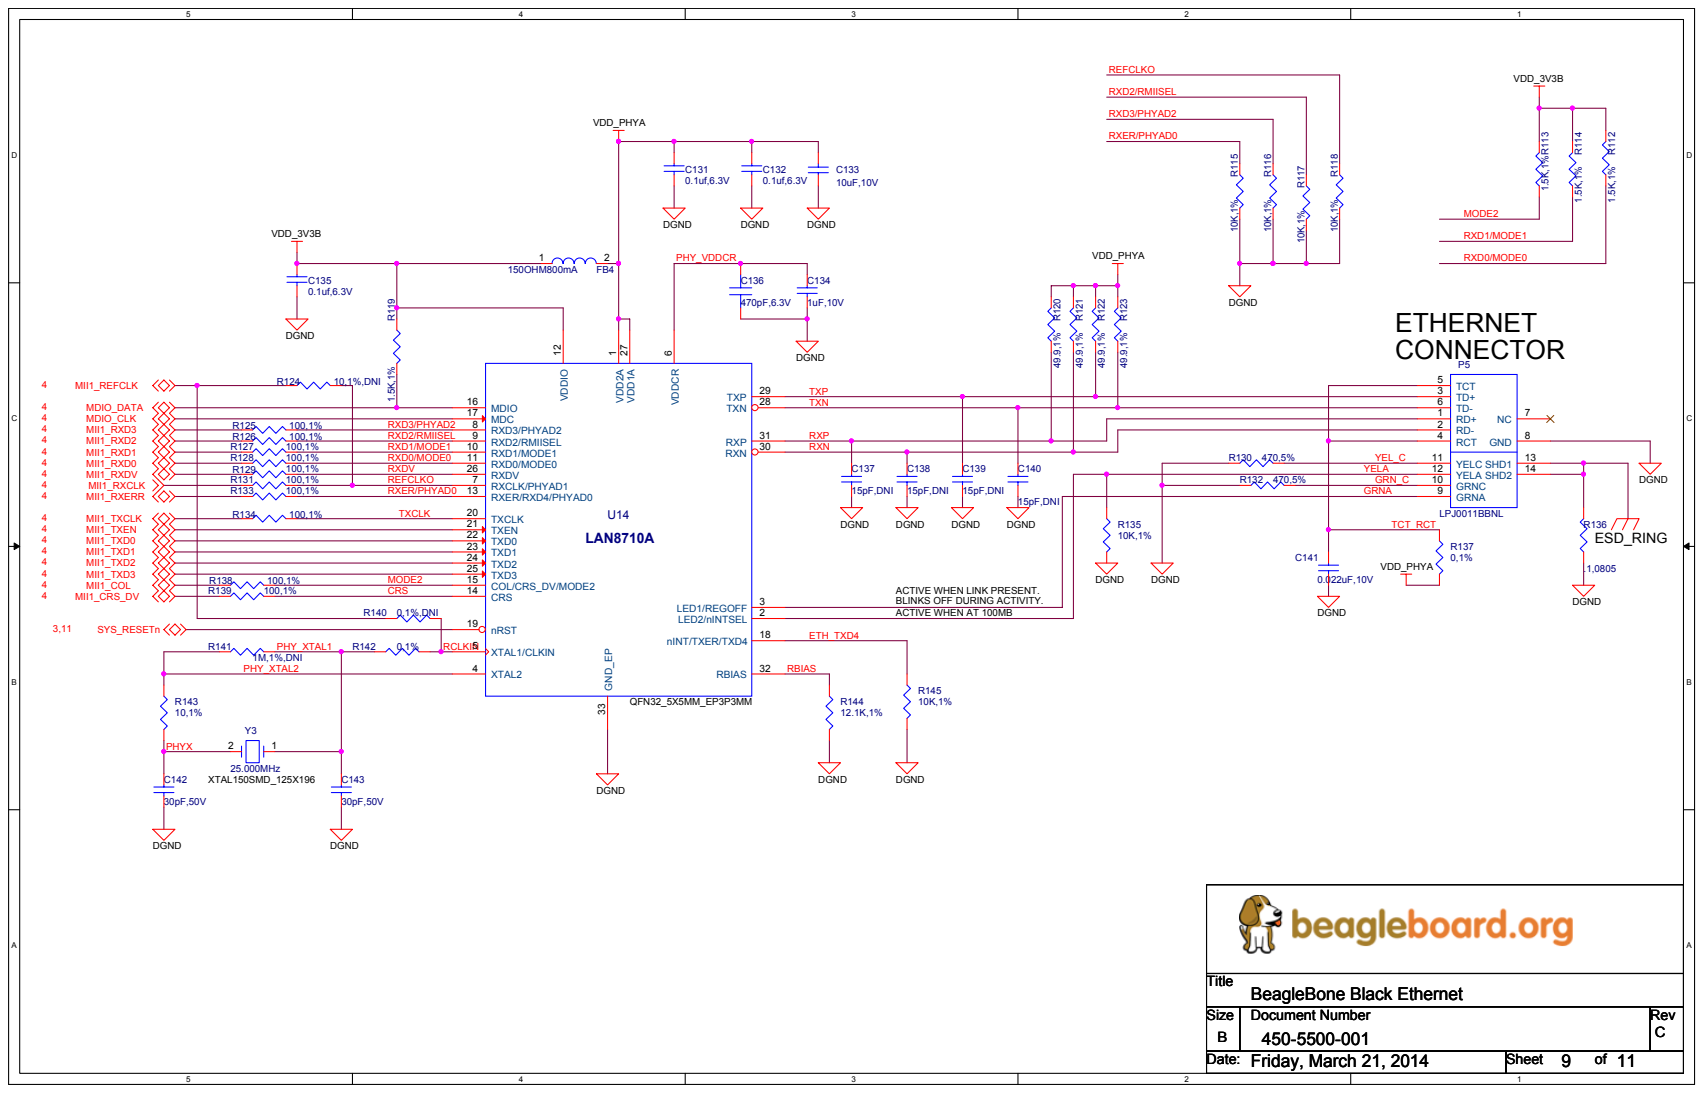
[picture p33: page 9]

ACTIVE WHEN LINK PRESENT.
BLINKS OFF DURING ACTIVITY.
ACTIVE WHEN AT 100MB

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

Date: Date: Date: Friday, March 21, 2014 Friday, March 21, 2014 Friday, March 21, 2014 | Sheet Sheet Sheet 9 9 9 of of of 11 11 11

### HDMI_HPD HDMI_CEC

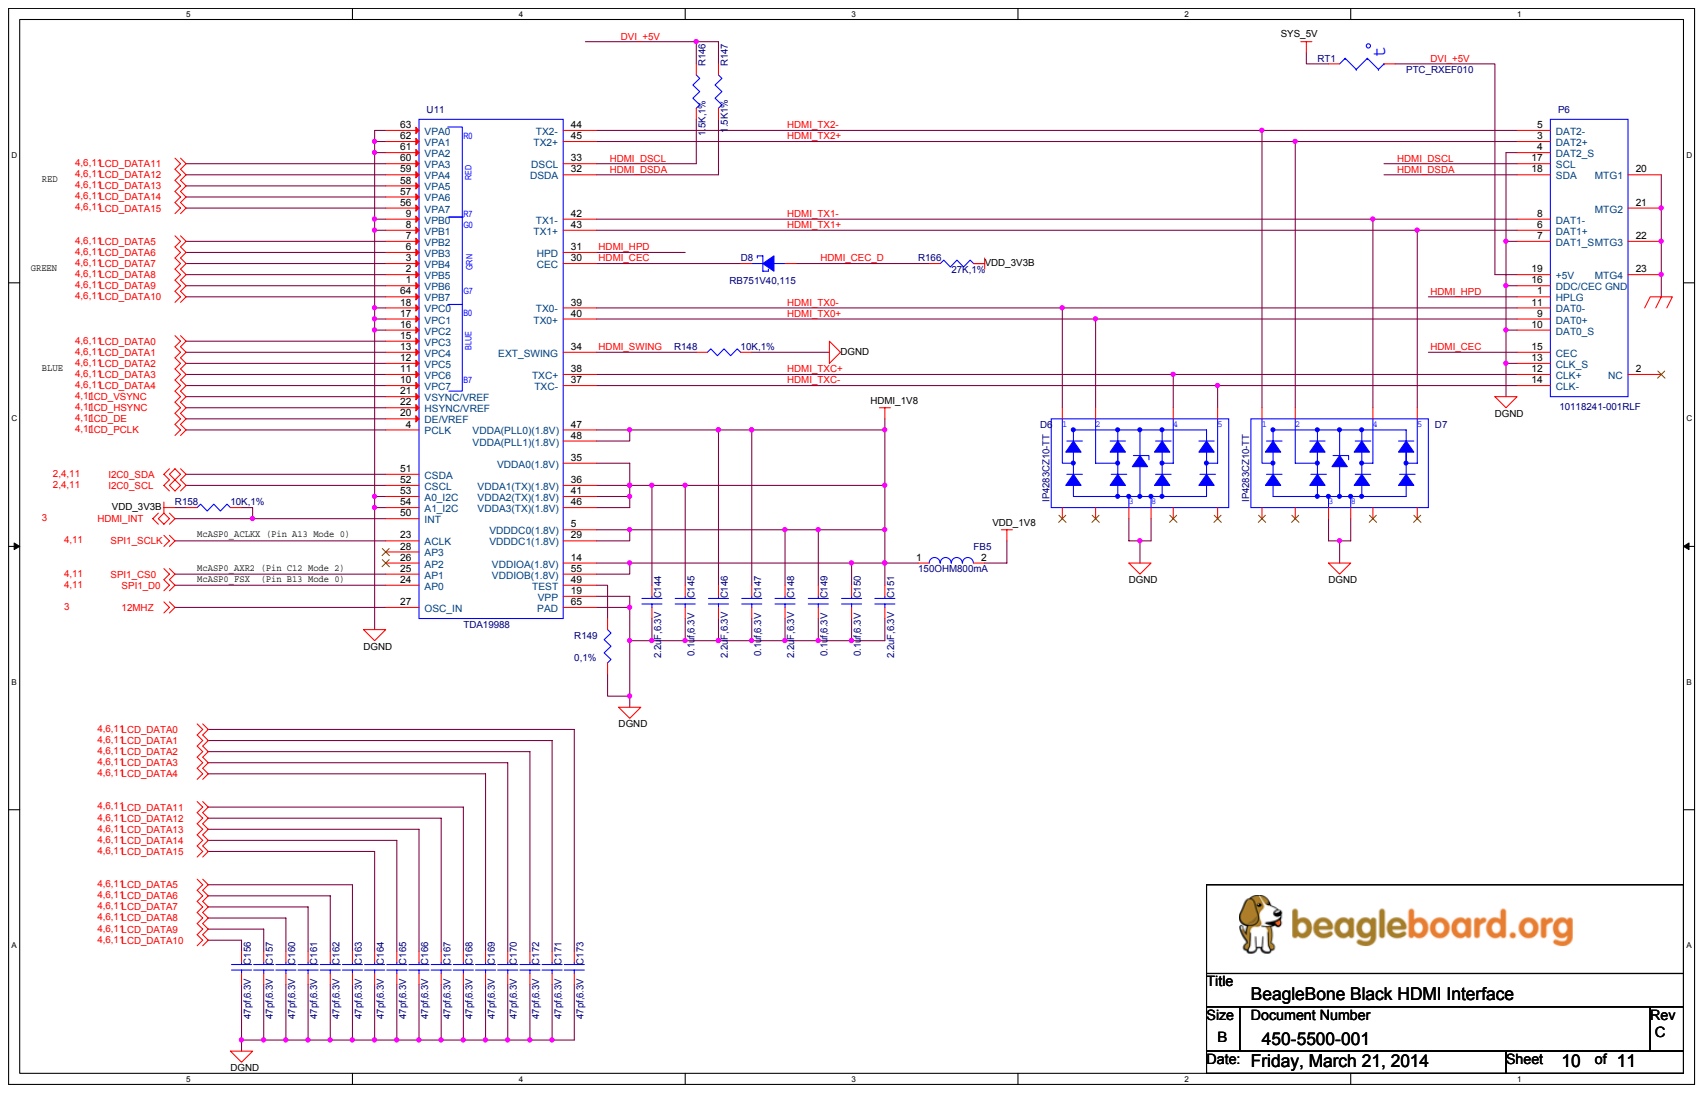
[picture p34: page 10]

Title
BeagleBone Black HDMI Interface

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

Date: Date: Date: Friday, March 21, 2014 Friday, March 21, 2014 Friday, March 21, 2014 | Sheet Sheet Sheet 10 10 10 of of of 11 11 11

### DGND

### VDD_5V

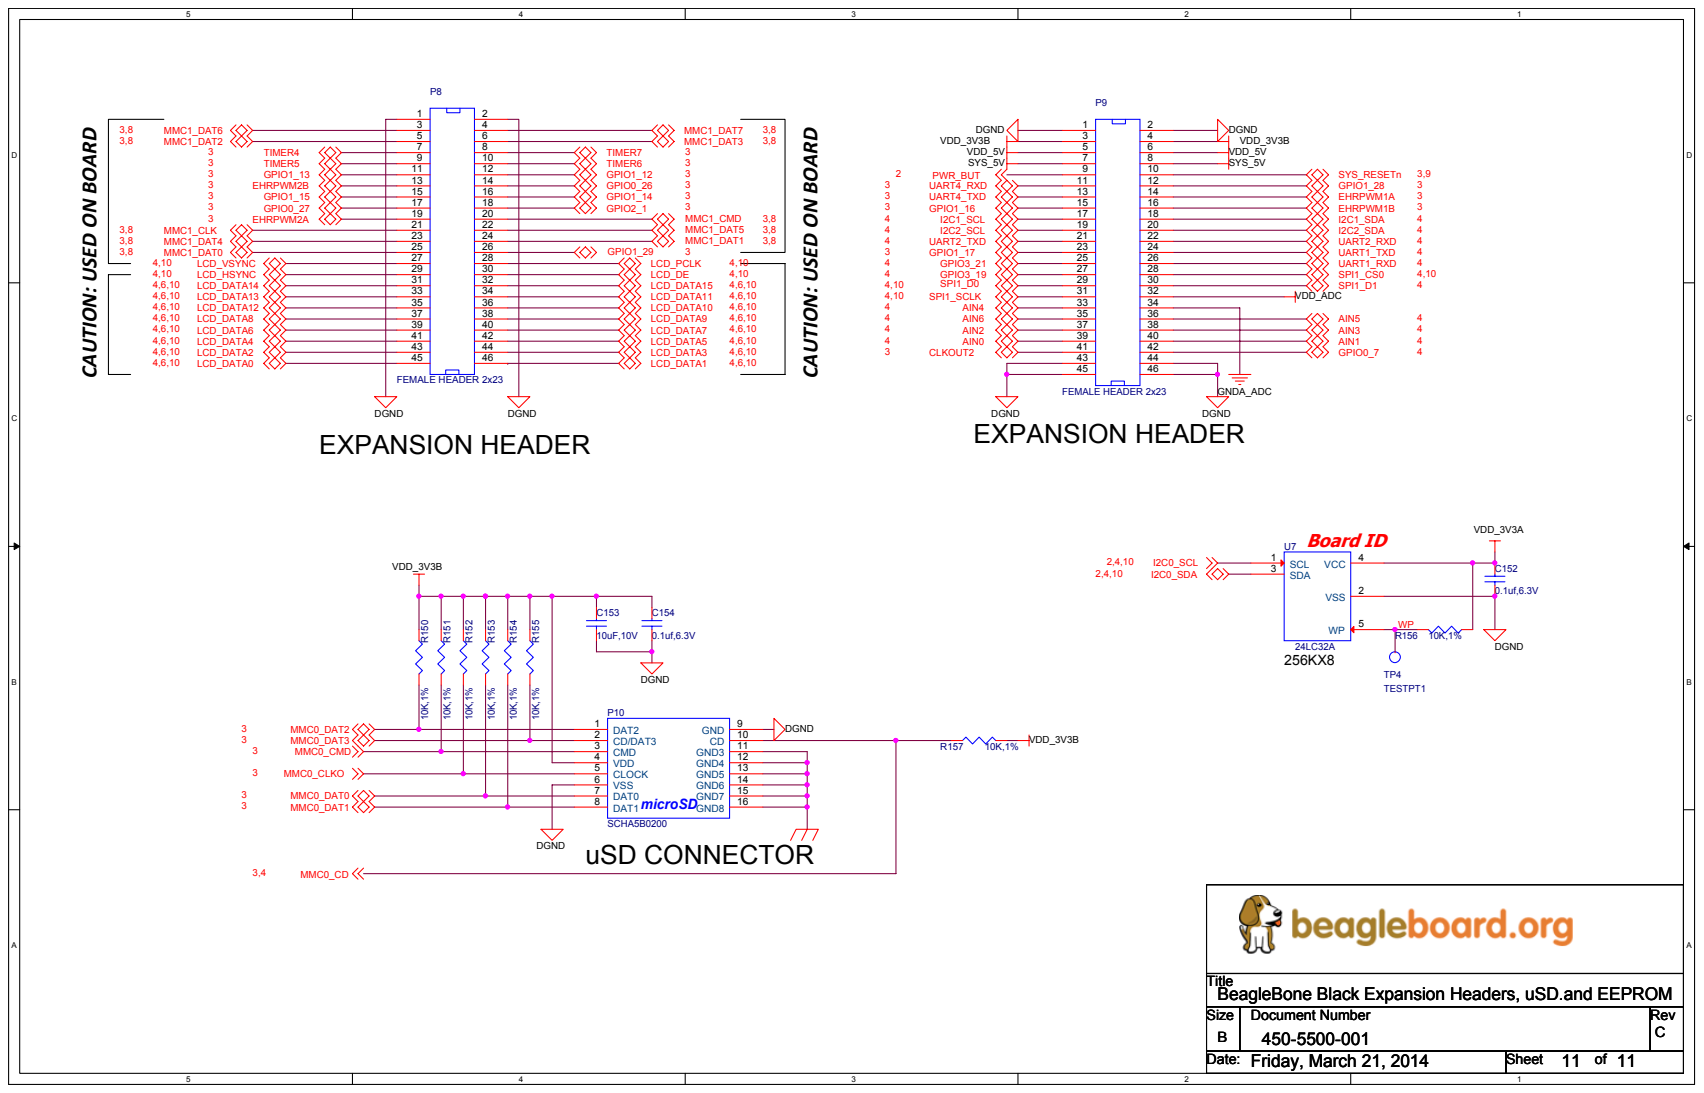
[picture p35: page 11]

CAUTION: USED ON BOARD

Title
BeagleBone Black Expansion Headers, uSD.and EEPROM

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

Date: Date: Date: Friday, March 21, 2014 Friday, March 21, 2014 Friday, March 21, 2014 | Sheet Sheet Sheet 11 11 11 of of of 11 11 11
