TheGiraffe/BBB-Schematics-Resources/(list of files, drawings)

Other design files:
Other Formats/altium2kicad/P01_Title Page.SchDoc
Other Formats/altium2kicad/P02_Power Management.SchDoc
Other Formats/altium2kicad/P03_AM335x 1_3, JTAG.SchDoc
Other Formats/altium2kicad/P04_AM335x 2_3, USB.SchDoc
Other Formats/altium2kicad/P05_AM335x 3_3.SchDoc
Other Formats/altium2kicad/P06_LED, Config.SchDoc
Other Formats/altium2kicad/P07_DDR3 Memory.SchDoc
Other Formats/altium2kicad/P08_eMMC FLASH.SchDoc
Other Formats/altium2kicad/P09_10_100 Ethernet.SchDoc
Other Formats/altium2kicad/P10_HDMI.SchDoc
Other Formats/altium2kicad/P11_Exp Conn, uSD.SchDoc
Other Formats/beaglebone-black-master/ALLEGRO/BEAGLEBONEBLK_C.DSN
Other Formats/BeagleBoneBlack/BeagleBoneBlack.pcb
Other Formats/BEAGLEBONEBLK_C.DSN
Other Formats/Imported BEAGLEBONEBLK_C.PrjPcb/BEAGLEBONEBLK_C.PrjPcb
Other Formats/Imported BEAGLEBONEBLK_C.PrjPcb/BEAGLEBONEBLK_C_Library.SchLib
