TheGiraffe/BBB-Schematics-Resources/BeagleBoneBlack-Cape-KiCad-Template/Projects/BeagleBone-Black-Cape/BeagleBone-Black-Cape.sch

## KiCad design BeagleBoneBlack-Cape-KiCad-Template/Projects/BeagleBone-Black-Cape/BeagleBone-Black-Cape.sch (2020-11-15)

Schematic: BeagleBone-Black-Cape.sch

Parts:
P8, P9: BeagleBone_Black_Header; Socket_BeagleBone_Black
