TheGiraffe/BBB-Schematics-Resources/Other Formats/altium2kicad/P02_Power Management-SchDoc.sch

## KiCad design Other Formats/altium2kicad/P02_Power Management-SchDoc.sch (2020-11-15)

Schematic: P02_Power Management-SchDoc.sch

Parts:
*_2: (no value)
DGND: GND
DGND_2, DGND_3, DGND_4, DGND_5, DGND_6, DGND_7, DGND_8, DGND_9, DGND_10, DGND_11, DGND_12, DGND_13, DGND_14, DGND_15, DGND_16, DGND_17, DGND_18, DGND_19, DGND_20, DGND_21, DGND_22: GND
GND_EARTH: GND
I2C0_SCL: I2C0_SCL
I2C0_SDA: I2C0_SDA
IC: 2.2uF,6.3V
LDO_PGOOD: LDO_PGOOD
PMIC_INT: PMIC_INT
PMIC_PGOOD: PMIC_PGOOD
PMIC_POWR_EN: PMIC_POWR_EN
PWR_BUT: PWR_BUT
SYS_5V, SYS_5V_2, SYS_5V_3, SYS_5V_4: SYS_5V
USB_DC: USB_DC
VDDS: VDD
VDDS_DDR: VDD
VDD_1V8: VDD_1V8
VDD_3V3A, VDD_3V3A_2, VDD_3V3A_3, VDD_3V3A_4: VDD_3V3A
VDD_3V3AUX: VDD_3V3AUX
VDD_3V3B: VDD_3V3B
VDD_5V: VDD_5V
VDD_CORE: VDD
VDD_MPU: VDD
VIO: VIO
VIO_2: VIO
VRTC: VRTC
WAKEUP: WAKEUP

Notes on the sheet:
BeagleBone~Black~Power~Management
450-5500-001
March~~8,~1995
=Date
RES_100K_1/16W_1%_0402
402
CONN3-PWR-PJ102A
RES_470_1/10W_5%_0402
1L0025
smd0.157inx0.157in
0.37
1.11
Digikey
VLCF5020T-2R2N2R6-3
TDK
2.2uH10%2.6Asmd
MTGH200C125D_PL
RES_4.75K_1/16W_1%_0402
U_48_RSL
CAP,~CER,~X7R,~0402,~50V,~10%,~0.1uF
CAP_2.2uF_X5R_6.3V_10%_0402
TP60C33D
CAP~CER~10UF~10V~Y5V~0805
CAP_10uF_Y5V_10V_10%_0805
805
SO8-25X75
CAP_470PF_X7R_25V_10%_0402
Capacitor~470pF~25V~10%~X7R
RES_1.5K_1/16W_5%_0402
DISCRETE
276-0043-000
SW4SMD_63X161LS
257-0020-000
LED_0603
tp1-8040
POWER LED
1.5V
500mA
POWER BUTTON
