TheGiraffe/BBB-Schematics-Resources/Other Formats/altium2kicad/P03_AM335x 1_3, JTAG-SchDoc.sch

## KiCad design Other Formats/altium2kicad/P03_AM335x 1_3, JTAG-SchDoc.sch (2020-11-15)

Schematic: P03_AM335x 1_3, JTAG-SchDoc.sch

Parts:
*_3: (no value)
IC47, IC50, IC67, IC69: 18pF,50V
IC48, IC68, IC70: 4.75K,1%
IC49, IC52, IC56, IC60, IC66, IC72, IC76: 0,1%
IC51: SN74LVC1G07DCK
IC53: 1M,1%
IC54, IC57, IC75: 33
IC55: SN74AUC1G74
IC58: 24MHz
IC59: 49.9,1%
IC61: 24.576MHZ
IC62: KMR231GLFS
IC63: 32.768KHz MC-306
IC64: SN74LVC1G06DCK
IC65: 10K,1%
IC71: CTI JTAG,DNI
IC73: 2.2uF,10V
IC74: AM3358BZCZ100

Connections:
12MHZ: IC75.2
12M_LOOP: IC55.2 (D), IC55.3 (~Q)
CLKOUT2: IC52.2, IC71.18 (EMU3)
CLKOUT_SRC: IC52.1, IC74.D14 (EVENT_INTR1/TCLKIN/CLKOUT2/TIMER7/PR1PR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)
DDR_A0: IC74.F3 (DDR_A0)
DDR_A1: IC74.H1 (DDR_A1)
DDR_A2: IC74.E4 (DDR_A2)
DDR_A3: IC74.C3 (DDR_A3)
DDR_A4: IC74.C2 (DDR_A4)
DDR_A5: IC74.B1 (DDR_A5)
DDR_A6: IC74.D5 (DDR_A6)
DDR_A7: IC74.E2 (DDR_A7)
DDR_A8: IC74.D4 (DDR_A8)
DDR_A9: IC74.C1 (DDR_A9)
DDR_A10: IC74.F4 (DDR_A10)
DDR_A11: IC74.F2 (DDR_A11)
DDR_A12: IC74.E3 (DDR_A12)
DDR_A13: IC74.H3 (DDR_A13)
DDR_A14: IC74.H4 (DDR_A14)
DDR_A15: IC74.D3 (DDR_A15)
DDR_BA0: IC74.C4 (DDR_BA0)
DDR_BA1: IC74.E1 (DDR_BA1)
DDR_BA2: IC74.B3 (DDR_BA2)
DDR_CASn: IC74.F1 (DDR_CASN)
DDR_CKE: IC74.G3 (DDR_CKE)
DDR_CLK: IC74.D2 (DDR_CK)
DDR_CLKn: IC74.D1 (DDR_NCK)
DDR_CSn: IC74.H2 (DDR_CSN0)
DDR_D0: IC74.M3 (DDR_D0)
DDR_D1: IC74.M4 (DDR_D1)
DDR_D2: IC74.N1 (DDR_D2)
DDR_D3: IC74.N2 (DDR_D3)
DDR_D4: IC74.N3 (DDR_D4)
DDR_D5: IC74.N4 (DDR_D5)
DDR_D6: IC74.P3 (DDR_D6)
DDR_D7: IC74.P4 (DDR_D7)
DDR_D8: IC74.J1 (DDR_D8)
DDR_D9: IC74.K1 (DDR_D9)
DDR_D10: IC74.K2 (DDR_D10)
DDR_D11: IC74.K3 (DDR_D11)
DDR_D12: IC74.K4 (DDR_D12)
DDR_D13: IC74.L3 (DDR_D13)
DDR_D14: IC74.L4 (DDR_D14)
DDR_D15: IC74.M1 (DDR_D15)
DDR_DQM0: IC74.M2 (DDR_DQM0)
DDR_DQM1: IC74.J2 (DDR_DQM1)
DDR_DQS0: IC74.P1 (DDR_DQS0)
DDR_DQS1: IC74.L1 (DDR_DQS1)
DDR_DQSN0: IC74.P2 (DDR_DQSN0)
DDR_DQSN1: IC74.L2 (DDR_DQSN1)
DDR_ODT: IC74.G1 (DDR_ODT)
DDR_RASn: IC74.G4 (DDR_RASN)
DDR_RESETn: IC74.G2 (DDR_RESETN)
DDR_VREF: IC74.J4 (VREFSSTL)
DDR_VTP: IC59.2, IC74.J3 (DDR_VTP)
DDR_WEn: IC74.B2 (DDR_WEn)
EHRPWM1A: IC74.U14 (GPMC_A2/GMII2_TXD3/RGMII2_TD3/MMC2_DAT1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)
EHRPWM1B: IC74.T14 (GPMC_A3/GMII2_TXD2/RGMII2_TD2/MMC2_DAT2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)
EHRPWM2A: IC74.U10 (GPMC_AD8/LCD_DATA23/MMC1_DAT0/MMC2_DAT4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)
EHRPWM2B: IC74.T10 (GPMC_AD9/LCD_DATA22/MMC1_DAT1/MMC2_DAT5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)
GND: IC50.2, IC51.3 (GND), IC55.4 (GND), IC59.1, IC60.1, IC61.2 (GND), IC62.1 (A1), IC64.3 (GND), IC70.2, IC71.4 (TDIS), IC71.8 (GND1), IC71.20 (GND5), IC72.1, IC72.2, IC73.2
GND_OSC0: IC74.V11 (VSS_OSC0)
GND_OSC1: IC47.1, IC74.A5 (VSS_RTC)
GPIO0_26: IC74.T11 (GPMC_AD10/LCD_DATA21/MMC1_DAT2/MMC2_DAT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)
GPIO0_27: IC74.U12 (GPMC_AD11/LCD_DATA20/MMC1_DAT3/MMC2_DAT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)
GPIO1_12: IC74.T12 (GPMC_AD12/LCD_DATA19/MMC1_DAT4/MMC2_DAT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)
GPIO1_13: IC74.R12 (GPMC_AD13/LCD_DATA18/MMC1_DAT5/MMC2_DAT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)
GPIO1_14: IC74.V13 (GPMC_AD14/LCD_DATA17/MMC1_DAT6/MMC2_DAT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)
GPIO1_15: IC74.U13 (GPMC_AD15/LCD_DATA16/MMC1_DAT7/MMC2_DAT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)
GPIO1_16: IC66.2
GPIO1_17: IC74.V14 (GPMC_A1/GMII2_RXDV/RGMII2_RCTL/MMC2_DAT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)
GPIO1_28: IC74.U18 (GPMC_BE1N/GMII2_COL/GPMC_CSN6/MMC2_DAT3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)
GPIO1_29: IC74.V6 (GPMC_CSN0/GPIO1_29)
GPIO2_1: IC74.V12 (GPMC_CLK/LCD_MEM_CLK/GPMC_WAIT1/MMC2_CL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)
GPIO3_20: IC49.2
GPIO3_21: IC57.2
HDMICLK_DISn: IC61.1 (OE), IC74.V17 (GPMC_A11/GMII2_RXD0/RGMII2_RD0/RMII2_RX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)
HDMI_INT: IC74.U16 (GPMC_A9/GMII2_RXD2/RGMII2_RD2/MMC2_DAT7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)
JTAG_EMU0: IC68.2, IC71.13 (EMU0), IC74.C14 (EMU0/GPIO3_7)
JTAG_EMU1: IC48.2, IC71.14 (EMU1), IC74.B14 (EMU1/GPIO3_8)
JTAG_TCK: IC71.9 (TCKRTN), IC71.11 (TCK), IC74.A12 (TCK)
JTAG_TDI: IC71.3 (TDI), IC74.B11 (TDI)
JTAG_TDO: IC71.7 (TDO), IC74.A11 (TDO)
JTAG_TMS: IC71.1 (TMS), IC74.C11 (TMS)
JTAG_TRSTn: IC70.1, IC71.2 (TRSTn), IC74.B10 (NTRST)
LDO_PGOOD: IC74.B5 (RTC_PORZn)
MMC0_CD: IC71.19 (EMU4)
MMC0_CLKO: IC74.G17 (MMC0_CLK/GPMC_A24/UART3_CTSN/UART2_RXD/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)
MMC0_CMD: IC74.G18 (MMC0_CMD/GPMC_A25/UART3_RTSN/UART2_TXD/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)
MMC0_DAT0: IC74.G16 (MMC0_DAT0/GPMC_A23/UART5_RTSN/UART3_TXD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)
MMC0_DAT1: IC74.G15 (MMC0_DAT1/GPMC_A22/UART5_CTSN/UART3_RXD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)
MMC0_DAT2: IC74.F18 (MMC0_DAT2/GPMC_A21/UART4_RTSN/TIMER6/UA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)
MMC0_DAT3: IC74.F17 (MMC0_DAT3/GPMC_A20/UART4_CTSN/TIMER5/UA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)
MMC1_CLK: IC74.U9 (GPMC_CSN1/GPMC_CLK/MMC1_CLK/PRT1EDIO_DA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)
MMC1_CMD: IC74.V9 (GPMC_CSN2/GPMC_BE1N/MMC1_CMD/PR1_EDIO_D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)
MMC1_DAT0: IC74.U7 (GPMC_AD0/MMC1_DAT0//////GPIO1_0)
MMC1_DAT1: IC74.V7 (GPMC_AD1/MMC1_DAT1//////GPIO1_1)
MMC1_DAT2: IC74.R8 (GPMC_AD2/MMC1_DAT2//////GPIO1_2)
MMC1_DAT3: IC74.T8 (GPMC_AD3/MMC1_DAT3//////GPIO1_3)
MMC1_DAT4: IC74.U8 (GPMC_AD4/MMC1_DAT4//////GPIO1_4)
MMC1_DAT5: IC74.V8 (GPMC_AD5/MMC1_DAT5//////GPIO1_5)
MMC1_DAT6: IC74.R9 (GPMC_AD6/MMC1_DAT6//////GPIO1_6)
MMC1_DAT7: IC74.T9 (GPMC_AD7/MMC1_DAT7//////GPIO1_7)
unnamed: IC55.5 (Q), IC75.1
unnamed: IC57.1, IC61.3 (CLK)
unnamed: IC64.2 (A), IC74.R14 (GPMC_A4/GMII2_TXD1/RGMII2_TD1/RMII2_TXD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)
unnamed: IC64.4 (Y), IC76.1
unnamed: IC65.2, IC73.1
OSC0_IN: IC50.1, IC74.V10 (OSC0_IN)
OSC0_OUT: IC53.2, IC74.U11 (OSC0_OUT)
OSC0_OUT1: IC58.1, IC69.1
OSC1_IN: IC47.2, IC74.A6 (OSC1_IN)
OSC1_OUT: IC74.A4 (OSC1_OUT)
OSC1_OUT1: IC63.4, IC67.2
PMIC_INT: IC74.B18 (NNMI)
PMIC_PGOOD: IC74.B15 (PORZn)
PROC_A15: IC54.1, IC74.A15 (EVENT_INTR0/TIMER4/CLKOUT1/SPI1_CS1/PR1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)
SYS_RESETn: IC71.15 (SRST), IC74.A10 (NRESET_INOUT)
TIMER4: IC74.R7 (GPMC_ADVN_ALE/TIMER4/GPIO2_2)
TIMER5: IC74.T6 (GPMC_BE0N_CLE/TIMER5/GPIO2_5)
TIMER6: IC74.U6 (GPMC_WEN/TIMER6/GPIO2_4)
TIMER7: IC74.T7 (GPMC_OEN_REN/TIMER7/EMU4/GPIO2_3)
U5_R13: IC66.1, IC74.R13 (GPMC_A0/GMII2_TXEN/RGMII2_TCTL/RMII2_TX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)
U5_T13: IC56.1, IC74.T13 (GPMC_CSN3/MMC2_CMD/PR1_MDIO_DATA/GPIO2_0)
UART4_RXD: IC74.T17 (GPMC_WAIT0/GM112_CRS/GPMC_CSN4/RMII2_CR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)
UART4_TXD: IC74.U17 (GPMC_WPN/GMII2_RXERR/GPMC_CSN5/RMII2_RX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)
USB1_OCn: IC74.T16 (GPMC_A10/GMII2_RXD1/RGMII2_RD1/RMII2_RX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)
USR0: IC74.V15 (GPMC_A5/GMII2_TXD0/RGMII2_TD0/RMII2_TXD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)
USR1: IC74.U15 (GPMC_A6/GMII2_TXCLK/RGMII2_TCLK/MMC2_DA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)
USR2: IC74.T15 (GPMC_A7/GMII2_RXCLK/RGMII2_RCLK/MMC2_DA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)
USR3: IC74.V16 (GPMC_A8/GMII2_RXD3/RGMII2_RD3/MMC2_DAT6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)
VIO: IC51.5 (VCC)
XDMA_EVENT_INTR0: IC54.2, IC55.1 (CLK), IC71.17 (EMU2)
eMMC_RSTn: IC76.2

Notes on the sheet:
BeagleBone~Black~Processor~1~of~3~and~JTAG
450-5500-001
March~~8,~1995
=Date
RES_33_0402
0402
RES_4.75K_1/16W_1%_0402
402
HEADERCTIJTAG10x2Pin
Samtec
FTR-110-03-G-D-06
1.20
0.97
SMD10x2Pin0.050in
2H0039
RES_0_1/16W_1%_0402
CAP_1.0uF_X5R_10V_10%_0402
CAP,~CER,~X7R,~0402,~50V,~10%,~0.1uF
IC_AM335x_ZCE
1A0242
FBGAZCZ15x15_tbd
Arrow
AM335x~15x15~FBGA~ZCE
AM335X_15x15
10.00
CAP_18PF_COG_50V_5%_0402
IC_SN74LVC1G07DCK
DCK5_2P15X1P4
RES_1M_1/16W_1%_0402
SOP8_DCT
1Y0033
SM_CRY_SCC18
0.51
0.90
Suntsu~Inc
SCC18B-24.000MHz~TR
Suntsu
Crystal24MHzSCC
Oscillator~12MHz~50ppm~SMD~1.8V
1Y0028
SMD~5x3.2mm
1.12
2.46
Digikey
ECS-3518-120-B-TR
ECS
Oscillator12MHzSMD
DISCRETE
276-0043-000
SW4SMD_63X161LS
tbd
Crystal32.768KHzMC306
Epson
MC-30632.7680k-A
0.41
0.338
smd
1Y0029
RES_10K_1/16W_1%_0402
RESET
CEC Clock for HDMI Framer
3.3V
1.8V
