TheGiraffe/BBB-Schematics-Resources/Other Formats/altium2kicad/P04_AM335x 2_3, USB-SchDoc.sch

## KiCad design Other Formats/altium2kicad/P04_AM335x 2_3, USB-SchDoc.sch (2020-11-15)

Schematic: P04_AM335x 2_3, USB-SchDoc.sch

Parts:
*_4: (no value)
IC78: 33
IC79, IC80, IC83, IC98, IC103: 0,1%
IC81: 0.001uf,50V
IC82, IC92, IC99: 4.75K,1%
IC84: HEADER 6
IC85: 150OHM800mA
IC86: USB5MINI
IC87: 22
IC88: 100uF,6.3V
IC89, IC90, IC91: 0
IC93, IC102: 10K,1%
IC94: 87520-0010BLF
IC95: TPS2051 (DGN)
IC96: SN74LVC2G241
IC97: 100K,1%
IC100: 0.1 Ohm,0805
IC101: AM3358BZCZ100
IC104: TESTPT1
IC105, IC106: TPD4S012

Connections:
AIN0: IC101.B6 (AIN0)
AIN1: IC101.C7 (AIN1)
AIN2: IC101.B7 (AIN2)
AIN3: IC101.A7 (AIN3)
AIN4: IC101.C8 (AIN4)
AIN5: IC101.B8 (AIN5)
AIN6: IC101.A8 (AIN6)
AIN7: IC101.C9 (AIN7)
B_UART0_RX: IC84.4
B_UART0_TX: IC84.5, IC96.3 (2Y)
GND: IC80.1, IC82.2, IC84.1, IC86.5 (G1), IC86.9 (G4), IC88.2, IC93.2, IC94.4, IC94.5 (SHELD1), IC95.1 (GND), IC95.9 (PAD), IC97.2, IC106.4 (GND)
GPIO0_7: IC83.1
GPIO0_7SRC: IC83.2, IC101.C18 (ECAP0_IN_PWM0_OUT/UART3_TXD/SPI1_CS1/PR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)
GPIO3_18: IC79.2, IC101.B12 (MCASP0_ACLKR/EQEP0A_IN/MCASP0_AXR2/MCAS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)
GPIO3_19: IC101.C13 (MCASP0_FSR/EQEP0B_IN/MCASP0_AXR3/MCASP1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)
GPIO3_20: IC101.D13 (MCASP0_AXR1/EQEP0_INDEX//MCASP1_AXR0/EM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)
GPIO3_21: IC101.A14 (MCASP0_AHCLKX/EQEP0_STROBE/MCASP0_AXR3/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)
I2C0_SCL: IC101.C16 (I2C0_SCL/TIMER7/UART2_RTSN/ECAP1_IN_PWM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)
I2C0_SDA: IC101.C17 (I2C0_SDA/TIMER4/UART2_CTSN/ECAP2_IN_PWM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)
I2C1_SCL: IC101.A16 (SPI0_CS0/MMC2_SDWP/I2C1_SCL/EHRPWM0_SYN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)
I2C1_SDA: IC101.B16 (SPI0_D1/MMC1_SDWP/I2C1_SDA/EHRPWM0_TRIP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)
I2C2_SCL: IC101.D17 (UART1_RTSN/TIMER5/DCAN0_RX/I2C2_SCL/SPI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)
I2C2_SDA: IC101.D18 (UART1_CTSN/TIMER6/DCAN0_TX/I2C2_SDA/SPI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)
LCDDE: IC91.1, IC101.R6 (LCD_AC_BIAS_EN/GPMC_A11//PR1_EDIO_DATA_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)
LCDPCLK: IC87.1, IC101.V5 (LCD_PCLK/GPMC_A10//PR1_EDIO_DATA_IN4/PR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)
LCDVHYNC: IC90.1, IC101.R5 (LCD_HSYNC/GPMC_A9//PR1_EDIO_DATA_IN3/PR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)
LCDVSYNC: IC89.1, IC101.U5 (LCD_VSYNC/GPMC_A8//PR1_EDIO_DATA_IN2/PR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)
LCD_DATA0: IC101.R1 (LCD_DATA0/GPMC_A0//EHRPWM2A//PR1_PRU1_P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)
LCD_DATA1: IC101.R2 (LCD_DATA1/GPMC_A1//EHRPWM2B//PR1_PRU1_P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)
LCD_DATA2: IC101.R3 (LCD_DATA2/GPMC_A2//EHRPWM2_TRIPZONE_INP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)
LCD_DATA3: IC101.R4 (LCD_DATA3/GPMC_A3//EHRPWM2_SYNCI_O//PR1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)
LCD_DATA4: IC101.T1 (LCD_DATA4/GPMC_A4//EQEP2A_IN//PR1_PRU1_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)
LCD_DATA5: IC101.T2 (LCD_DATA5/GPMC_A5//EQEP2B_IN//PR1_PRU1_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)
LCD_DATA6: IC101.T3 (LCD_DATA6/GPMC_A6/PR1_EDIO_DATA_IN6/EQE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)
LCD_DATA7: IC101.T4 (LCD_DATA7/GPMC_A7/PR1_EDIO_DATA_IN7/EQE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)
LCD_DATA8: IC101.U1 (LCD_DATA8/GPMC_A12/EHRPWM1_TRIPZONE_INP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)
LCD_DATA9: IC101.U2 (LCD_DATA9/GPMC_A13/EHRPWM1_SYNCI_O/MCAS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)
LCD_DATA10: IC101.U3 (LCD_DATA10/GPMC_A14/EHRPWM1A/MCASP0_AXR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)
LCD_DATA11: IC101.U4 (LCD_DATA11/GPMC_A15/EHRPWM1B/MCASP0_AHC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)
LCD_DATA12: IC101.V2 (LCD_DATA12/GPMC_A16/EQEP1A_IN/MCASP0_AC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)
LCD_DATA13: IC101.V3 (LCD_DATA13/GPMC_A17/EQEP1B_IN/MCASP0_FS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)
LCD_DATA14: IC101.V4 (LCD_DATA14/GPMC_A18/EQEP1_INDEX/MCASP0_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)
LCD_DATA15: IC101.T5 (LCD_DATA15/GPMC_A19/EQEP1_STROBE/MCASP0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)
LCD_DE: IC91.2
LCD_HSYNC: IC90.2
LCD_PCLK: IC87.2
LCD_VSYNC: IC89.2
MDIO_CLK: IC101.M18 (MDIO_CLK/TIMER5/UART5_TXD/UART3_RTSN/MM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)
MDIO_DATA: IC101.M17 (MDIO_DATA/TIMER6/UART5_RXD/UART3_CTSN/M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)
MII1_COL: IC101.H16 (GMII1_COL/RMII2_REFCLK/SPI1_SCLK/UART5_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)
MII1_CRS_DV: IC101.H17 (GMII1_CRS/RMII1_CRS_DV/SPI1_D0/I2C1_SDA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)
MII1_REFCLK: IC78.2
MII1_RXCLK: IC101.L18 (GMII1_RXCLK/UART2_TXD/RGMII1_RCLK/MMC0_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)
MII1_RXD0: IC101.M16 (GMII1_RXD0/RMII1_RXD0/RGMII1_RD0/MCASP1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)
MII1_RXD1: IC101.L15 (GMII1_RXD1/RMII1_RXD1/RGMII1_RD1/MCASP1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)
MII1_RXD2: IC101.L16 (GMII1_RXD2/UART3_TXD/RGMII1_RD2/MMC0_DA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)
MII1_RXD3: IC101.L17 (GMII1_RXD3/UART3_RXD/RGMII1_RD3/MMC0_DA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)
MII1_RXDV: IC101.J17 (GMII1_RXDV/LCD_MEMORY_CLK/RGMII1_RCTL/U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)
MII1_RXERR: IC101.J15 (GMII1_RXERR/RMII1_RXERR/SPI1_D1/I2C1_SC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)
MII1_TXCLK: IC101.K18 (GMII1_TXCLK/UART2_RXD/RGMII1_TCLK/MMC0_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)
MII1_TXD0: IC101.K17 (GMII1_TXD0/RMII1_TXD0/RGMII1_TD0/MCASP1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)
MII1_TXD1: IC101.K16 (GMII1_TXD1/RMII1_TXD1/RGMII1_TD1/MCASP1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)
MII1_TXD2: IC101.K15 (GMII1_TXD2/DCAN0_RX/RGMII1_TD2/UART4_TX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)
MII1_TXD3: IC101.J18 (GMII1_TXD3/DCAN0_TX/RGMII1_TD3/UART4_RX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)
MII1_TXEN: IC101.J16 (GMII1_TXEN/RMII1_TXEN/RGMII1_TCTL/TIMER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)
MMC0_CD: IC101.C15 (SPI0_CS1/UART3_RXD/ECAP1_IN_PWM1_OUT/MM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)
unnamed: IC82.1, IC92.2
unnamed: IC96.2 (1A), IC97.1
unnamed: IC98.2, IC101.P15 (USB0_VBUS)
PMIC_POWR_EN: IC101.C6 (PMIC_POWER_EN)
SPI1_CS0: IC101.C12 (MCASP0_AHCLKR/EHRPWM0_SYNCI_O/MCASP0_AX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)
SPI1_D0: IC101.B13 (MCASP0_FSX/EHRPWM0B//SPI1_D0/MMC1_SDCD/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)
SPI1_D1: IC101.D12 (MCASP0_AXR0/EHRPWM0_TRIPZONE_INPUT//SPI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)
SPI1_SCLK: IC101.A13 (MCASP0_ACLKX/EHRPWM0A//SPI1_SCLK/MMC0_S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)
U5_H18: IC78.1, IC101.H18 (RMII1_REFCLK/XDMA_EVENT_INTR2/SPI1_CS0/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)
UART0_RX: IC96.6 (1Y), IC101.E15 (UART0_RXD/SPI1_CS0/DCAN0_TX/I2C2_SDA/EC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)
UART0_TX: IC96.5 (2A), IC101.E16 (UART0_TXD/SPI1_CS1/DCAN0_RX/I2C2_SCL/EC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)
UART1_RXD: IC101.D16 (UART1_RXD/MMC1_SDWP/DCAN1_TX/I2C1_SDA//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)
UART1_TXD: IC101.D15 (UART1_TXD/MMC2_SDWP/DCAN1_RX/I2C1_SCL//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)
UART2_RXD: IC101.A17 (SPI0_SCLK/UART2_RXD/I2C2_SDA/EHRPWM0A/P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)
UART2_TXD: IC101.B17 (SPI0_D0/UART2_TXD/I2C2_SCL/EHRPWM0B/PR1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)
USB0_DM: IC86.2 (D-), IC101.N18 (USB0_DM), IC106.2 (D-)
USB0_DP: IC86.3 (D+), IC101.N17 (USB0_DP), IC106.1 (D+)
USB0_ID: IC86.4 (ID), IC101.P16 (USB0_ID), IC106.3 (ID)
USB1_DM: IC94.2, IC101.R18 (USB1_DM), IC105.2 (D-)
USB1_DP: IC94.3, IC101.R17 (USB1_DP), IC105.1 (D+)
USB1_DRVVBUS: IC93.1, IC95.4 (EN), IC101.F15 (USB1_DRVVBUS/GPIO3_13)
USB1_ID: IC80.2, IC101.P17 (USB1_ID)
USB1_OCn: IC102.2
USB1_PWR: IC85.1, IC95.8 (OUT1)
USB1_VBUS: IC100.1, IC101.T18 (USB1_VBUS)
USB_DC: IC98.1, IC106.6 (VBUS)
VBUS: IC85.2, IC94.1
VDD: IC103.1
VREFN_ADC: IC101.A9 (VREFN)
VREFP_ADC: IC101.B9 (VREFP), IC103.2
VRTC: IC99.1
WAKEUP: IC101.C5 (EXT_WAKEUP)

Notes on the sheet:
BeagleBone~Black~Processor~2~of~3,~USB,~~and~Serial
450-5500-001
March~~8,~1995
=Date
CAP_100uF_TANT_6.3V_3528-21
CAP~CER~100UF~10V~Y5V~0805
RD205SMD_250D
RES_4.75K_1/16W_1%_0402
402
RES_10K_1/16W_1%_0402
RES_0_1/16W_1%_0402
TP60C33D
1A0233
smd~UFDFN-6pin
0.23
0.76
Digikey
TPD4S012DRY
TPD4S012
RES_33_0402
0402
RES_100K_1/16W_1%_0402
Capacitor~0.001uF~50V~5%~0402
CAP_0.001uf_X7R_50V_0402
SIP6
FER_180_200_0805
1L0010
805
LI0805H151R-10
Steward
FerriteBead150ohm800mA
KYCON
Tyco
KMAB-SMT-5S-S-30TR
4500.0223
C-440247
Deltron
AMP
USB5MINI_4SHIELDED_SMD-5
224-0234-000
USB_A_SH
DGN-16X60
U_8_DCU
USB HOST
UART0 Serial Port
Mark pin 1 clearly
POWERDOWN ISOLATION
