TheGiraffe/BBB-Schematics-Resources/Other Formats/altium2kicad/P05_AM335x 3_3-SchDoc.sch

## KiCad design Other Formats/altium2kicad/P05_AM335x 3_3-SchDoc.sch (2020-11-15)

Schematic: P05_AM335x 3_3-SchDoc.sch

Parts:
*_5: (no value)
IC108, IC110, IC123: 150OHM800mA
IC109, IC114, IC120, IC121, IC126: 1uF,10V
IC111, IC112, IC113, IC117, IC122, IC124, IC125: 10uF,10V
IC115, IC118: TESTPT1
IC116: AM3358BZCZ100
IC119: 10K,1%

Connections:
CAP_VBB_MPU: IC114.1, IC116.C10 (CAP_VBB_MPU)
CAP_VDD_SRAM_CORE: IC116.D9 (CAP_VDD_SRAM_CORE), IC126.1
CAP_VDD_SRAM_MPU: IC116.D11 (CAP_VDD_SRAM_MPU), IC121.1
ENZ_KALDO_1P8V: IC116.B4 (ENZ_KALDO_1P8V), IC119.2
GND: IC108.2, IC109.2, IC114.2, IC116.A1 (VSS1), IC116.F8 (VSS3), IC116.G8 (VSS4), IC116.M6 (VSS28), IC116.M14 (VSSA_USB2), IC116.N10 (VSS35), IC116.V18 (VSS38), IC117.1, IC119.1, IC122.2
unnamed: IC108.1, IC116.E8 (VSSA_ADC)
unnamed: IC110.2, IC116.H15 (VDDS_PLL_MPU)
unnamed: IC116.D8 (VDDA_ADC), IC123.1
unnamed: IC116.E10 (VDDSHV61), IC116.E13 (VDDSHV64), IC116.G14 (VDDSHV66), IC116.K14 (VDDSHV51), IC116.P6 (VDDSHV69), IC122.1
unnamed: IC116.K13 (VDDS4), IC116.N6 (VDDS5), IC116.P14 (VDDS7)
TESTOUT: IC116.A3 (TESTOUT)
VDD: IC111.2, IC112.2, IC116.E5 (VDDS_DDR1), IC116.E7 (VDDS_PLL_DDR), IC116.F10 (VDD_MPU1), IC116.H5 (VDDS_DDR4), IC116.H11 (VDD_CORE6), IC116.J5 (VDDS_DDR5), IC116.K8 (VDD_CORE9), IC116.M13 (VDD_CORE16), IC116.N12 (VDD_CORE19), IC116.R10 (VDDS_PLL_CORE_LCD), IC116.R11 (VDDS_OSC), IC124.2, IC125.2
VDD_MPUON: IC116.A2 (VDD_MPU_MON)
VDD_RTC: IC116.D6 (CAP_VDD_RTC), IC120.1
VRTC: IC116.D7 (VDDS_RTC)

Notes on the sheet:
BeagleBone~Black~Processr~3~of~3
450-5500-001
March~~8,~1995
=Date
TP60C_SMD
CAP_1.0uF_X5R_10V_10%_0402
CAP,~CER,~X7R,~0402,~50V,~10%,~0.1uF
402
CAP~CER~10UF~10V~Y5V~0805
CAP_10uF_Y5V_10V_10%_0805
805
FER_180_200_0805
1L0010
Digikey
LI0805H151R-10
Steward
FerriteBead150ohm800mA
RES_10K_1/16W_1%_0402
