TheGiraffe/BBB-Schematics-Resources/Other Formats/altium2kicad/P06_LED, Config-SchDoc.sch

## KiCad design Other Formats/altium2kicad/P06_LED, Config-SchDoc.sch (2020-11-15)

Schematic: P06_LED, Config-SchDoc.sch

Parts:
*_6: (no value)
DGND_70, DGND_71, DGND_72, DGND_73, DGND_74, DGND_75, DGND_76, DGND_77, DGND_78, DGND_79: GND
IC: LTST-C191TBKT
LCD_DATA0_2: LCD_DATA0
LCD_DATA1_2: LCD_DATA1
LCD_DATA2_2: LCD_DATA2
LCD_DATA3_2: LCD_DATA3
LCD_DATA4_2: LCD_DATA4
LCD_DATA5_2: LCD_DATA5
LCD_DATA6_2: LCD_DATA6
LCD_DATA7_2: LCD_DATA7
LCD_DATA8_2: LCD_DATA8
LCD_DATA9_2: LCD_DATA9
LCD_DATA10_2: LCD_DATA10
LCD_DATA11_2: LCD_DATA11
LCD_DATA12_2: LCD_DATA12
LCD_DATA13_2: LCD_DATA13
LCD_DATA14_2: LCD_DATA14
LCD_DATA15_2: LCD_DATA15
SYS_5V_6: SYS_5V
USR0_2: USR0
USR1_2: USR1
USR2_2: USR2
USR3_2: USR3
VDD_3V3A_12: VDD_3V3A

Notes on the sheet:
BeagleBone~Black~LED,~Configuration,~and~Reset
450-5500-001
March~~8,~1995
=Date
RES_100K_1/16W_1%_0402
402
257-0020-000
DISCRETE
LED_0603
RES_470_1/10W_5%_0402
276-0043-000
SW4SMD_63X161LS
2130.0100
2130.0137
BCR135S
Toshiba
SMini6-F3-B
SYS_BOOT8
SYS_BOOT9
SYS_BOOT10
SYS_BOOT11
SYS_BOOT12
SYS_BOOT13
SYS_BOOT14
SYS_BOOT15
SYS_BOOT4
User LED's
Boot Configuration
SYS_BOOT0
SYS_BOOT1
SYS_BOOT2
SYS_BOOT3
SYS_BOOT5
SYS_BOOT6
SYS_BOOT7
USR0
USR1
USR2
USR3
uSD BOOT
