TheGiraffe/BBB-Schematics-Resources/Other Formats/altium2kicad/P07_DDR3 Memory-SchDoc.sch

## KiCad design Other Formats/altium2kicad/P07_DDR3 Memory-SchDoc.sch (2020-11-15)

Schematic: P07_DDR3 Memory-SchDoc.sch

Parts:
*_7: (no value)
DDR_A[15..0]_2: DDR_A[15..0]
DDR_BA[2..0]_2: DDR_BA[2..0]
DDR_CASn_2: DDR_CASn
DDR_CKE_2: DDR_CKE
DDR_CLK_2: DDR_CLK
DDR_CLKn_2: DDR_CLKn
DDR_CSn_2: DDR_CSn
DDR_DQM0_2: DDR_DQM0
DDR_DQM1_2: DDR_DQM1
DDR_DQS0_2: DDR_DQS0
DDR_DQS1_2: DDR_DQS1
DDR_DQSN0_2: DDR_DQSN0
DDR_DQSN1_2: DDR_DQSN1
DDR_D[15..0]_2: DDR_D[15..0]
DDR_ODT_2: DDR_ODT
DDR_RASn_2: DDR_RASn
DDR_RESETn_2: DDR_RESETn
DDR_VREF_2: DDR_VREF
DDR_WEn_2: DDR_WEn
DGND_80, DGND_81, DGND_82, DGND_83, DGND_84, DGND_85, DGND_86: GND
IC: 1.5K,1%
VDDS_DDR_3, VDDS_DDR_4, VDDS_DDR_5, VDDS_DDR_6, VDDS_DDR_7, VDDS_DDR_8: VDD

Notes on the sheet:
BeagleBone~Black~DDR3~Memory
450-5500-001
March~~8,~1995
=Date
Capacitor~0.001uF~50V~5%~0402
CAP_0.001uf_X7R_50V_0402
402
SM-7351-RES-0402
240E1/10W1%smd0402
RES~240~OHM~1/10W~1%~0402~SMD
ERJ-2RKF2400X
4/12/2010
Sankar
KOA
Thick~Film
Panasonic-ECG
MT41J256M16RE-15E
Micron
DDR3~Memory~4Gb
BGA96_T9_P8_9X14
CAP~CER~10UF~10V~Y5V~0805
CAP_10uF_Y5V_10V_10%_0805
805
RES_10K_1/16W_1%_0402
DDR3L SDRAM
4Gb DDR3
D2516EC4BXGGB
