TheGiraffe/BBB-Schematics-Resources/Other Formats/altium2kicad/P08_eMMC FLASH-SchDoc.sch

## KiCad design Other Formats/altium2kicad/P08_eMMC FLASH-SchDoc.sch (2020-11-15)

Schematic: P08_eMMC FLASH-SchDoc.sch

Parts:
*_8: (no value)
DGND_87, DGND_88, DGND_89: GND
IC: 10K,1%
MMC1_CLK_2: MMC1_CLK
MMC1_CMD_2: MMC1_CMD
MMC1_DAT0_2: MMC1_DAT0
MMC1_DAT1_2: MMC1_DAT1
MMC1_DAT2_2: MMC1_DAT2
MMC1_DAT3_2: MMC1_DAT3
MMC1_DAT4_2: MMC1_DAT4
MMC1_DAT5_2: MMC1_DAT5
MMC1_DAT6_2: MMC1_DAT6
MMC1_DAT7_2: MMC1_DAT7
VDD_3V3B_7, VDD_3V3B_8, VDD_3V3B_9: VDD_3V3B
eMMC_RSTn_2: eMMC_RSTn

Notes on the sheet:
Beagle~BoneBlack~4G~eMMC
450-5500-001
March~~8,~1995
=Date
RES_10K_1/16W_1%_0402
402
CAP,~CER,~X7R,~0402,~50V,~10%,~0.1uF
CAP_2.2uF_X5R_6.3V_10%_0402
BGA153_P14_P5_11P5X13
CAP~CER~10UF~10V~Y5V~0805
CAP_10uF_Y5V_10V_10%_0805
805
MTFC4GLDEA 0M WT
KE4CN2H5A-A58
