TheGiraffe/BBB-Schematics-Resources/Other Formats/altium2kicad/P09_10_100 Ethernet-SchDoc.sch

## KiCad design Other Formats/altium2kicad/P09_10_100 Ethernet-SchDoc.sch (2020-11-15)

Schematic: P09_10_100 Ethernet-SchDoc.sch

Parts:
*_9: (no value)
DGND_90, DGND_91, DGND_92, DGND_93, DGND_94, DGND_95, DGND_96, DGND_97, DGND_98, DGND_99, DGND_100, DGND_101, DGND_102, DGND_103, DGND_104, DGND_105, DGND_106, DGND_107, DGND_108, DGND_109: GND
GND_EARTH_4: GND
IC: LAN8710A
MDIO_CLK_2: MDIO_CLK
MDIO_DATA_2: MDIO_DATA
MII1_COL_2: MII1_COL
MII1_CRS_DV_2: MII1_CRS_DV
MII1_REFCLK_2: MII1_REFCLK
MII1_RXCLK_2: MII1_RXCLK
MII1_RXD0_2: MII1_RXD0
MII1_RXD1_2: MII1_RXD1
MII1_RXD2_2: MII1_RXD2
MII1_RXD3_2: MII1_RXD3
MII1_RXDV_2: MII1_RXDV
MII1_RXERR_2: MII1_RXERR
MII1_TXCLK_2: MII1_TXCLK
MII1_TXD0_2: MII1_TXD0
MII1_TXD1_2: MII1_TXD1
MII1_TXD2_2: MII1_TXD2
MII1_TXD3_2: MII1_TXD3
MII1_TXEN_2: MII1_TXEN
SYS_RESETn_2: SYS_RESETn
VDD_3V3B_10, VDD_3V3B_11: VDD_3V3B
VDD_PHYA: VDD
VDD_PHYA_2, VDD_PHYA_3: VDD

Notes on the sheet:
BeagleBone~Black~Ethernet
450-5500-001
March~~8,~1995
=Date
CAP~CER~10UF~10V~Y5V~0805
CAP_10uF_Y5V_10V_10%_0805
805
RES_0_1/16W_1%_0402
402
CAP_1.0uF_X5R_10V_10%_0402
CAP,~CER,~X7R,~0402,~50V,~10%,~0.1uF
CAP,~CER,~X7R,~0402,~10V,~10%,~0.1uF
RES_4.75K_1/16W_1%_0402
CAP_30PF_COG_50V_5%_0402
QFN32_5X5MM_EP3P3MM
SMSC~LAN8710A-EZK
RES_1M_1/16W_1%_0402
RES_100_1/10W_5%_0402
RES_470_1/10W_5%_0402
RJ45-7499010211A
RES_1.5K_1/16W_5%_0402
RES_10K_1/16W_1%_0402
0603
1/10W
Rohm~MCR03EZPFX1000
AEC-Q200
50V
Murata~GCM1885C1H471JA16D
0402
C0G
FER_180_200_0805
1L0010
Digikey
LI0805H151R-10
Steward
FerriteBead150ohm800mA
RES_12.1K_1/16W_1%_0402
XTAL150SMD_125X196
Suntsu~Freq.~SCS20D48-25.000MHZ
ESD_RING
ACTIVE WHEN AT 100MB
