TheGiraffe/BBB-Schematics-Resources/Other Formats/altium2kicad/P10_HDMI-SchDoc.sch

## KiCad design Other Formats/altium2kicad/P10_HDMI-SchDoc.sch (2020-11-15)

Schematic: P10_HDMI-SchDoc.sch

Parts:
12MHZ_2: 12MHZ
*_10: (no value)
DGND_110, DGND_111, DGND_112, DGND_113, DGND_114, DGND_115, DGND_116: GND
GND_EARTH_5: GND
HDMI_1V8: HDMI_1V8
HDMI_INT_2: HDMI_INT
I2C0_SCL_3: I2C0_SCL
I2C0_SDA_3: I2C0_SDA
IC: 2.2uF,6.3V
LCD_DATA0_3, LCD_DATA0_4: LCD_DATA0
LCD_DATA1_3, LCD_DATA1_4: LCD_DATA1
LCD_DATA2_3, LCD_DATA2_4: LCD_DATA2
LCD_DATA3_3, LCD_DATA3_4: LCD_DATA3
LCD_DATA4_3, LCD_DATA4_4: LCD_DATA4
LCD_DATA5_3, LCD_DATA5_4: LCD_DATA5
LCD_DATA6_3, LCD_DATA6_4: LCD_DATA6
LCD_DATA7_3, LCD_DATA7_4: LCD_DATA7
LCD_DATA8_3, LCD_DATA8_4: LCD_DATA8
LCD_DATA9_3, LCD_DATA9_4: LCD_DATA9
LCD_DATA10_3, LCD_DATA10_4: LCD_DATA10
LCD_DATA11_3, LCD_DATA11_4: LCD_DATA11
LCD_DATA12_3, LCD_DATA12_4: LCD_DATA12
LCD_DATA13_3, LCD_DATA13_4: LCD_DATA13
LCD_DATA14_3, LCD_DATA14_4: LCD_DATA14
LCD_DATA15_3, LCD_DATA15_4: LCD_DATA15
LCD_DE_2: LCD_DE
LCD_HSYNC_2: LCD_HSYNC
LCD_PCLK_2: LCD_PCLK
LCD_VSYNC_2: LCD_VSYNC
SPI1_CS0_2: SPI1_CS0
SPI1_D0_2: SPI1_D0
SPI1_SCLK_2: SPI1_SCLK
SYS_5V_7: SYS_5V
VDD_1V8_6: VDD_1V8
VDD_3V3B_12, VDD_3V3B_13: VDD_3V3B

Notes on the sheet:
BeagleBone~Black~HDMI~Interface
450-5500-001
March~~8,~1995
=Date
DIO_SR305_TH
SOD323
CAP,~CER,~X7R,~0402,~50V,~10%,~0.1uF
CAP_2.2uF_X5R_6.3V_10%_0402
402
Short
TSSOP10
RES_10K_1/16W_1%_0402
RES_1.5K_1/16W_5%_0402
QFN64S9X9P5
polysw200-5638-310
RES_0_1/16W_1%_0402
RES_22.2K_1/16W_1%_0402
CONN19_HDMI
FER_180_200_0805
1L0010
805
Digikey
LI0805H151R-10
Steward
FerriteBead150ohm800mA
GREEN
RED
BLUE
McASP0_ACLKX (Pin A13 Mode 0)
McASP0_AXR2 (Pin C12 Mode 2)
McASP0_FSX (Pin B13 Mode 0)
