TheGiraffe/BBB-Schematics-Resources/Other Formats/altium2kicad/P11_Exp Conn, uSD-SchDoc.sch

## KiCad design Other Formats/altium2kicad/P11_Exp Conn, uSD-SchDoc.sch (2020-11-15)

Schematic: P11_Exp Conn, uSD-SchDoc.sch

Parts:
*_11: (no value)
AIN0_2: AIN0
AIN1_2: AIN1
AIN2_2: AIN2
AIN3_2: AIN3
AIN4_2: AIN4
AIN5_2: AIN5
AIN6_2: AIN6
CLKOUT2_3: CLKOUT2
DGND_117, DGND_118, DGND_119, DGND_120, DGND_121, DGND_122, DGND_123, DGND_124, DGND_125, DGND_126: GND
EHRPWM1A_2: EHRPWM1A
EHRPWM1B_2: EHRPWM1B
EHRPWM2A_2: EHRPWM2A
EHRPWM2B_2: EHRPWM2B
GNDA_ADC_5: GND
GND_EARTH_6: GND
GPIO0_7_2: GPIO0_7
GPIO0_26_2: GPIO0_26
GPIO0_27_2: GPIO0_27
GPIO1_12_2: GPIO1_12
GPIO1_13_2: GPIO1_13
GPIO1_14_2: GPIO1_14
GPIO1_15_2: GPIO1_15
GPIO1_16_2: GPIO1_16
GPIO1_17_2: GPIO1_17
GPIO1_28_2: GPIO1_28
GPIO1_29_2: GPIO1_29
GPIO2_1_2: GPIO2_1
GPIO3_19_2: GPIO3_19
GPIO3_21_3: GPIO3_21
I2C0_SCL_4: I2C0_SCL
I2C0_SDA_4: I2C0_SDA
I2C1_SCL_2: I2C1_SCL
I2C1_SDA_2: I2C1_SDA
I2C2_SCL_2: I2C2_SCL
I2C2_SDA_2: I2C2_SDA
IC: 10K,1%
LCD_DATA0_5: LCD_DATA0
LCD_DATA1_5: LCD_DATA1
LCD_DATA2_5: LCD_DATA2
LCD_DATA3_5: LCD_DATA3
LCD_DATA4_5: LCD_DATA4
LCD_DATA5_5: LCD_DATA5
LCD_DATA6_5: LCD_DATA6
LCD_DATA7_5: LCD_DATA7
LCD_DATA8_5: LCD_DATA8
LCD_DATA9_5: LCD_DATA9
LCD_DATA10_5: LCD_DATA10
LCD_DATA11_5: LCD_DATA11
LCD_DATA12_5: LCD_DATA12
LCD_DATA13_5: LCD_DATA13
LCD_DATA14_5: LCD_DATA14
LCD_DATA15_5: LCD_DATA15
LCD_DE_3: LCD_DE
LCD_HSYNC_3: LCD_HSYNC
LCD_PCLK_3: LCD_PCLK
LCD_VSYNC_3: LCD_VSYNC
MMC0_CD_3: MMC0_CD
MMC0_CLKO_2: MMC0_CLKO
MMC0_CMD_2: MMC0_CMD
MMC0_DAT0_2: MMC0_DAT0
MMC0_DAT1_2: MMC0_DAT1
MMC0_DAT2_2: MMC0_DAT2
MMC0_DAT3_2: MMC0_DAT3
MMC1_CLK_3: MMC1_CLK
MMC1_CMD_3: MMC1_CMD
MMC1_DAT0_3: MMC1_DAT0
MMC1_DAT1_3: MMC1_DAT1
MMC1_DAT2_3: MMC1_DAT2
MMC1_DAT3_3: MMC1_DAT3
MMC1_DAT4_3: MMC1_DAT4
MMC1_DAT5_3: MMC1_DAT5
MMC1_DAT6_3: MMC1_DAT6
MMC1_DAT7_3: MMC1_DAT7
PWR_BUT_2: PWR_BUT
SPI1_CS0_3: SPI1_CS0
SPI1_D0_3: SPI1_D0
SPI1_D1_2: SPI1_D1
SPI1_SCLK_3: SPI1_SCLK
SYS_5V_8, SYS_5V_9: SYS_5V
SYS_RESETn_3: SYS_RESETn
TIMER4_2: TIMER4
TIMER5_2: TIMER5
TIMER6_2: TIMER6
TIMER7_2: TIMER7
UART1_RXD_2: UART1_RXD
UART1_TXD_2: UART1_TXD
UART2_RXD_2: UART2_RXD
UART2_TXD_2: UART2_TXD
UART4_RXD_2: UART4_RXD
UART4_TXD_2: UART4_TXD
VDD_3V3A_13: VDD_3V3A
VDD_3V3B_14, VDD_3V3B_15, VDD_3V3B_16, VDD_3V3B_17: VDD_3V3B
VDD_5V_2, VDD_5V_3: VDD_5V
VDD_ADC_3: VDD

Notes on the sheet:
BeagleBone~Black~Expansion~Headers,~uSD.and~EEPROM
450-5500-001
March~~8,~1995
=Date
CAP~CER~10UF~10V~Y5V~0805
CAP_10uF_Y5V_10V_10%_0805
805
RES_10K_1/16W_1%_0402
402
HEADER23X2
OMRON
4500.0144
224-0332-000
SD-MICRO-SCHA5B0300
CAT24C256W
On~Semiconductor
CAT24C256WI-G
Digikey
1.21
0.27
SOIC8pintbd
1A0225
RES_0_1/16W_1%_0402
tp1-8040
EXPANSION HEADER
Board ID
256KX8
uSD CONNECTOR
CAUTION: USED ON BOARD
