TheGiraffe/BBB-Schematics-Resources/(commit log)

2020-11-15 added the schematics files I was able to find, hopefully will be able to convert to kicad soon
    [BBB_BOM.csv, BBB_Industrial_BOM.csv, BEAGLEBONEBLK_C.DSN, BeagleBone-Black-Cape.kicad_pcb, BeagleBone-Black-Cape.sch, BeagleBoneBlack.pcb, BeagleBone_Black_RevB6_ASSY_XY.xlsx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]
2020-11-15 Altium Designer files, based on imported DSN files. Will try to convert from Altium to KiCad.
    [BEAGLEBONEBLK_C.PrjPcb, BEAGLEBONEBLK_C_Library.SchLib, P01_Title Page.SchDoc, P02_Power Management.SchDoc, P03_AM335x 1_3, JTAG.SchDoc, P04_AM335x 2_3, USB.SchDoc, P05_AM335x 3_3.SchDoc, P06_LED, Config.SchDoc]
2020-11-15 found a PADS ACII version online as well, will try putting that into Altium. The conversion from the other kind worked okish but is a bit of a mess and thigns are missing, so maybe this one will work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
    [P01_Title Page-SchDoc-2020-11-15-00-42-23.sch, P01_Title Page-SchDoc.sch, P01_Title Page.SchDoc, P02_Power Management-SchDoc.sch, P02_Power Management.SchDoc, P03_AM335x 1_3, JTAG-SchDoc.sch, P03_AM335x 1_3, JTAG.SchDoc, P04_AM335x 2_3, USB-SchDoc.sch]
2020-11-15 so the ASCII file that I found didn't actually have anything useful contained in it, thus the current approach will be to fill in all the missing information in the kicad schematics generated using a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
    [BeagleBoneBlack.csv]
2020-11-15 so the pdf to kicad tool didn't work as I had hoped either, I guess I will just have to fill in the gaps on the other kicad files I generated.
2020-11-15 added BBB cape kicad template to the main folder so that it's easily accessible since it may be useful
    [BeagleBone-Black-Cape.kicad_pcb, BeagleBone-Black-Cape.sch]
2020-11-18 snapeda models finally available
    [P01_Title Page-SchDoc-2020-11-15-00-42-23.sch, P01_Title Page-SchDoc.sch, P01_Title Page.SchDoc, P02_Power Management-SchDoc.sch, P02_Power Management.SchDoc, P03_AM335x 1_3, JTAG-SchDoc.sch, P03_AM335x 1_3, JTAG.SchDoc, P04_AM335x 2_3, USB-SchDoc.sch]
